SlaybaughLab/NIF_TNF_ETA/AsConstructed/Pics/Pics/Build1_15.jpg

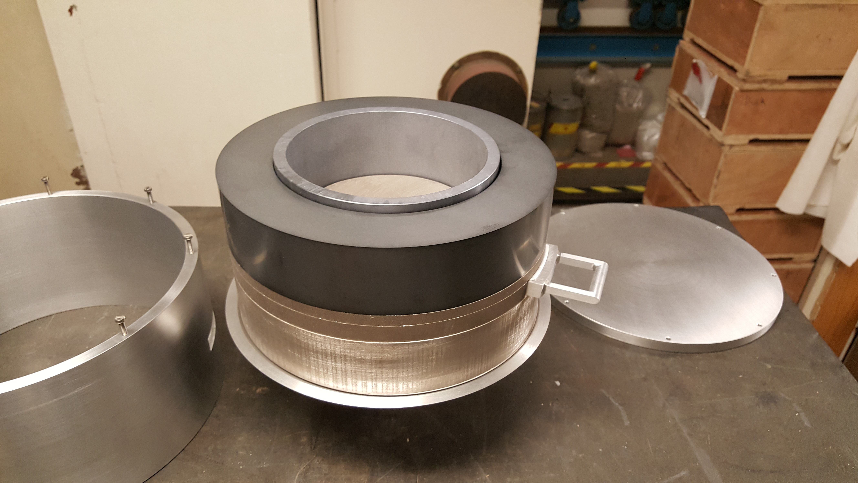
AsConstructed/Pics/Pics/Build1_15.jpg
