SlaybaughLab/NIF_TNF_ETA/README.md

# NIF_TNF_ETA
Files and models pertaining to the NIF technical nuclear forensics relevant ETA design

Contains
- Coues optimization inputs
- Coues optimization results and optimization history
- Engineering design change history and calculations
- CAD Models
- MCNP models
- Purchase documentation
