SlaybaughLab/NIF_TNF_ETA/AsConstructed/Plots/DPLUS_NIF_Spectrum.xlsx

Ebins | Nφ (n/cm2/src)
4.1399e-07 | 0
1.1253e-06 | 0
3.059e-06 | 0
1.0677e-05 | 0
2.9023e-05 | 2.049142865e-06
0.0001013 | 5.475043922e-06
0.00027536 | 5.184504351e-05
0.00058295 | 7.257542149e-05
0.0012341 | 0.0001356223635
0.0033546 | 0.0003378589862
0.010333 | 0.001431766824
0.021875 | 0.003682208308
0.024788 | 0.001050071611
0.034307 | 0.004819021139
0.052475 | 0.006794245399
0.11109 | 0.03135825653
0.15764 | 0.029007202
0.24724 | 0.04928293802
0.36883 | 0.06802948531
0.55023 | 0.0903172405
0.63928 | 0.04098251884
0.74274 | 0.04517834735
0.82085 | 0.03124598612
0.96164 | 0.05191853663
1.108 | 0.04648686331
1.4227 | 0.0757298235
1.8268 | 0.07184725941
2.3069 | 0.057593946
2.3852 | 0.007478118206
3.0119 | 0.04303795698
4.0657 | 0.03737023537
4.7237 | 0.01368997899
4.9659 | 0.003852857395
6.3763 | 0.01653024627
7.4082 | 0.008559772517
8.1873 | 0.005068655988
9.0484 | 0.005020305252
10 | 0.005631700306
11.052 | 0.006606451141
12.214 | 0.006479627161
12.523 | 0.001991034951
13.84 | 0.02424272049
14.191 | 0.1027588518
14.918 | 0.004288768289
16.905 | 2.981306371e-05
19.64 | 1.763008045e-06
