SlaybaughLab/NIF_TNF_ETA/AsConstructed/Plots/NIF Spectra.xlsx

 | SRC: Charlie Cerjan |  |  |  | Differential Flux |  | Lethargy
Energy (MeV) | N120405 Neutron Number (n) | Norm n | φ | Norm φ | dφ/dE | Norm dφ/dE | dφ/dLn[E] | Norm dφ/dLn[E]
1.038553e-06 | 0 | 0 | 0 | 0 | 0 | 0 | 0 | 0
1.11863e-06 | 0 | 0 | 0 | 0 | 0 | 0 | 0 | 0
1.204882e-06 | 0 | 0 | 0 | 0 | 0 | 0 | 0 | 0
1.297785e-06 | 0 | 0 | 0 | 0 | 0 | 0 | 0 | 0
1.39785e-06 | 0 | 0 | 0 | 0 | 0 | 0 | 0 | 0
1.505632e-06 | 0 | 0 | 0 | 0 | 0 | 0 | 0 | 0
1.621724e-06 | 0 | 0 | 0 | 0 | 0 | 0 | 0 | 0
1.746767e-06 | 0 | 0 | 0 | 0 | 4.228030379e+25 | 4.432080796e-06 | 7.666583564e+19 | 6.187456675e-13
1.881451e-06 | 6003293 | 6.179823806e-08 | 5.694480436e+18 | 2.439530876e-11 | 3.925332899e+25 | 4.114774729e-06 | 7.666521101e+19 | 6.187406263e-13
2.026521e-06 | 0 | 0 | 0 | 0 | 0 | 0 | 0 | 0
2.182776e-06 | 0 | 0 | 0 | 0 | 0 | 0 | 0 | 0
2.351079e-06 | 0 | 0 | 0 | 0 | 0 | 0 | 0 | 0
2.532359e-06 | 0 | 0 | 0 | 0 | 0 | 0 | 0 | 0
2.727616e-06 | 0 | 0 | 0 | 0 | 0 | 0 | 0 | 0
2.93793e-06 | 0 | 0 | 0 | 0 | 0 | 0 | 0 | 0
3.164459e-06 | 0 | 0 | 0 | 0 | 0 | 0 | 0 | 0
3.408454e-06 | 0 | 0 | 0 | 0 | 0 | 0 | 0 | 0
3.671264e-06 | 0 | 0 | 0 | 0 | 0 | 0 | 0 | 0
3.954337e-06 | 0 | 0 | 0 | 0 | 0 | 0 | 0 | 0
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
