SlaybaughLab/NIF_TNF_ETA/InitialQuoted/Drawings/ETA.png

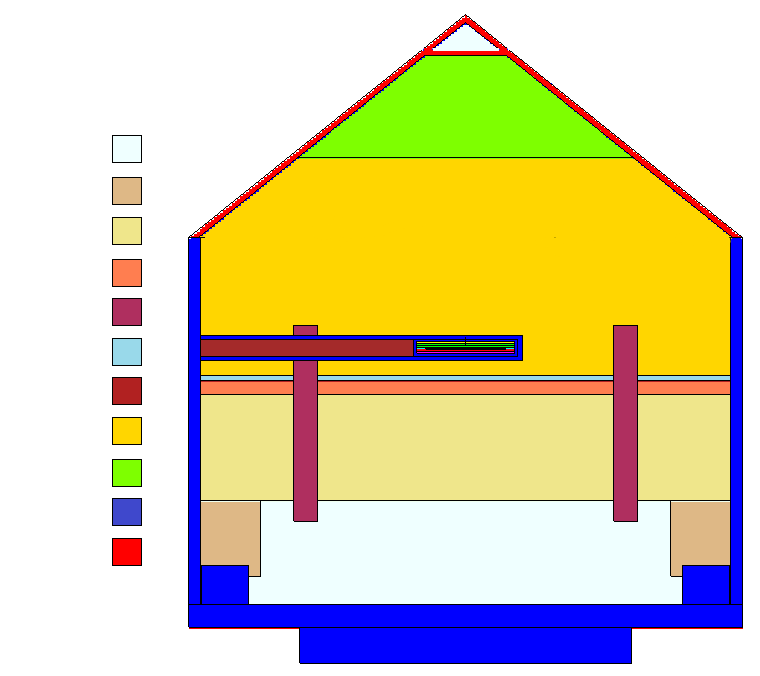
InitialQuoted/Drawings/ETA.png
