SlaybaughLab/NIF_TNF_ETA/InitialQuoted/Drawings/ETA_Design/Slide1.PNG

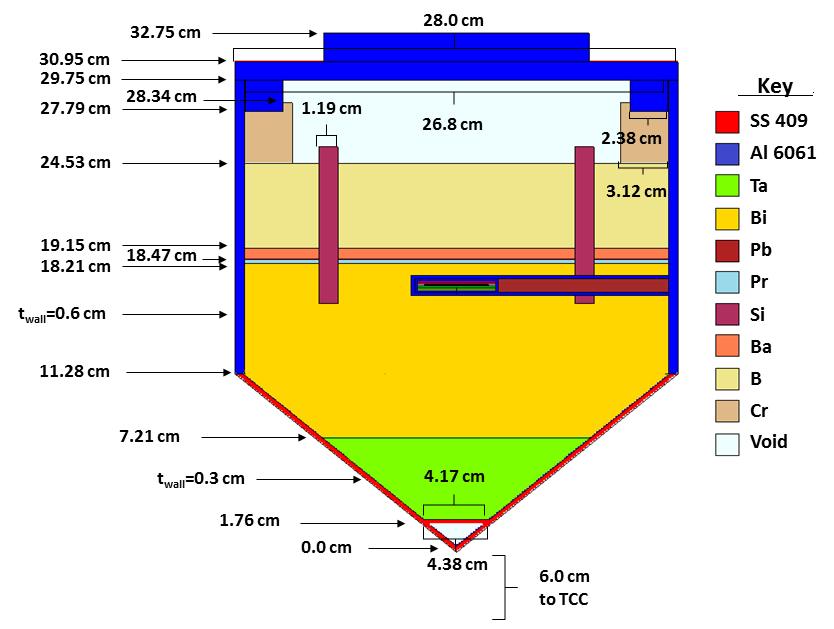
InitialQuoted/Drawings/ETA_Design/Slide1.PNG
