SlaybaughLab/NIF_TNF_ETA/InitialQuoted/Drawings/ETA_Design/Slide2.PNG

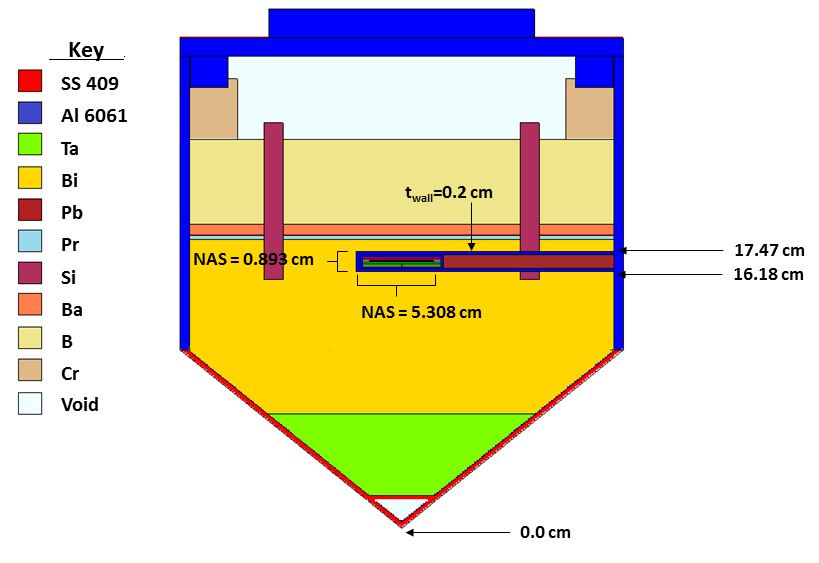
InitialQuoted/Drawings/ETA_Design/Slide2.PNG
