SlaybaughLab/NIF_TNF_ETA/InitialQuoted/Drawings/ETA_Design/Slide3.PNG

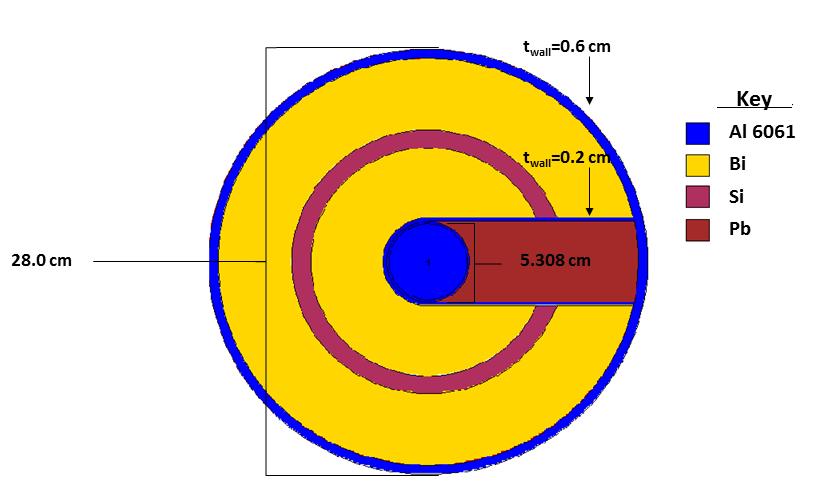
InitialQuoted/Drawings/ETA_Design/Slide3.PNG
