SlaybaughLab/NIF_TNF_ETA/InitialQuoted/Drawings/ETA_XY.png

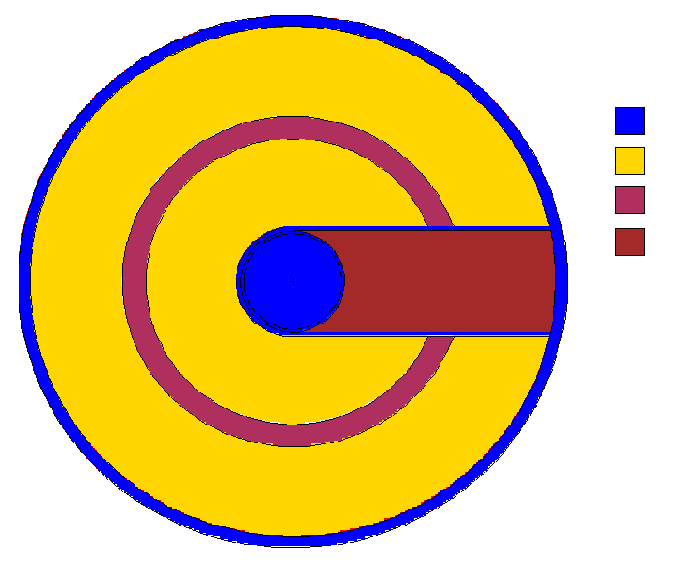
InitialQuoted/Drawings/ETA_XY.png
