SlaybaughLab/NIF_TNF_ETA/InitialQuoted/w_Dim/Plots/ETA_Output_NPhi.png

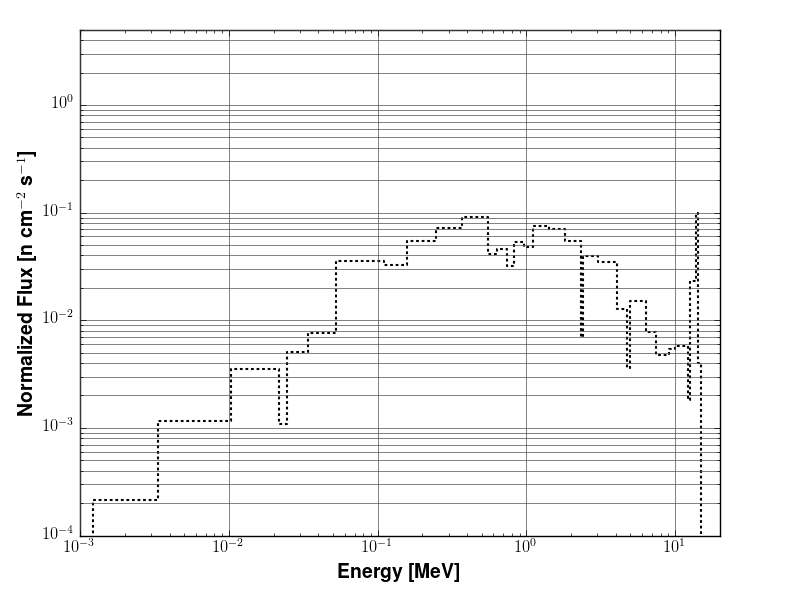
InitialQuoted/w_Dim/Plots/ETA_Output_NPhi.png
