SlaybaughLab/NIF_TNF_ETA/InitialQuoted/w_Dim/Plots/ETA_OutputComp_NPhi.png

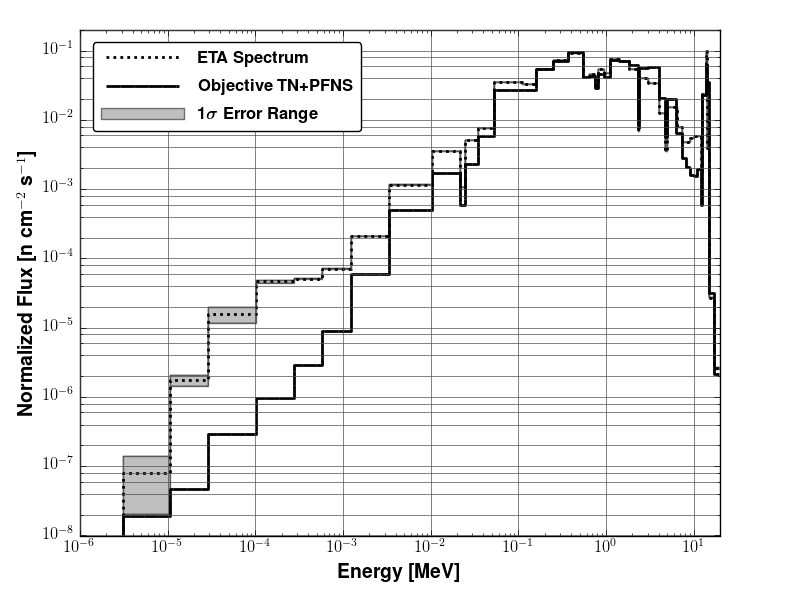
InitialQuoted/w_Dim/Plots/ETA_OutputComp_NPhi.png
