SlaybaughLab/NIF_TNF_ETA/InitialQuoted/w_Dim/Plots/ETA_R=0_Cut.png

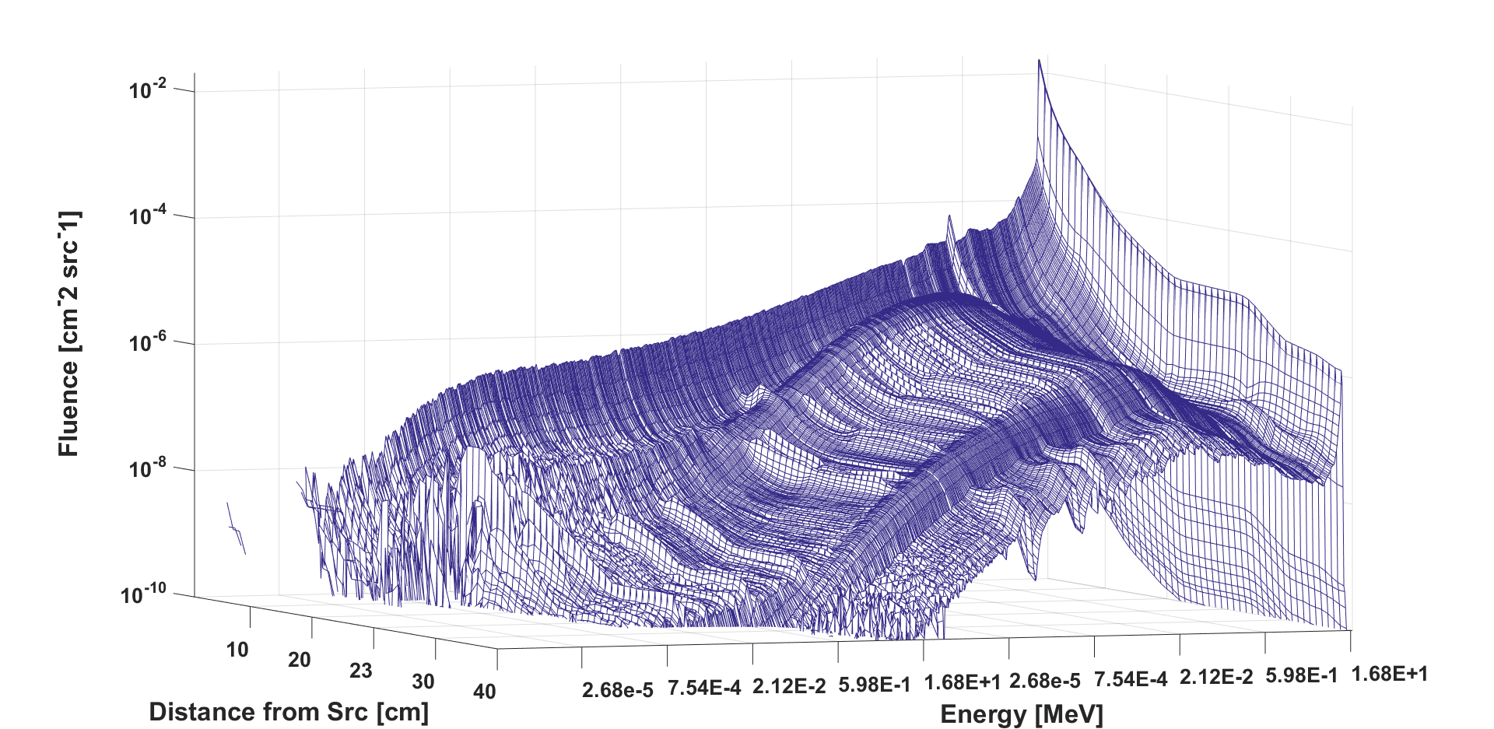
InitialQuoted/w_Dim/Plots/ETA_R=0_Cut.png
