SlaybaughLab/NIF_TNF_ETA/InitialQuoted/w_Dim/Plots/ETA_Z=28.85_Cut.png

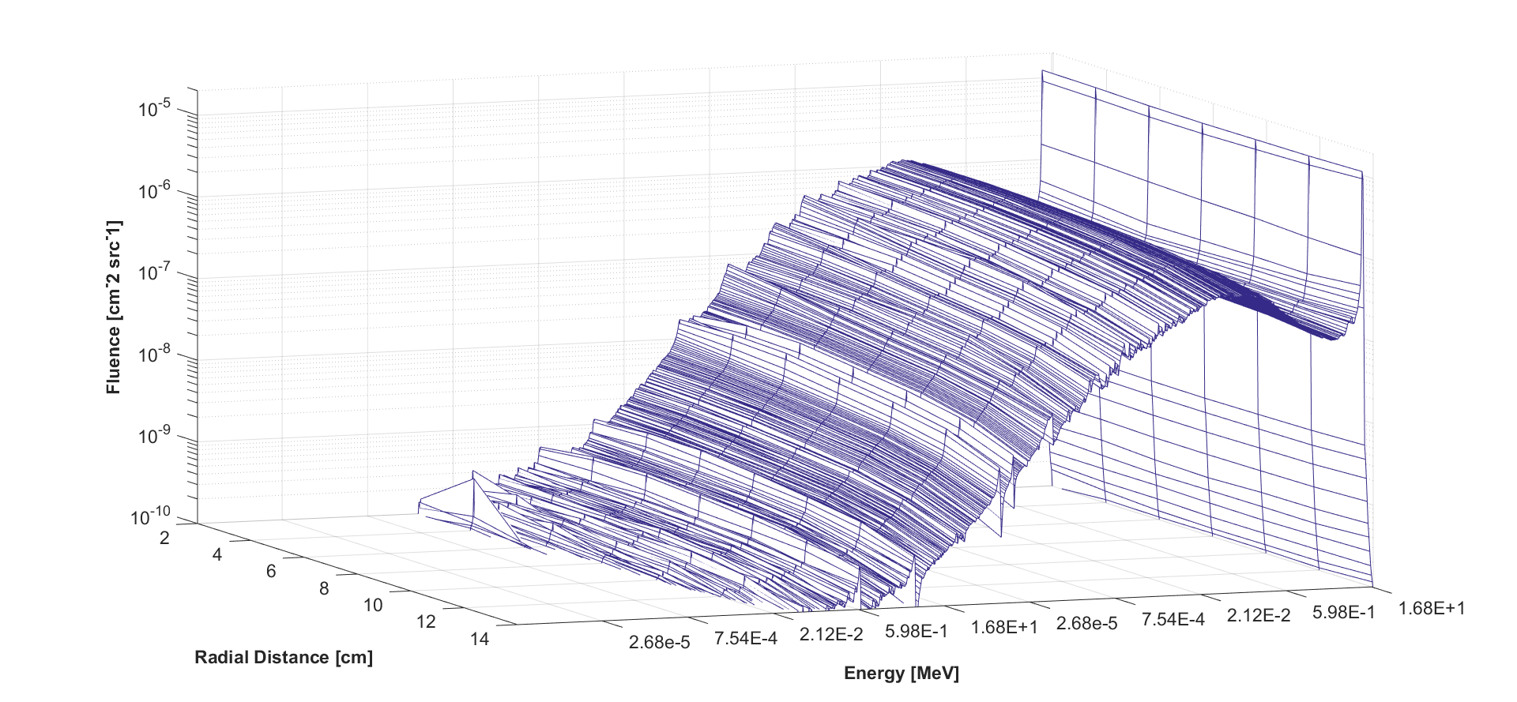
InitialQuoted/w_Dim/Plots/ETA_Z=28.85_Cut.png
