SlaybaughLab/NIF_TNF_ETA/InitialQuoted/w_Dim/Plots/FluxVsZ/ETA_24Jun16_z=2.bmp

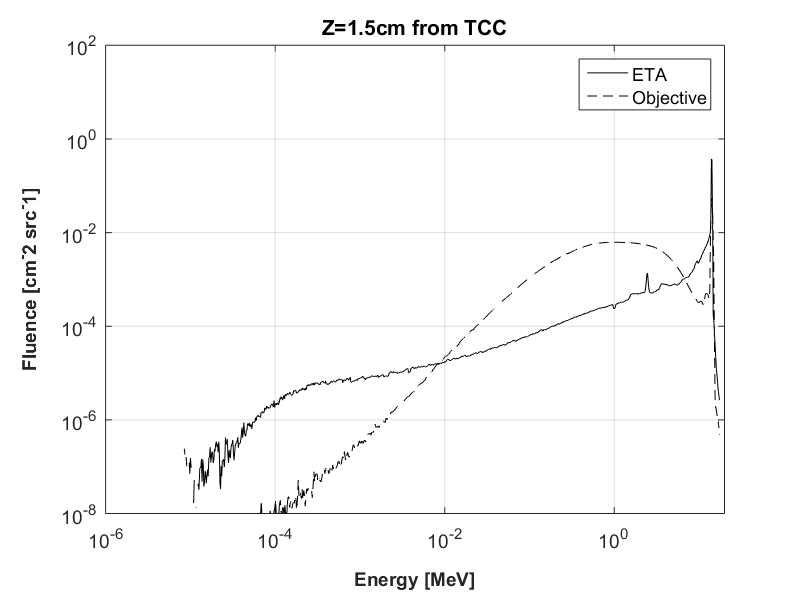
InitialQuoted/w_Dim/Plots/FluxVsZ/ETA_24Jun16_z=2.bmp
