SlaybaughLab/NIF_TNF_ETA/InitialQuoted/w_Dim/Plots/FluxVsZ/ETA_24Jun16_z=18.bmp

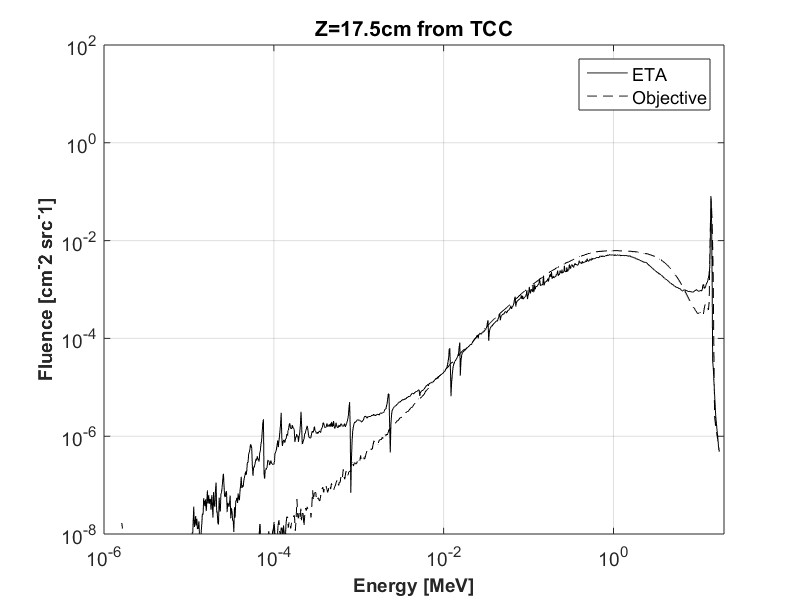
InitialQuoted/w_Dim/Plots/FluxVsZ/ETA_24Jun16_z=18.bmp
