SlaybaughLab/NIF_TNF_ETA/InitialQuoted/w_Dim/Plots/FluxVsZ/ETA_DPLUS_24Jun16_z=9.bmp

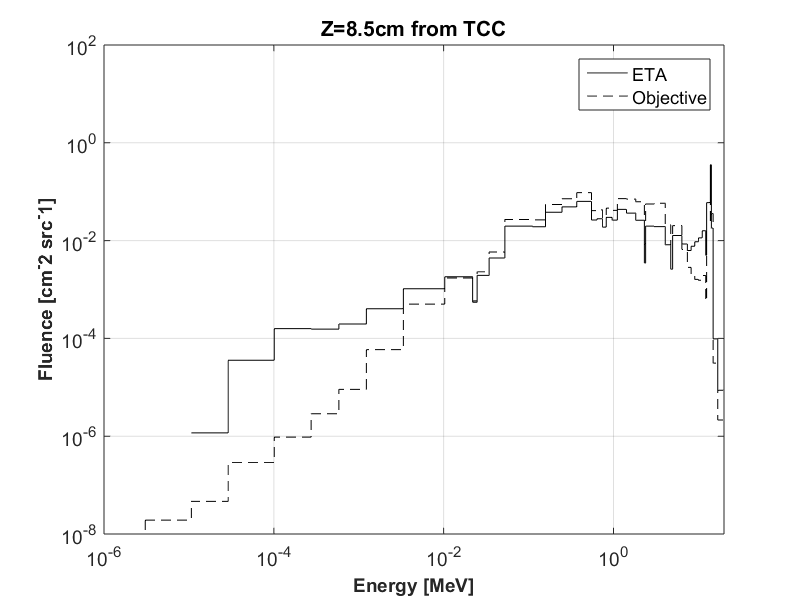
InitialQuoted/w_Dim/Plots/FluxVsZ/ETA_DPLUS_24Jun16_z=9.bmp
