SlaybaughLab/NIF_TNF_ETA/InitialQuoted/w_Dim/Plots/GroupFlux/ETA_24Jun16_PeakVsWatt.bmp

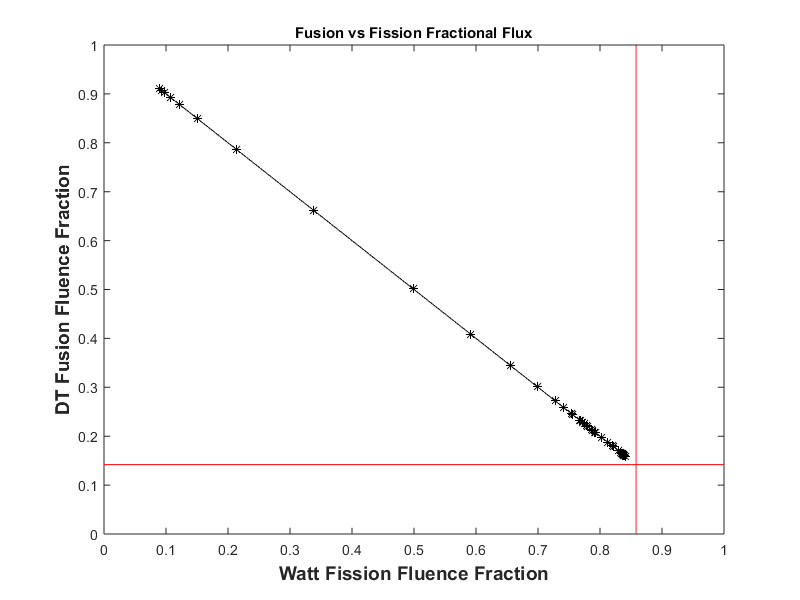
InitialQuoted/w_Dim/Plots/GroupFlux/ETA_24Jun16_PeakVsWatt.bmp
