SlaybaughLab/NIF_TNF_ETA/InitialQuoted/Purchasing/ETA_B4CQuote.pdf

The World’s Manufacturer of Engineered & Advanced Materials
MERELEX CORPORATION • 10884 WEYBURN AVE. LOS ANGELES, CA 90024
TEL. 310-208-0551 • FAX 310-208-0351 • E-MAIL: orders@americanelements.com

Customer Service Representative
Keri Keinath
Telephone: 310-208-3003
Fax: 310-564-1892
Email: keri.keinath@americanelements.com

James Bevins
University of California, Berkeley 4173 Etcheverry Hall

8657558090

DATE: | August 18, 2016
QUOTE VALIDITY: | September 1, 2016
RE: | Boron Carbide Plate
SHIPPING TERMS: | FOB Los Angeles, CA

160818KK06

Boron Carbide Plate | Formula: B4C
Diameter: 267mm
Thickness: 13.45mm
4 pieces | $1,707.27/pc

QUOTATION:

### PHONE:

TO:

MATERIAL | DESCRIPTION | QTY | UNIT PRICE

PN: BO-C-025M-PL
Purity: 99.5%

Shipping (Estimated)

United States

Berkeley, CA 94720

EMAIL: | jbevins1@berkeley.edu

TBD

PAYMENT TERMS: | Net 30 Days

This quotation is subject to American Elements' General Terms & Conditions. American Elements' general terms and conditions can be found on the back of this document, or if it is being transmitted electronically, a complete copy can always be reviewed and printed at www.americanelements.com/generalterms.pdf. © 2001-2014. American Elements. All rights reserved.
AECFORM 32:87 REV. APP. 9/15/04
