SlaybaughLab/NIF_TNF_ETA/InitialQuoted/Purchasing/ETA_MaterialsQuote.pdf

The World’s Manufacturer of Engineered & Advanced Materials
MERELEX CORPORATION • 10884 WEYBURN AVE. LOS ANGELES, CA 90024
TEL. 310-208-0551 • FAX 310-208-0351 • E-MAIL: orders@americanelements.com

Customer Service Representative
Keri Keinath
Telephone: 310-208-3003
Fax: 310-564-1892
Email: keri.keinath@americanelements.com

James Bevins
University of California, Berkeley 4173 Etcheverry Hall

8657558090

DATE: | August 12, 2016
QUOTE VALIDITY: | August 26, 2016
RE: | Aluminum Metal Plate
SHIPPING TERMS: | FOB Los Angeles, CA

160812KK02

Aluminum Metal Plate | OD: 267mm
ID: 219mm
Thickness: 19.6mm
1 piece | $432.22/pc

Boron Metal Plate

Barium Metal Plate

Diameter: 267mm
Thickness: 18mm

Diameter: 267mm
Thickness: 6.8mm

3 pieces

1 piece

$9,200.53/pc

$2,548.55/pc

QUOTATION:

### PHONE:

TO:

MATERIAL | DESCRIPTION | QTY | UNIT PRICE

PN: AL-M-03M-PL

PN: BO-M-03M-PL

PN: BA-M-03M-PL

Purity: 99.9% (metals basis)

Purity: 99.9% (metals basis)

Purity: 99.9% (metals basis)

Shipping (Estimated)

United States

Berkeley, CA 94720

EMAIL: | jbevins1@berkeley.edu

TBD

PAYMENT TERMS: | Net 30 Days

*Price valid upon purchasing all items quoted

This quotation is subject to American Elements' General Terms & Conditions. American Elements' general terms and conditions can be found on the back of this document, or if it is being transmitted electronically, a complete copy can always be reviewed and printed at www.americanelements.com/generalterms.pdf. © 2001-2014. American Elements. All rights reserved.
AECFORM 32:87 REV. APP. 9/15/04

The World’s Manufacturer of Engineered & Advanced Materials
MERELEX CORPORATION • 10884 WEYBURN AVE. LOS ANGELES, CA 90024
TEL. 310-208-0551 • FAX 310-208-0351 • E-MAIL: orders@americanelements.com

Customer Service Representative
Keri Keinath
Telephone: 310-208-3003
Fax: 310-564-1892
Email: keri.keinath@americanelements.com

James Bevins
University of California, Berkeley 4173 Etcheverry Hall

8657558090

DATE: | August 12, 2016
QUOTE VALIDITY: | August 26, 2016
RE: | Aluminum Metal Plate
SHIPPING TERMS: | FOB Los Angeles, CA

160812KK02

Bismuth Metal Plate | OD (upper): 165.9mm
OD (bottom): 267mm
Height: 40.7mm
1 piece | $3,385.80/pc

Bismuth Metal Plate

Bismuth Metal Plate

Diameter: 267mm
Thickness: 49mm

Diameter: 267mm
Thickness: 7.4mm

1 piece

1 piece

$1,656.10/pc

$1,545.69/pc

QUOTATION:

### PHONE:

TO:

MATERIAL | DESCRIPTION | QTY | UNIT PRICE

PN: BI-M-03M-PL

PN: BI-M-03M-PL

PN: BI-M-03M-PL

Purity: 99.9% (metals basis)

Purity: 99.9% (metals basis)

Purity: 99.9% (metals basis)

Shipping (Estimated)

United States

Berkeley, CA 94720

EMAIL: | jbevins1@berkeley.edu

TBD

PAYMENT TERMS: | Net 30 Days

*Price valid upon purchasing all items quoted

The World’s Manufacturer of Engineered & Advanced Materials
MERELEX CORPORATION • 10884 WEYBURN AVE. LOS ANGELES, CA 90024
TEL. 310-208-0551 • FAX 310-208-0351 • E-MAIL: orders@americanelements.com

Customer Service Representative
Keri Keinath
Telephone: 310-208-3003
Fax: 310-564-1892
Email: keri.keinath@americanelements.com

James Bevins
University of California, Berkeley 4173 Etcheverry Hall

8657558090

DATE: | August 12, 2016
QUOTE VALIDITY: | August 26, 2016
RE: | Aluminum Metal Plate
SHIPPING TERMS: | FOB Los Angeles, CA

160812KK02

Chromium Metal Plate | OD: 267mm
ID: 204mm
Thickness: 38.1mm
1 piece | $4,342.65/pc

Lead Metal Plate

Praseodymium Metal Plate

Size: 133.5mm x 53.2mm
Thickness: 8.9mm

Diameter: 267mm
Thickness: 2.6mm

1 piece

1 piece

$184.01/pc

$2,208.13/pc

QUOTATION:

### PHONE:

TO:

MATERIAL | DESCRIPTION | QTY | UNIT PRICE

PN: CR-M-03M-PL

PN: PB-M-03M-PL

PN: PR-M-025M-PL

Purity: 99.9% (metals basis)

Purity: 99.9% (metals basis)

Purity: 99.5% (metals basis)

Shipping (Estimated)

United States

Berkeley, CA 94720

EMAIL: | jbevins1@berkeley.edu

TBD

PAYMENT TERMS: | Net 30 Days

*Price valid upon purchasing all items quoted

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

James Bevins
University of California, Berkeley 4173 Etcheverry Hall

8657558090

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

160812KK02

Silicon Metal Plate | OD: 174mm
ID: 150mm
Thickness: 4.7mm
1 piece | $312.82/pc

Silicon Metal Plate

Silicon Metal Plate

OD: 174mm
ID: 150mm
Thickness: 12.9

OD: 174mm
ID: 150mm
Thickness: 81.1

1 piece

1 piece

$364.34/pc

$736.04/pc

QUOTATION:

### PHONE:

TO:

MATERIAL | DESCRIPTION | QTY | UNIT PRICE

PN: SI-M-03M-PL

PN: SI-M-03M-PL

PN: SI-M-03M-PL

Purity: 99.9% (metals basis)

Purity: 99.9% (metals basis)

Purity: 99.5% (metals basis)

Shipping (Estimated)

United States

Berkeley, CA 94720

EMAIL: | jbevins1@berkeley.edu

TBD

PAYMENT TERMS: | Net 30 Days

*Price valid upon purchasing all items quoted

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

James Bevins
University of California, Berkeley 4173 Etcheverry Hall

8657558090

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

160812KK02

Tantalum Metal Plate | OD (upper): 41.12mm
OD (bottom): 169mm
Height: 51.5mm
1 piece | $18,392.06/pc

QUOTATION:

### PHONE:

TO:

MATERIAL | DESCRIPTION | QTY | UNIT PRICE

PN: TA-M-03M-PL
Purity: 99.9% (metals basis)

Shipping (Estimated)

United States

Berkeley, CA 94720

EMAIL: | jbevins1@berkeley.edu

TBD

PAYMENT TERMS: | Net 30 Days

*Price valid upon purchasing all items quoted
