SlaybaughLab/NIF_TNF_ETA/AsConstructed/Purchasing/Machine_Shop_OrderForm.pdf

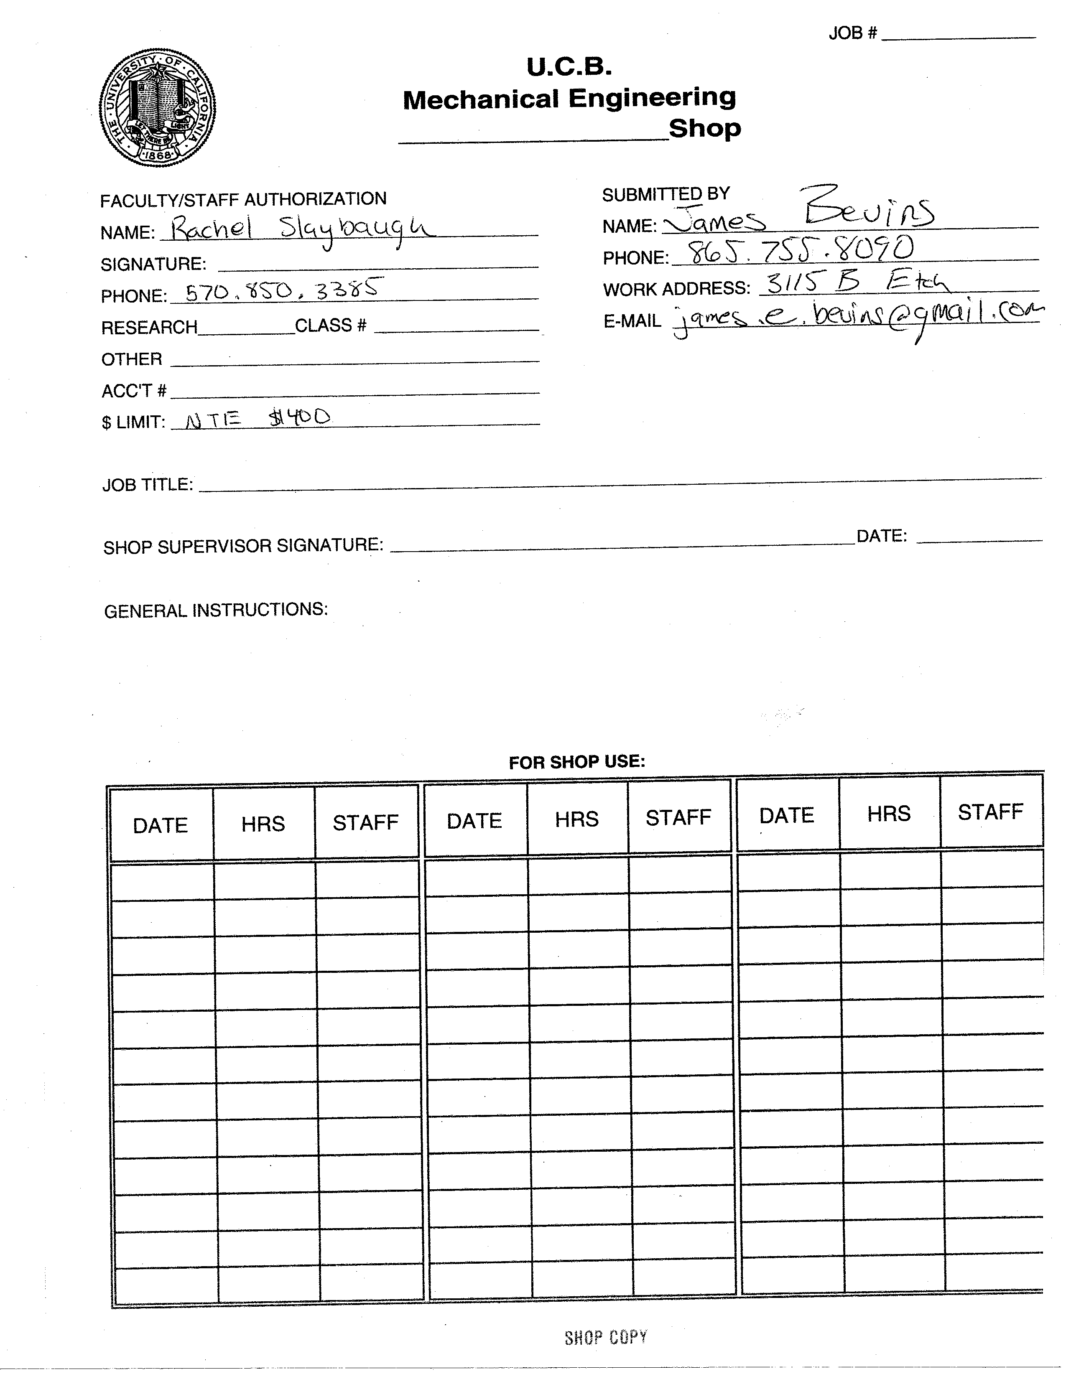
[picture p25: page 1]
