SlaybaughLab/NIF_TNF_ETA/AsConstructed/Purchasing/ETA_Component_Cost Breakdown.xlsx

Part | Materials | Machining | Total
Case1 |  | $2284.20 | $2284.20
Case2 |  | $2983.50 | $2983.50
Case3 |  | $1351.80 | $1351.80
W | $2045.70 | $1124.20 | $3169.90
Bi_1 | $3385.80 | $5657.80 | $9043.60
Bi_2 | $3494.50 | $5316.10 | $8810.60
Bi_3_a/b | $1556.10 | $3753.60 | $5309.70
Bi_4_a/b | $1545.69 | $2486.81 | $4032.50
Si_2 | $364.34 | $1104.06 | $1468.40
Si_3 | $736.04 | $1315.16 | $2051.20
Pr_a/b | $5775.11 | $388.09 | $6163.20
B4C_a/b | $1707.27 | $12510.63 | $14217.90
Drawer Bottom |  | $1305.30 | $1305.30
Drawer Cover |  | $1305.30 | $1305.30
Pb | $184.01 | $1634.09 | $1818.10
Drawer Handle |  | $1538.40 | $1538.40
TOTALS: | $20794.56 | $46059.04 | $66853.60
