SlaybaughLab/NIF_TNF_ETA/AsConstructed/CAD_Models/ETA_3.SLDASM

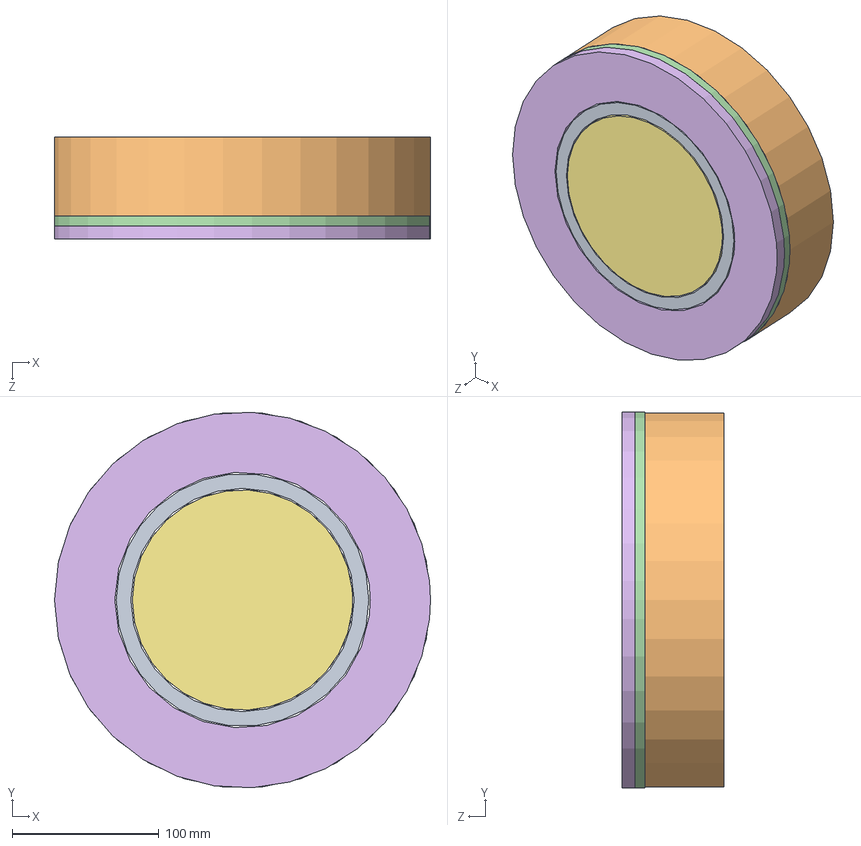
[picture p26: CAD file, 2017-06-17]
AsConstructed/CAD_Models/ETA_3.SLDASM
256.0 x 255.7 x 69.7 mm
Si_3
B4C_a_m
B4C_b_m
Ba_a_m
Ba_b_m
Bi_4a_m
Bi_4b_m
