SlaybaughLab/NIF_TNF_ETA/AsConstructed/CAD_Models/ETA_1.SLDASM

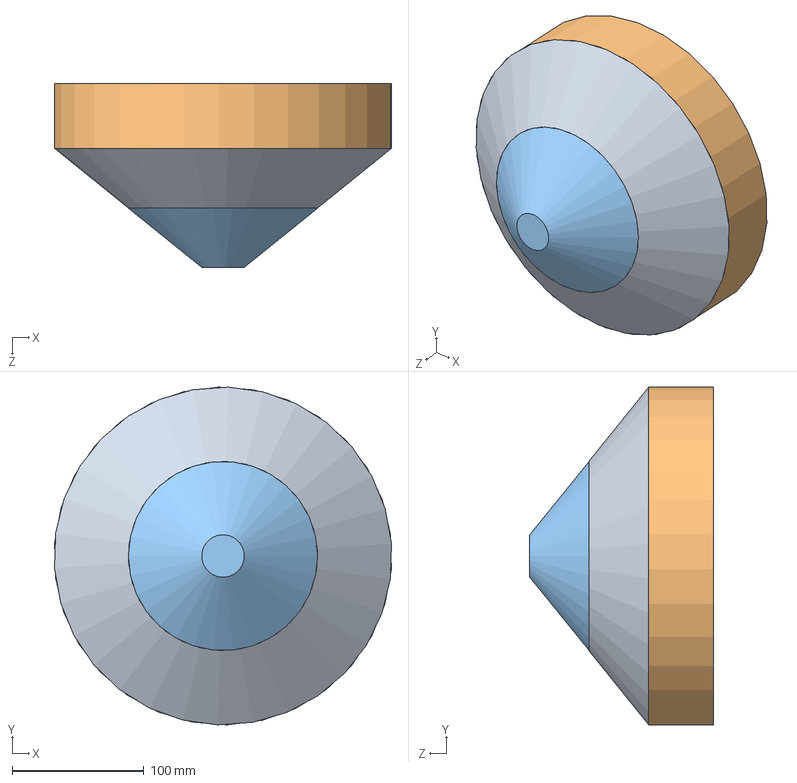
[picture p28: CAD file, 2017-06-17]
AsConstructed/CAD_Models/ETA_1.SLDASM
255.3 x 255.9 x 139.2 mm
Bi_1
Bi_2
W
