SlaybaughLab/NIF_TNF_ETA/InitialQuoted/Drawings/ETA_CAD_Model/ETA_2.SLDASM

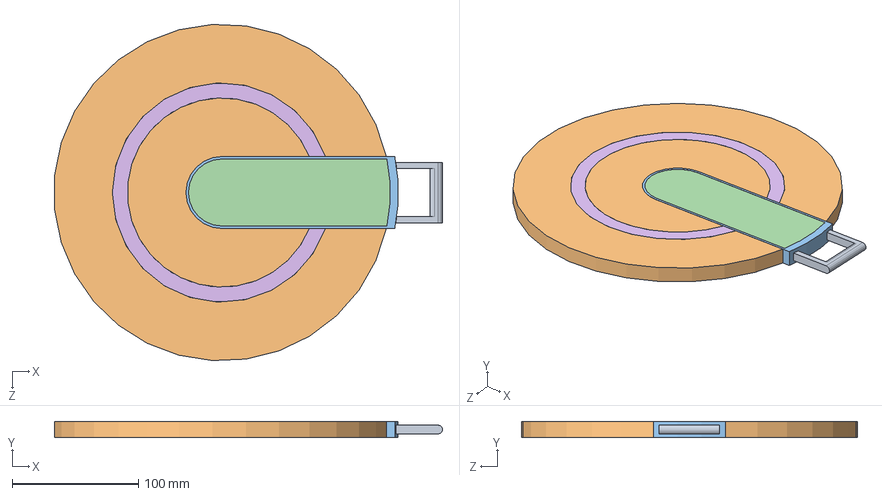
[picture p29: CAD file, 2017-06-17]
InitialQuoted/Drawings/ETA_CAD_Model/ETA_2.SLDASM
307.7 x 13.0 x 266.6 mm
Bi_3_m
Drawer
Drawer_Cover
Pb
Drawer_Handle
Si_2_m
