SlaybaughLab/NIF_TNF_ETA/AsConstructed/CAD_Models/ETA_2.SLDASM

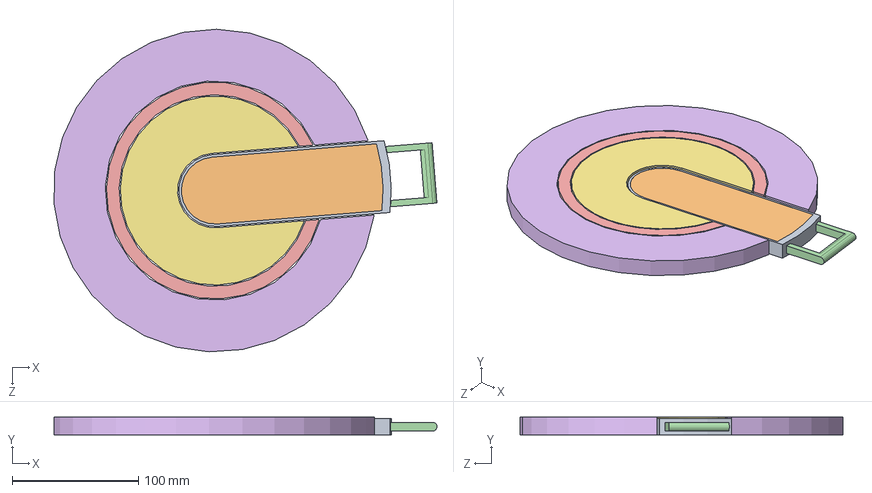
[picture p30: CAD file, 2017-06-17]
AsConstructed/CAD_Models/ETA_2.SLDASM
303.9 x 13.9 x 255.9 mm
Drawer
Drawer_Cover
Pb
Drawer_Handle
Si_2_m
Bi_3a_m
Bi_3b_m
