SlaybaughLab/NIF_TNF_ETA/AsConstructed/CAD_Models/Drawer.SLDASM

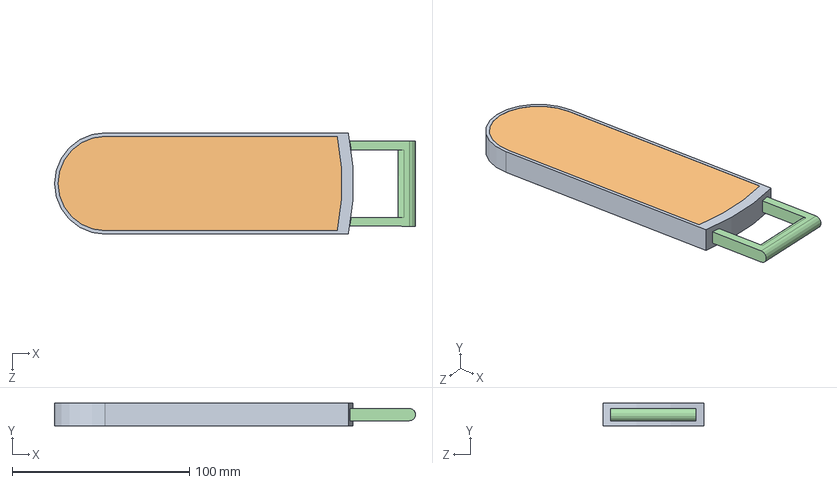
[picture p31: CAD file, 2017-06-17]
AsConstructed/CAD_Models/Drawer.SLDASM
203.5 x 12.9 x 57.1 mm
Drawer
Drawer_Cover
Pb
Drawer_Handle
