SlaybaughLab/NIF_TNF_ETA/InitialQuoted/Drawings/ETA_CAD_Model/ETA_3.SLDASM

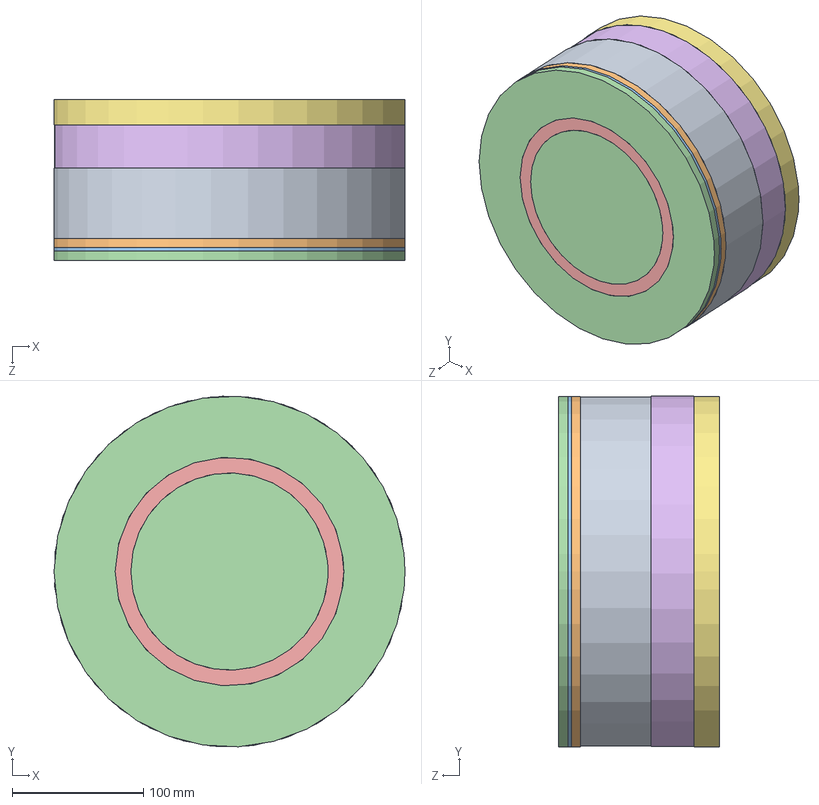
[picture p32: CAD file, 2017-06-17]
InitialQuoted/Drawings/ETA_CAD_Model/ETA_3.SLDASM
267.0 x 266.7 x 122.8 mm
B_m
Ba_m
Pr_m
Bi_4_m
Si_3
Cr_m
Al
