SlaybaughLab/NIF_TNF_ETA/InitialQuoted/Drawings/ETA_CAD_Model/ETA_1.SLDASM

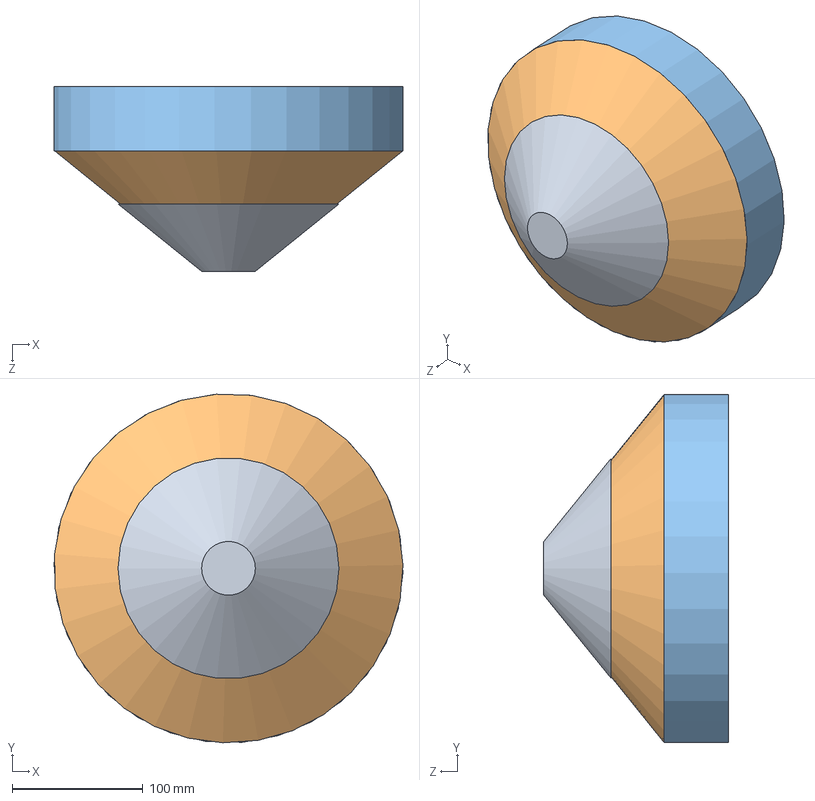
[picture p33: CAD file, 2017-06-17]
InitialQuoted/Drawings/ETA_CAD_Model/ETA_1.SLDASM
266.9 x 266.6 x 141.2 mm
Ta
Bi_1
Bi_2_m
Si_1
