SlaybaughLab/NIF_TNF_ETA/AsConstructed/CAD_Models/Machined Parts/B4C_a_m.SLDPRT

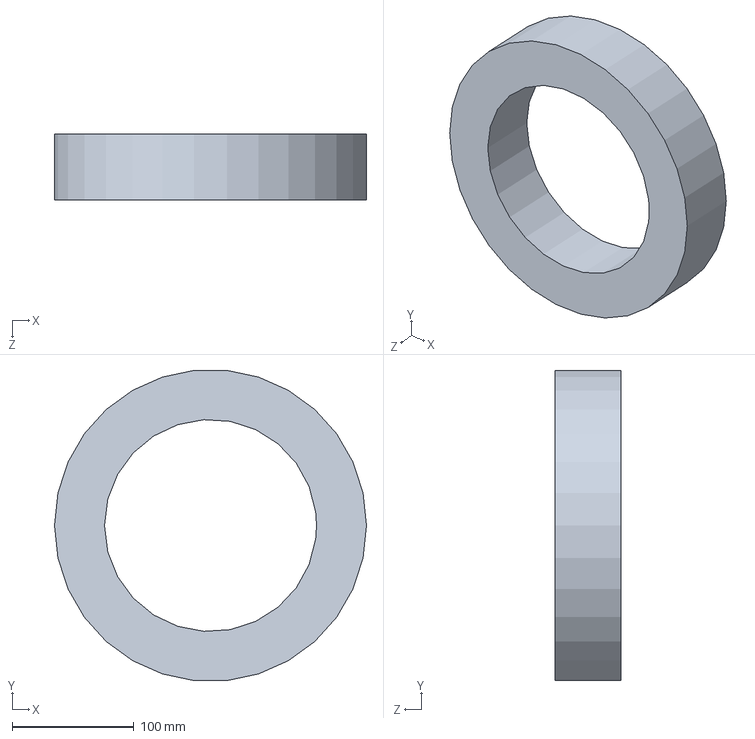
[picture p34: CAD file, 2017-06-17]
AsConstructed/CAD_Models/Machined Parts/B4C_a_m.SLDPRT
256.0 x 254.6 x 53.8 mm
