SlaybaughLab/NIF_TNF_ETA/AsConstructed/CAD_Models/Solid Parts/Pb.SLDPRT

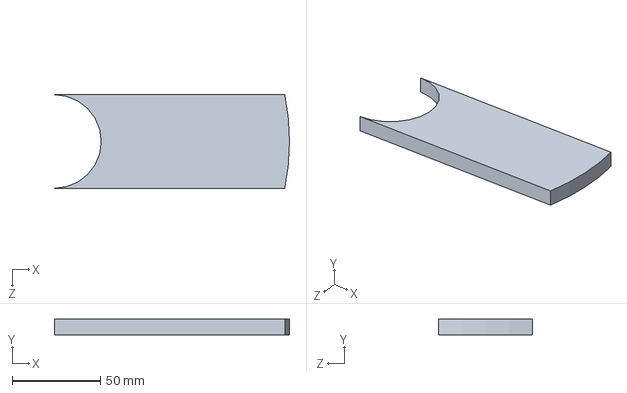
[picture p35: CAD file, 2017-06-17]
AsConstructed/CAD_Models/Solid Parts/Pb.SLDPRT
133.5 x 8.90 x 53.1 mm
