SlaybaughLab/NIF_TNF_ETA/InitialQuoted/Drawings/ETA_CAD_Model/Machined/Case_3.SLDPRT

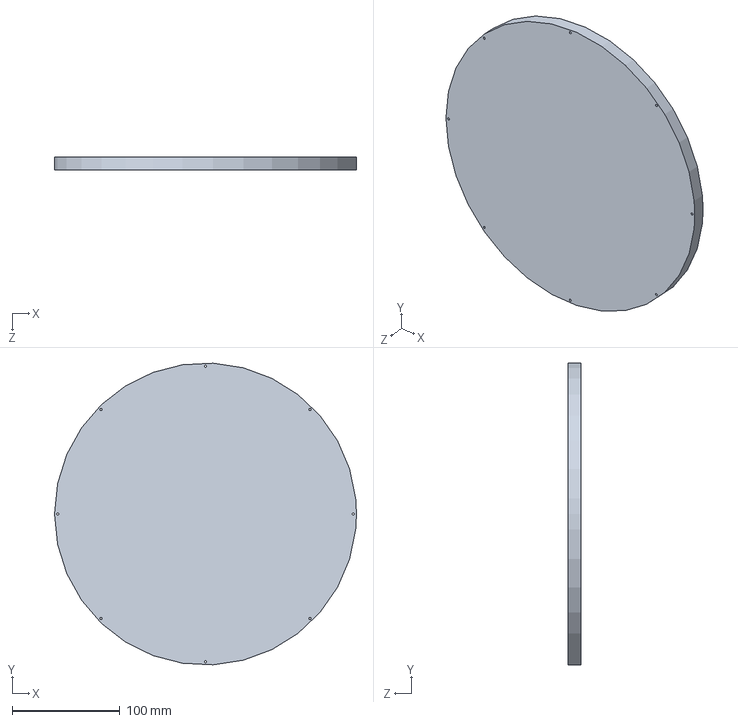
[picture p36: CAD file, 2017-06-17]
InitialQuoted/Drawings/ETA_CAD_Model/Machined/Case_3.SLDPRT
280.0 x 279.6 x 12.0 mm
