SlaybaughLab/NIF_TNF_ETA/InitialQuoted/Drawings/ETA_CAD_Model/Solid/Si_1.SLDPRT

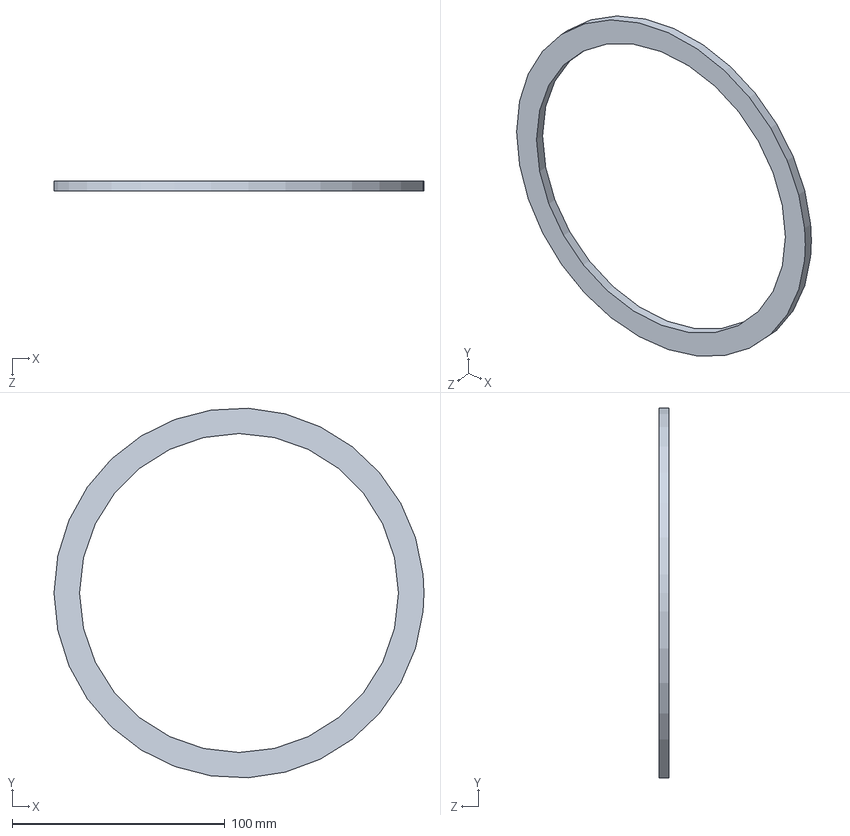
[picture p37: CAD file, 2017-06-17]
InitialQuoted/Drawings/ETA_CAD_Model/Solid/Si_1.SLDPRT
174.0 x 173.8 x 4.70 mm
