SlaybaughLab/NIF_TNF_ETA/AsConstructed/CAD_Models/Machined Parts/Drawer_Cover.SLDPRT

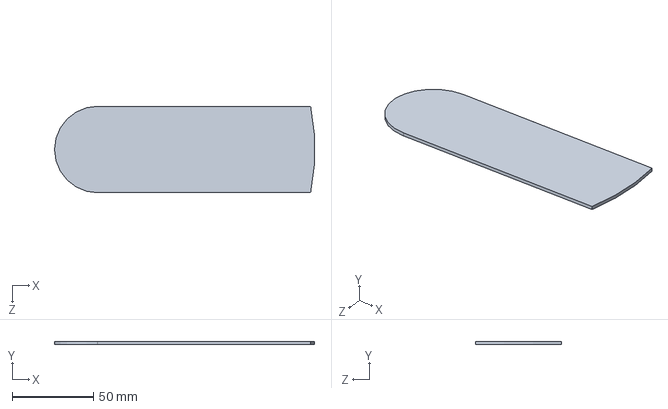
[picture p38: CAD file, 2017-06-17]
AsConstructed/CAD_Models/Machined Parts/Drawer_Cover.SLDPRT
159.8 x 1.95 x 53.1 mm
