SlaybaughLab/NIF_TNF_ETA/AsConstructed/CAD_Models/Solid Parts/B4C.SLDPRT

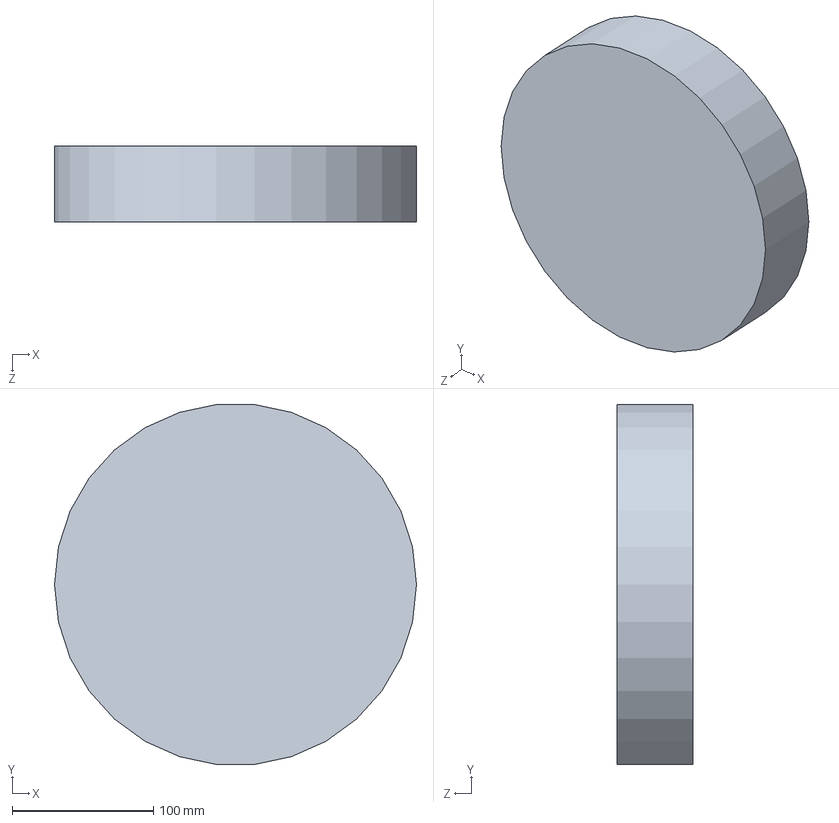
[picture p39: CAD file, 2017-06-17]
AsConstructed/CAD_Models/Solid Parts/B4C.SLDPRT
256.0 x 254.6 x 53.8 mm
