SlaybaughLab/NIF_TNF_ETA/AsConstructed/CAD_Models/Machined Parts/B4C_b_m.SLDPRT

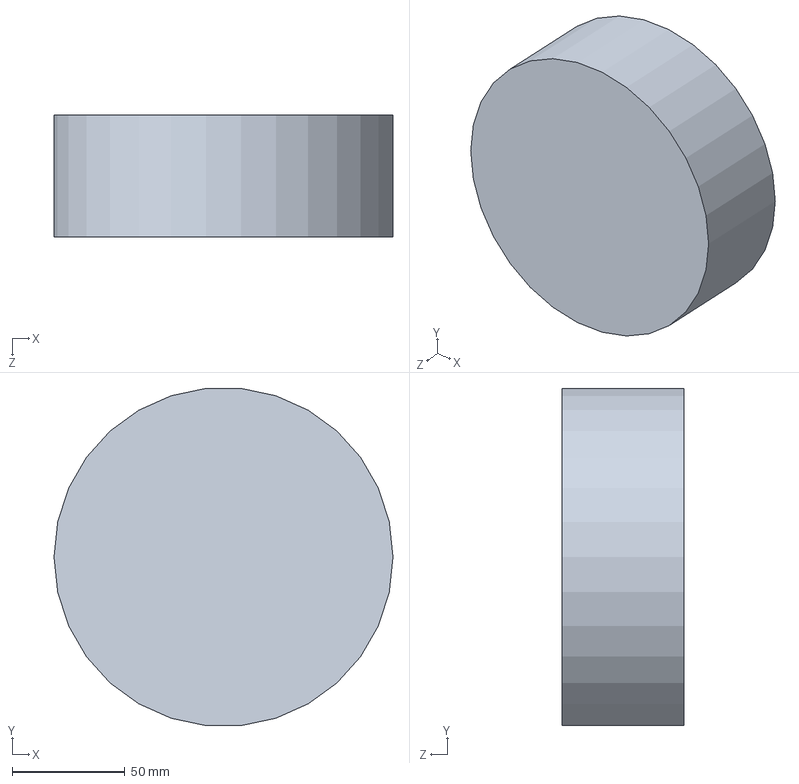
[picture p41: CAD file, 2017-06-17]
AsConstructed/CAD_Models/Machined Parts/B4C_b_m.SLDPRT
150.0 x 149.2 x 53.8 mm
