SlaybaughLab/NIF_TNF_ETA/AsConstructed/CAD_Models/Solid Parts/Bi_2.SLDPRT

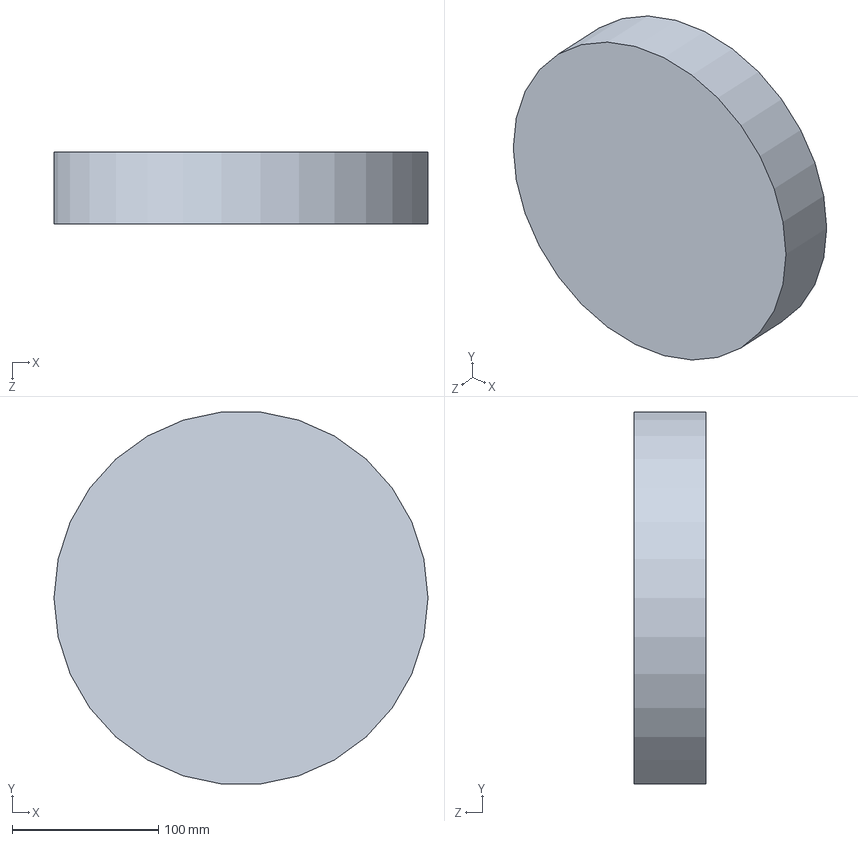
[picture p42: CAD file, 2017-06-17]
AsConstructed/CAD_Models/Solid Parts/Bi_2.SLDPRT
256.0 x 254.6 x 49.0 mm
