SlaybaughLab/NIF_TNF_ETA/InitialQuoted/Drawings/ETA_CAD_Model/Machined/Drawer.SLDPRT

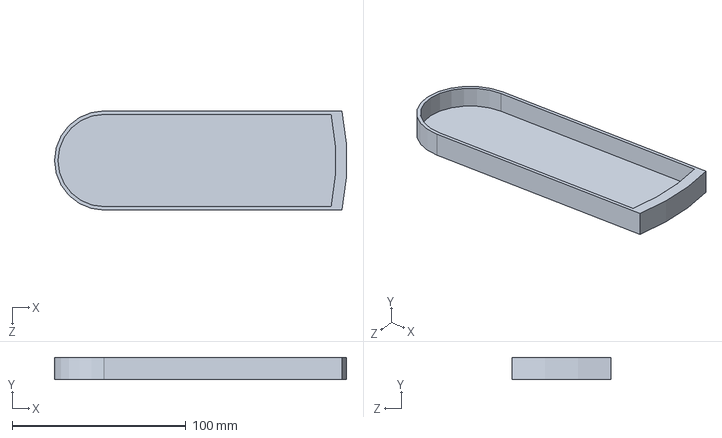
[picture p43: CAD file, 2017-06-17]
InitialQuoted/Drawings/ETA_CAD_Model/Machined/Drawer.SLDPRT
168.2 x 12.9 x 57.1 mm
