SlaybaughLab/NIF_TNF_ETA/InitialQuoted/Drawings/ETA_CAD_Model/Solid/Al.SLDPRT

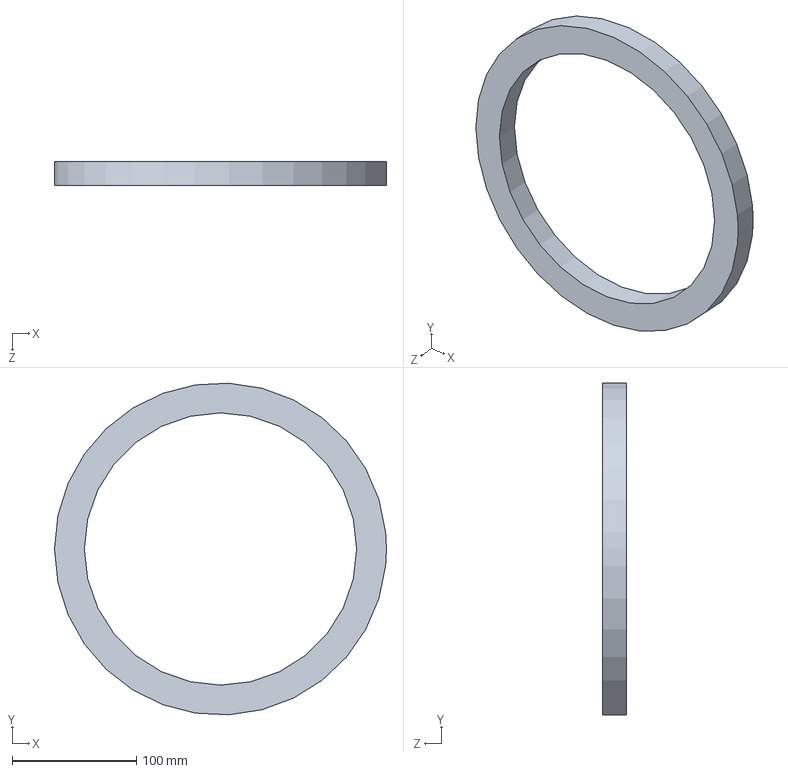
[picture p44: CAD file, 2017-06-17]
InitialQuoted/Drawings/ETA_CAD_Model/Solid/Al.SLDPRT
267.0 x 266.7 x 19.6 mm
