SlaybaughLab/NIF_TNF_ETA/AsConstructed/CAD_Models/Machined Parts/Drawer_Handle.SLDPRT

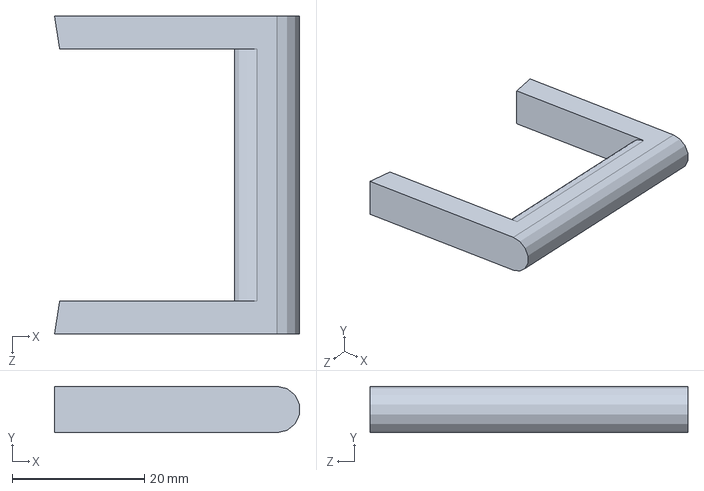
[picture p45: CAD file, 2017-06-17]
AsConstructed/CAD_Models/Machined Parts/Drawer_Handle.SLDPRT
37.0 x 7.00 x 48.0 mm
