SlaybaughLab/NIF_TNF_ETA/AsConstructed/CAD_Models/Solid Parts/Si_2.SLDPRT

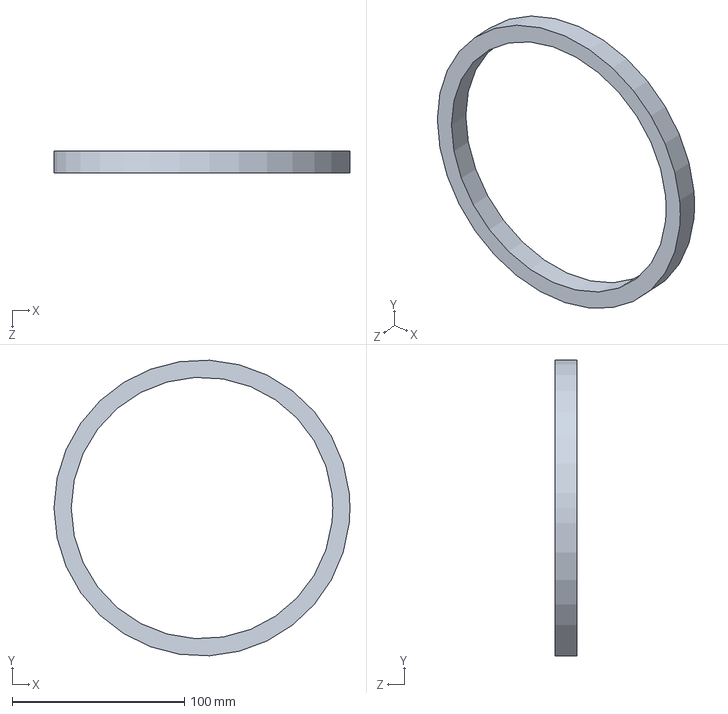
[picture p46: CAD file, 2017-06-17]
AsConstructed/CAD_Models/Solid Parts/Si_2.SLDPRT
172.0 x 171.8 x 13.0 mm
