SlaybaughLab/NIF_TNF_ETA/InitialQuoted/Drawings/ETA_CAD_Model/Machined/B_m.SLDPRT

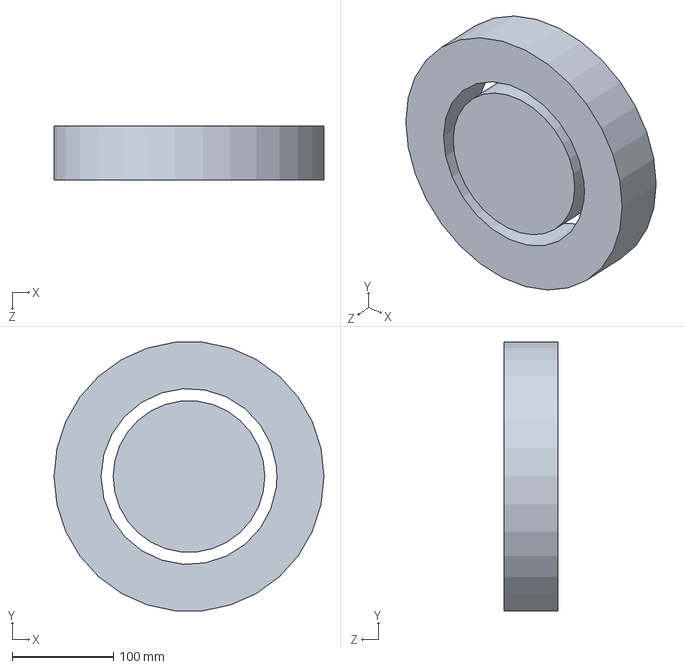
[picture p47: CAD file, 2017-06-17]
InitialQuoted/Drawings/ETA_CAD_Model/Machined/B_m.SLDPRT
267.0 x 265.5 x 53.8 mm
