SlaybaughLab/NIF_TNF_ETA/InitialQuoted/Drawings/ETA_CAD_Model/Solid/Ta.SLDPRT

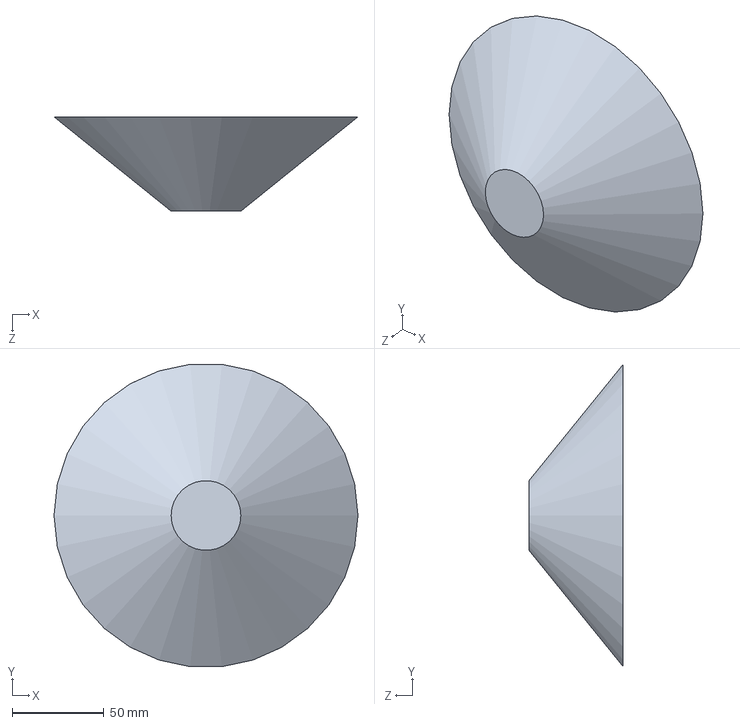
[picture p48: CAD file, 2017-06-17]
InitialQuoted/Drawings/ETA_CAD_Model/Solid/Ta.SLDPRT
165.9 x 165.0 x 51.5 mm
