SlaybaughLab/NIF_TNF_ETA/AsConstructed/CAD_Models/Machined Parts/Bi_4b_m.SLDPRT

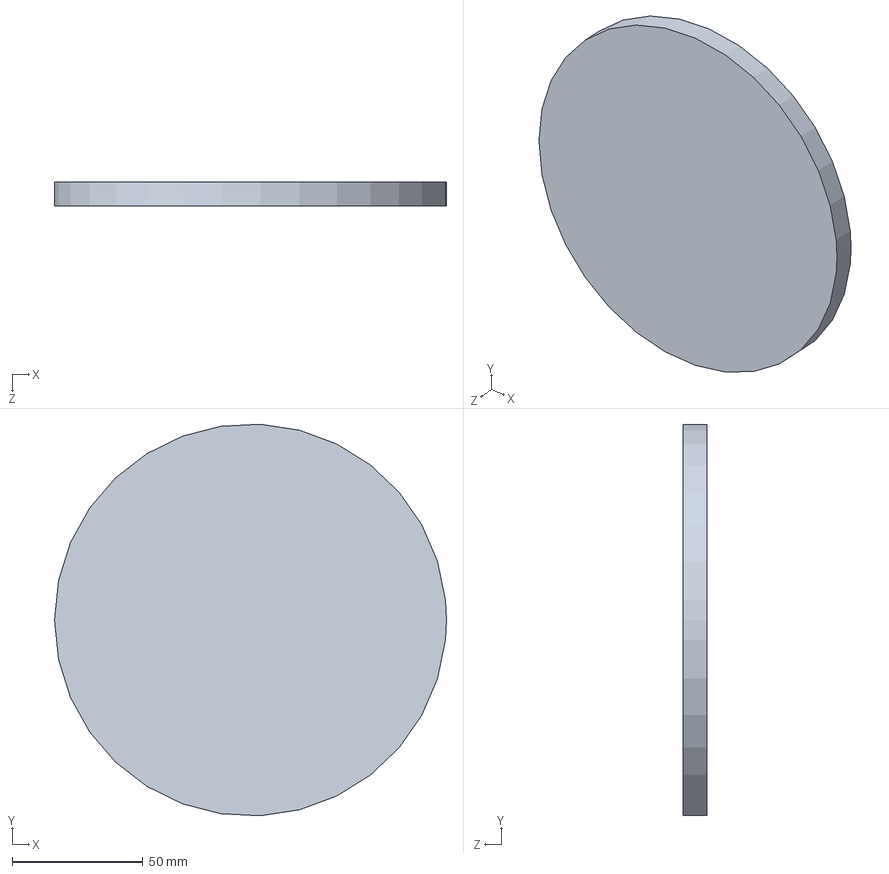
[picture p49: CAD file, 2017-06-17]
AsConstructed/CAD_Models/Machined Parts/Bi_4b_m.SLDPRT
150.0 x 149.8 x 9.10 mm
