SlaybaughLab/NIF_TNF_ETA/AsConstructed/CAD_Models/Solid Parts/Bi_3b.SLDPRT

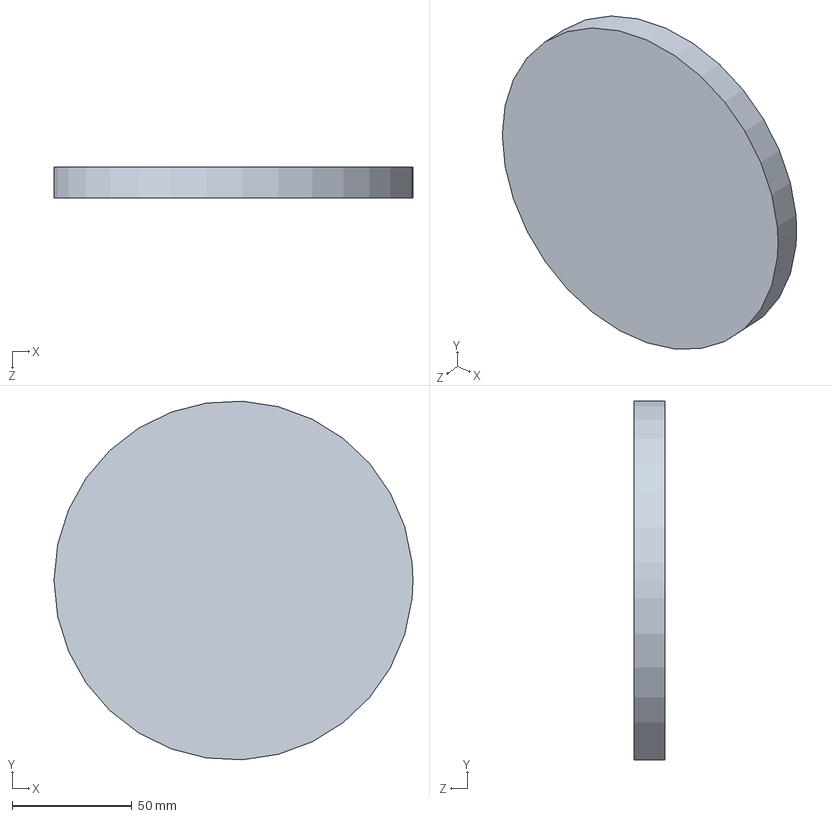
[picture p50: CAD file, 2017-06-17]
AsConstructed/CAD_Models/Solid Parts/Bi_3b.SLDPRT
150.0 x 149.8 x 13.0 mm
