SlaybaughLab/NIF_TNF_ETA/InitialQuoted/Drawings/ETA_CAD_Model/Machined/Bi_3_m.SLDPRT

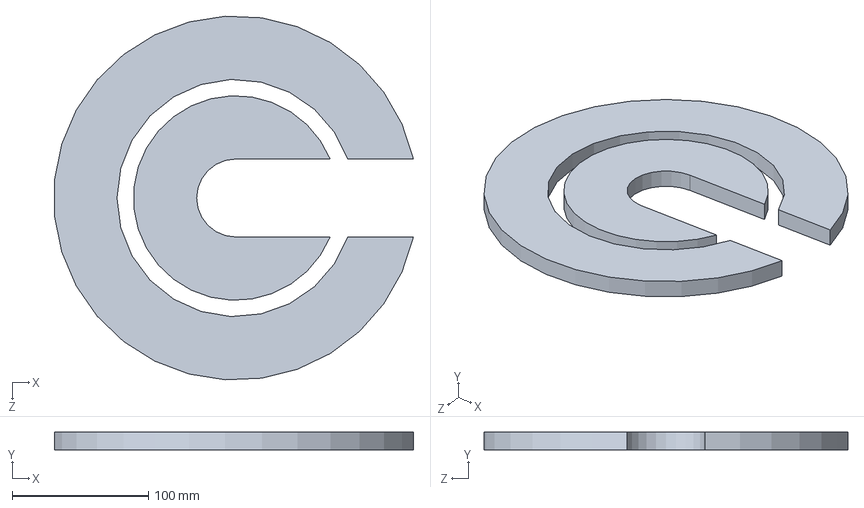
[picture p51: CAD file, 2017-06-17]
InitialQuoted/Drawings/ETA_CAD_Model/Machined/Bi_3_m.SLDPRT
263.2 x 12.9 x 266.6 mm
