SlaybaughLab/NIF_TNF_ETA/InitialQuoted/Drawings/ETA_CAD_Model/Solid/Bi_1.SLDPRT

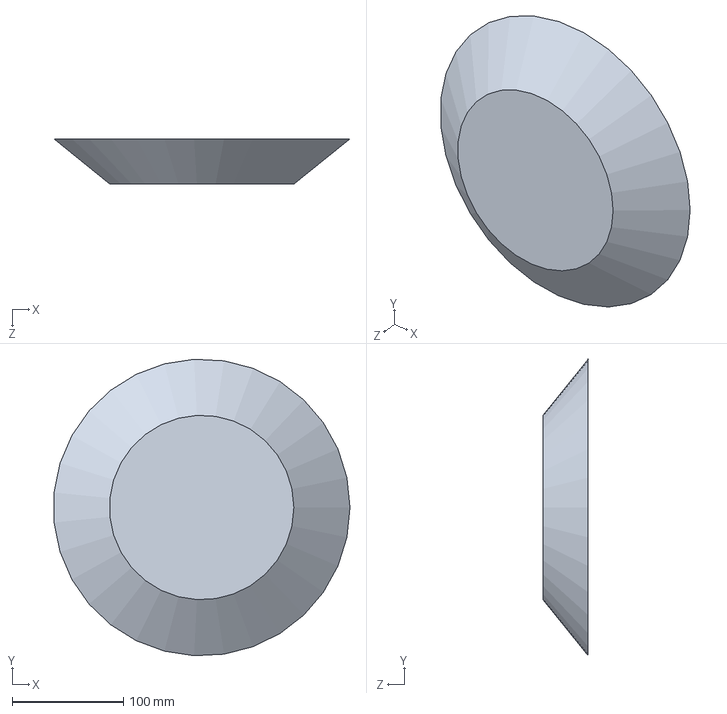
[picture p52: CAD file, 2017-06-17]
InitialQuoted/Drawings/ETA_CAD_Model/Solid/Bi_1.SLDPRT
266.3 x 266.7 x 40.7 mm
