SlaybaughLab/NIF_TNF_ETA/AsConstructed/CAD_Models/Solid Parts/Bi_4.SLDPRT

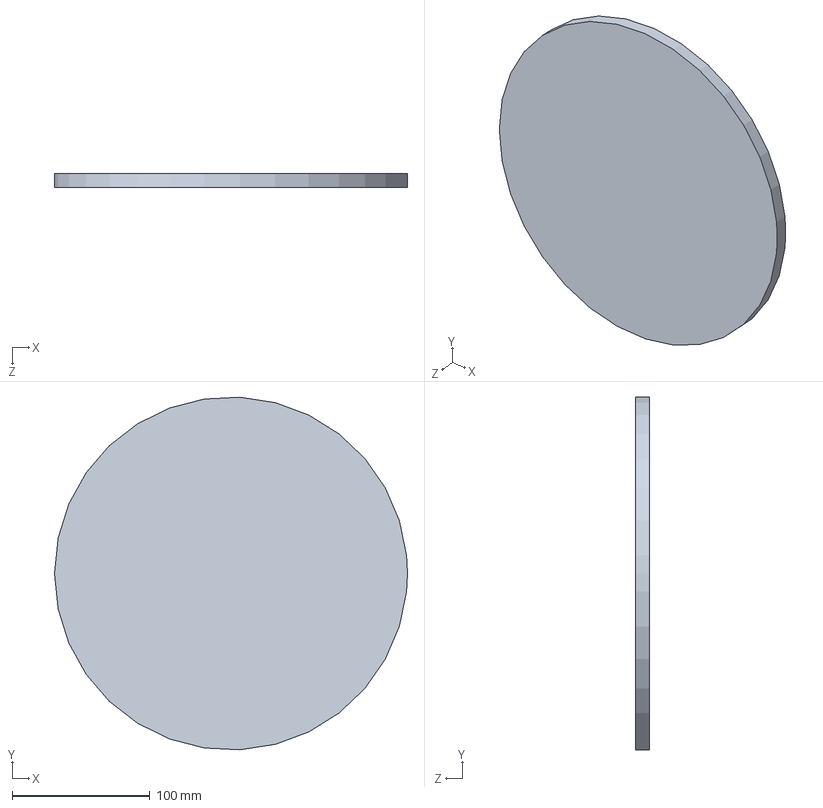
[picture p53: CAD file, 2017-06-17]
AsConstructed/CAD_Models/Solid Parts/Bi_4.SLDPRT
256.0 x 255.7 x 10.0 mm
