SlaybaughLab/NIF_TNF_ETA/InitialQuoted/Drawings/ETA_CAD_Model/Machined/Bi_2_m.SLDPRT

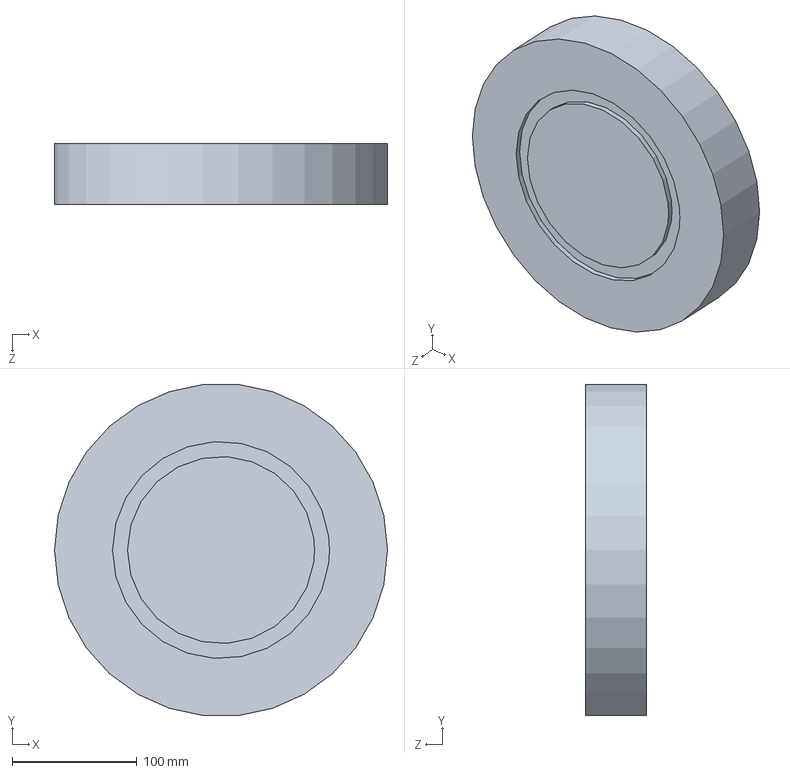
[picture p54: CAD file, 2017-06-17]
InitialQuoted/Drawings/ETA_CAD_Model/Machined/Bi_2_m.SLDPRT
267.0 x 265.5 x 49.0 mm
