SlaybaughLab/NIF_TNF_ETA/InitialQuoted/Drawings/ETA_CAD_Model/Solid/Si_2.SLDPRT

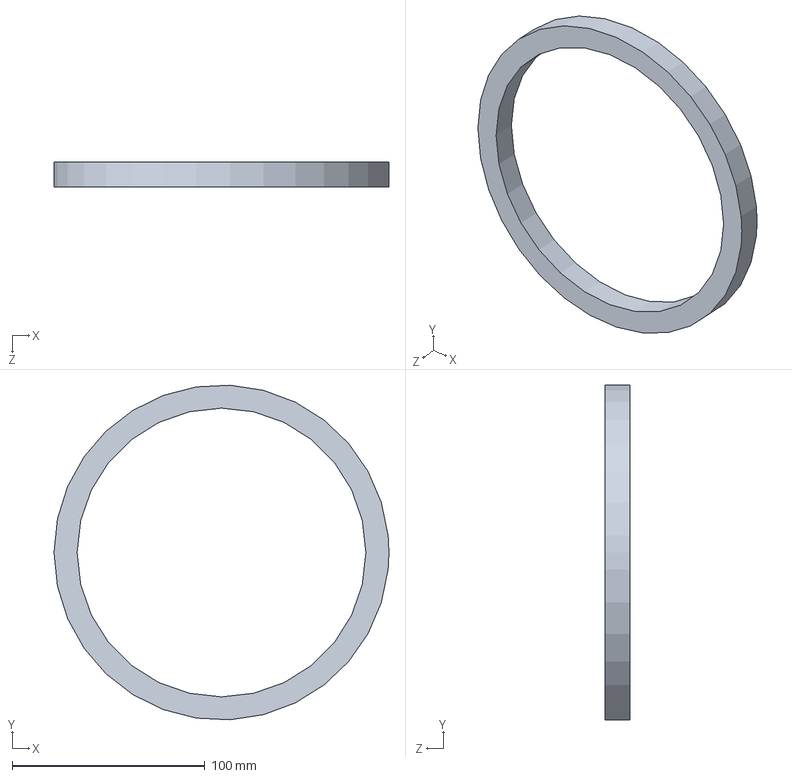
[picture p55: CAD file, 2017-06-17]
InitialQuoted/Drawings/ETA_CAD_Model/Solid/Si_2.SLDPRT
174.0 x 173.8 x 12.9 mm
