SlaybaughLab/NIF_TNF_ETA/AsConstructed/CAD_Models/Machined Parts/Bi_3a_m.SLDPRT

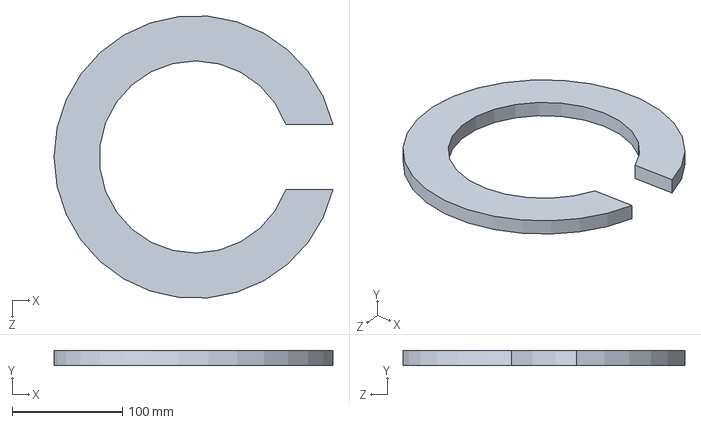
[picture p56: CAD file, 2017-06-17]
AsConstructed/CAD_Models/Machined Parts/Bi_3a_m.SLDPRT
252.5 x 13.9 x 254.9 mm
