SlaybaughLab/NIF_TNF_ETA/AsConstructed/CAD_Models/Solid Parts/Si_3.SLDPRT

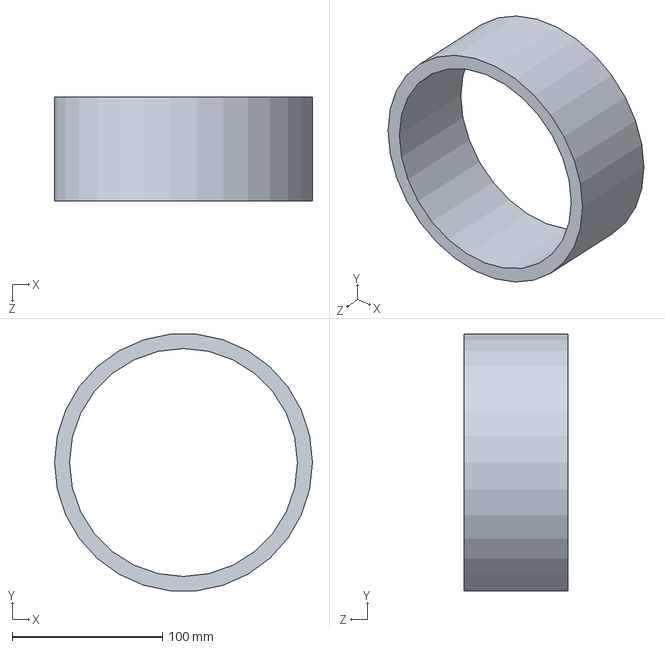
[picture p57: CAD file, 2017-06-17]
AsConstructed/CAD_Models/Solid Parts/Si_3.SLDPRT
172.0 x 171.1 x 69.5 mm
