SlaybaughLab/NIF_TNF_ETA/AsConstructed/CAD_Models/Machined Parts/Si_2_m.SLDPRT

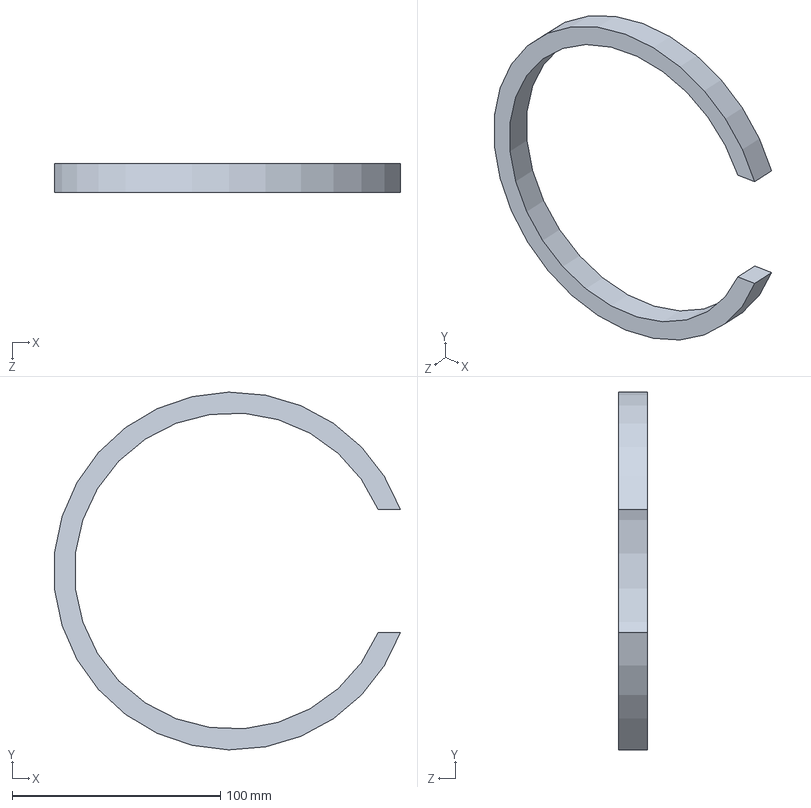
[picture p58: CAD file, 2017-06-17]
AsConstructed/CAD_Models/Machined Parts/Si_2_m.SLDPRT
166.3 x 172.0 x 13.9 mm
