SlaybaughLab/NIF_TNF_ETA/AsConstructed/CAD_Models/Solid Parts/Ba.SLDPRT

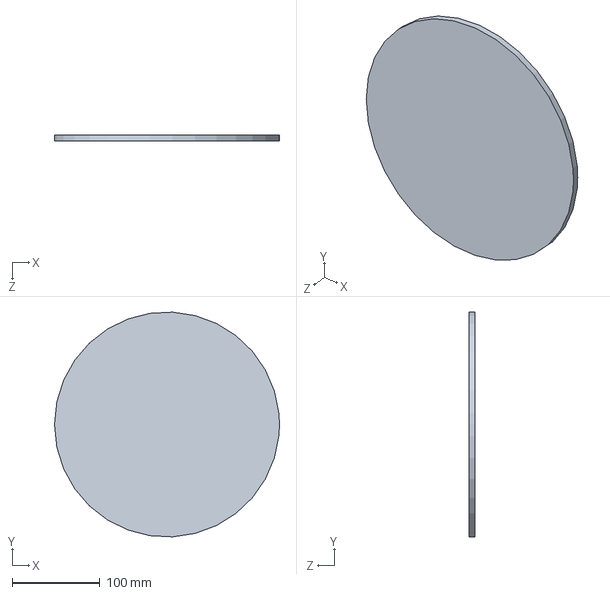
[picture p59: CAD file, 2017-06-17]
AsConstructed/CAD_Models/Solid Parts/Ba.SLDPRT
256.0 x 255.7 x 6.80 mm
