SlaybaughLab/NIF_TNF_ETA/InitialQuoted/Drawings/ETA_CAD_Model/Machined/Case_1.SLDPRT

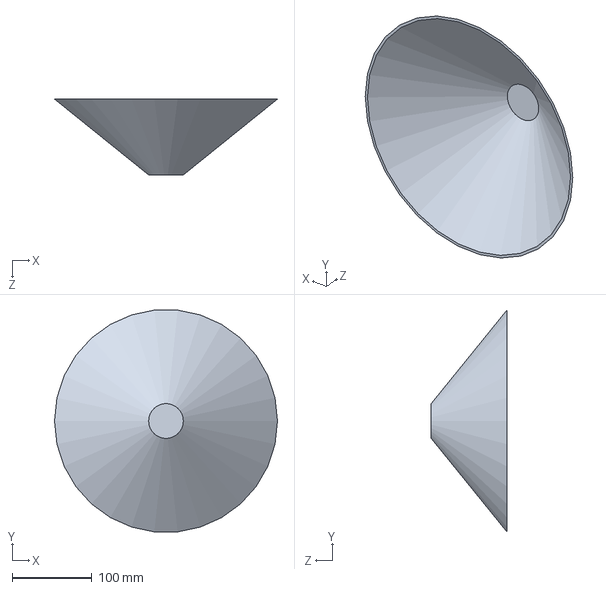
[picture p60: CAD file, 2017-06-17]
InitialQuoted/Drawings/ETA_CAD_Model/Machined/Case_1.SLDPRT
280.0 x 278.5 x 95.2 mm
