SlaybaughLab/NIF_TNF_ETA/InitialQuoted/Drawings/ETA_CAD_Model/Solid/Si_3.SLDPRT

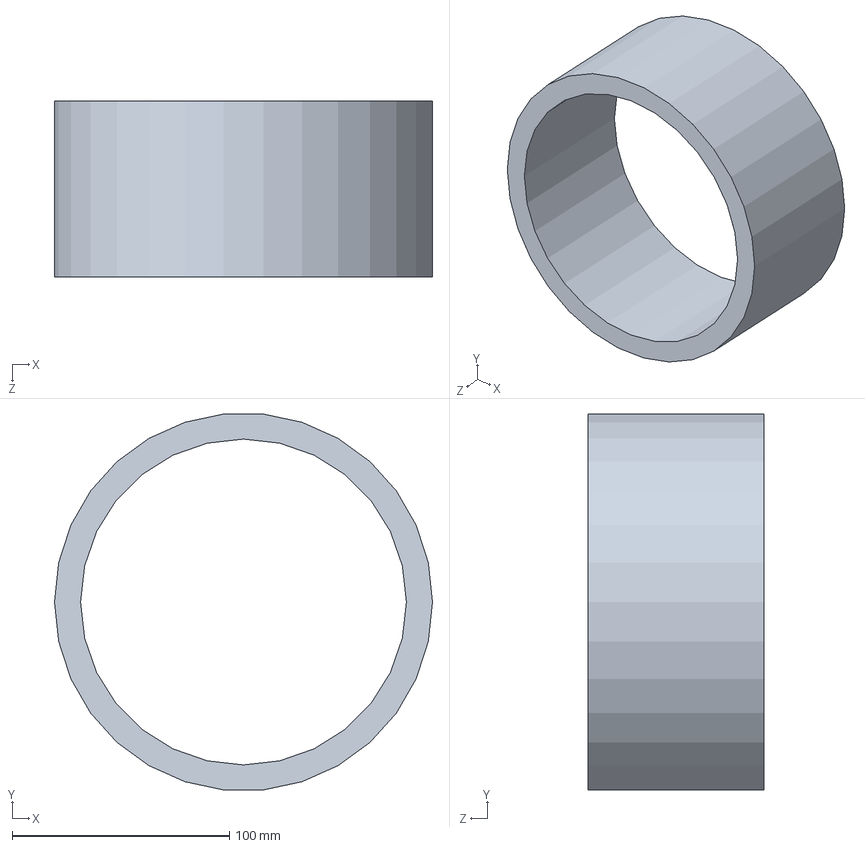
[picture p61: CAD file, 2017-06-17]
InitialQuoted/Drawings/ETA_CAD_Model/Solid/Si_3.SLDPRT
174.0 x 173.0 x 81.1 mm
