SlaybaughLab/NIF_TNF_ETA/AsConstructed/CAD_Models/Machined Parts/Ba_a_m.SLDPRT

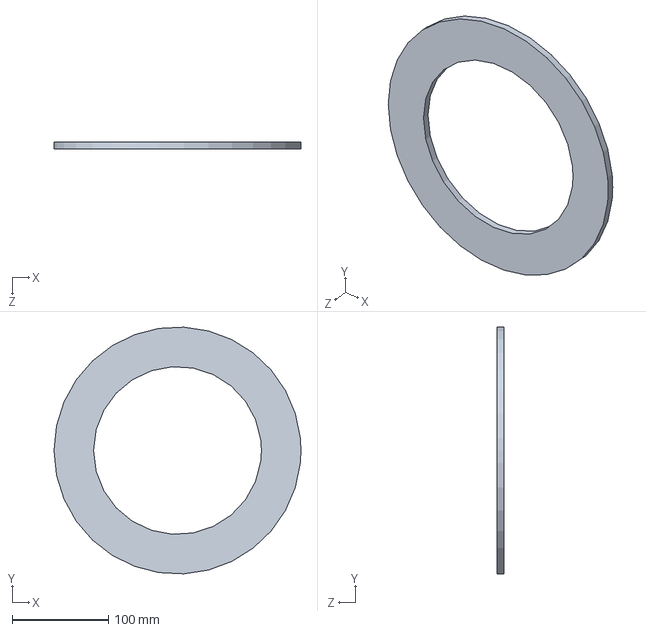
[picture p62: CAD file, 2017-06-17]
AsConstructed/CAD_Models/Machined Parts/Ba_a_m.SLDPRT
256.0 x 255.7 x 6.80 mm
