SlaybaughLab/NIF_TNF_ETA/AsConstructed/CAD_Models/Solid Parts/W.SLDPRT

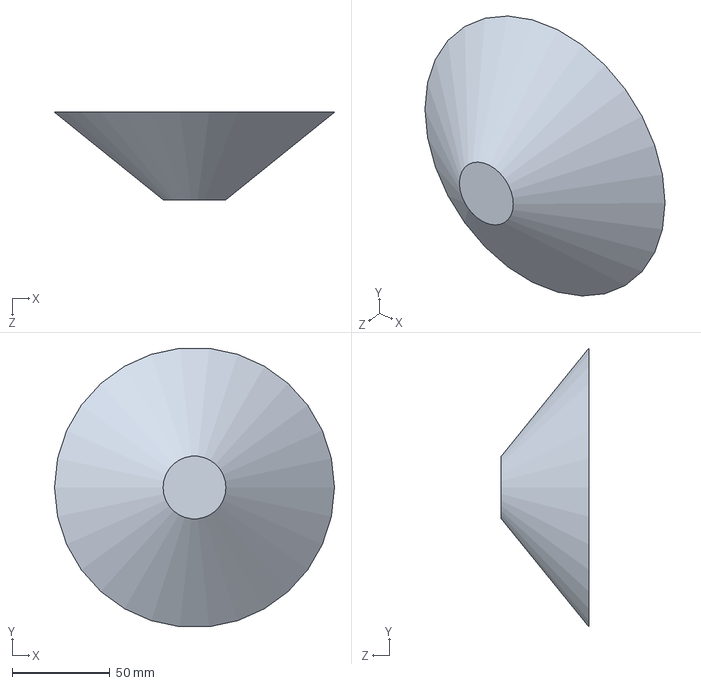
[picture p63: CAD file, 2017-06-17]
AsConstructed/CAD_Models/Solid Parts/W.SLDPRT
143.3 x 142.6 x 44.8 mm
