SlaybaughLab/NIF_TNF_ETA/InitialQuoted/Drawings/ETA_CAD_Model/Machined/Ba_m.SLDPRT

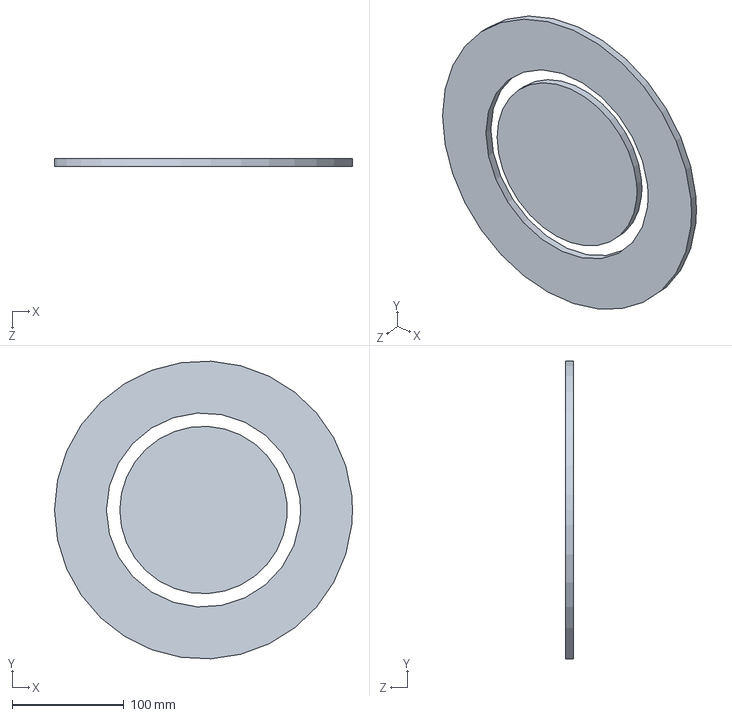
[picture p64: CAD file, 2017-06-17]
InitialQuoted/Drawings/ETA_CAD_Model/Machined/Ba_m.SLDPRT
267.0 x 266.7 x 6.80 mm
