SlaybaughLab/NIF_TNF_ETA/InitialQuoted/Drawings/ETA_CAD_Model/Solid/Bi_4.SLDPRT

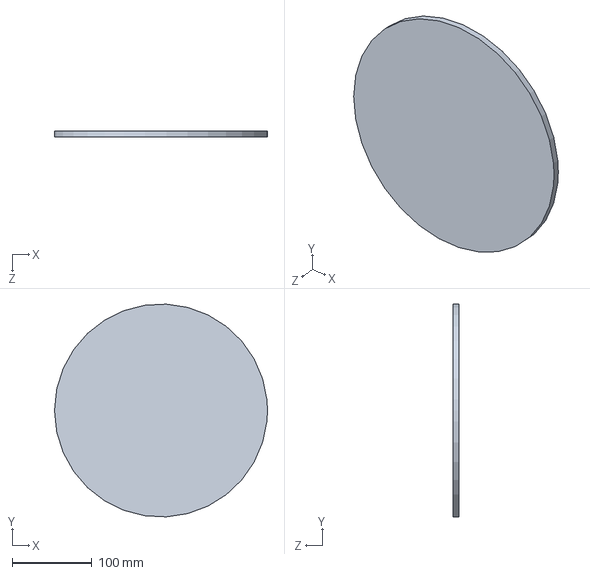
[picture p65: CAD file, 2017-06-17]
InitialQuoted/Drawings/ETA_CAD_Model/Solid/Bi_4.SLDPRT
267.0 x 266.7 x 7.40 mm
