SlaybaughLab/NIF_TNF_ETA/AsConstructed/CAD_Models/Machined Parts/Case_2.SLDPRT

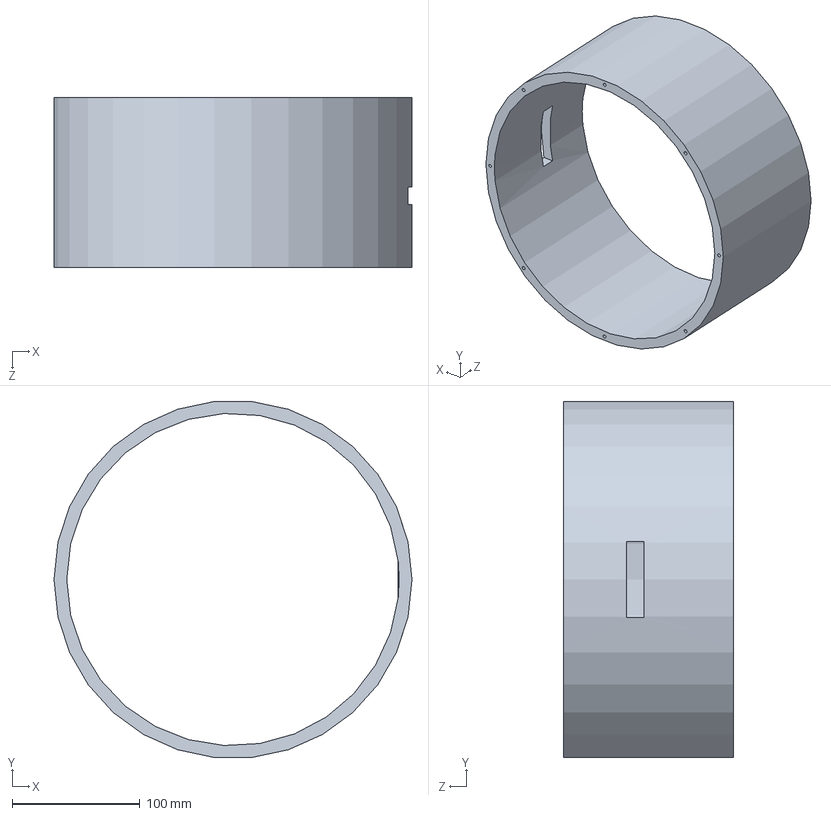
[picture p66: CAD file, 2017-06-17]
AsConstructed/CAD_Models/Machined Parts/Case_2.SLDPRT
280.0 x 278.5 x 132.6 mm
