SlaybaughLab/NIF_TNF_ETA/AsConstructed/CAD_Models/Solid Parts/Bi_1.SLDPRT

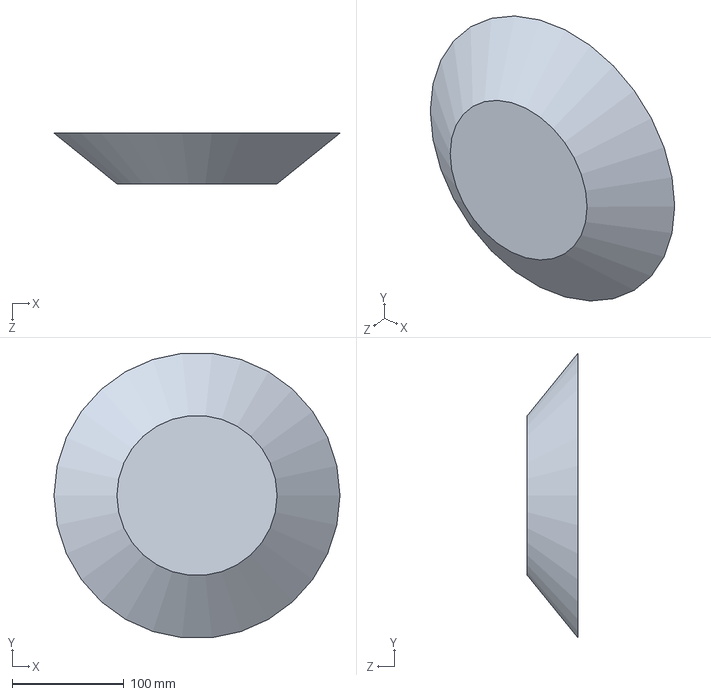
[picture p67: CAD file, 2017-06-17]
AsConstructed/CAD_Models/Solid Parts/Bi_1.SLDPRT
256.0 x 254.6 x 45.4 mm
