SlaybaughLab/NIF_TNF_ETA/InitialQuoted/Drawings/ETA_CAD_Model/Machined/Bi_4_m.SLDPRT

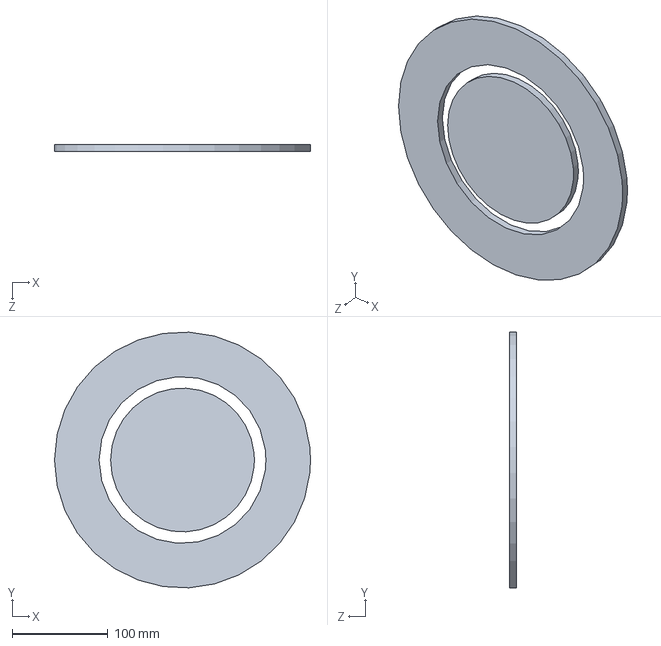
[picture p68: CAD file, 2017-06-17]
InitialQuoted/Drawings/ETA_CAD_Model/Machined/Bi_4_m.SLDPRT
267.0 x 266.7 x 7.40 mm
