SlaybaughLab/NIF_TNF_ETA/InitialQuoted/Drawings/ETA_CAD_Model/Solid/Bi_2.SLDPRT

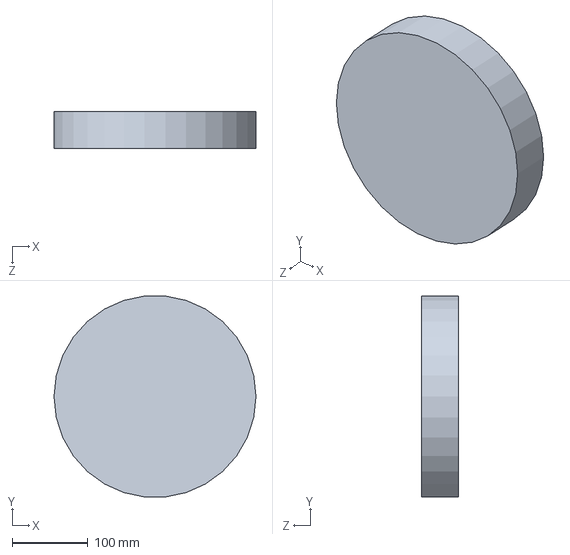
[picture p69: CAD file, 2017-06-17]
InitialQuoted/Drawings/ETA_CAD_Model/Solid/Bi_2.SLDPRT
267.0 x 265.5 x 49.0 mm
