SlaybaughLab/NIF_TNF_ETA/AsConstructed/CAD_Models/Machined Parts/Bi_3b_m.SLDPRT

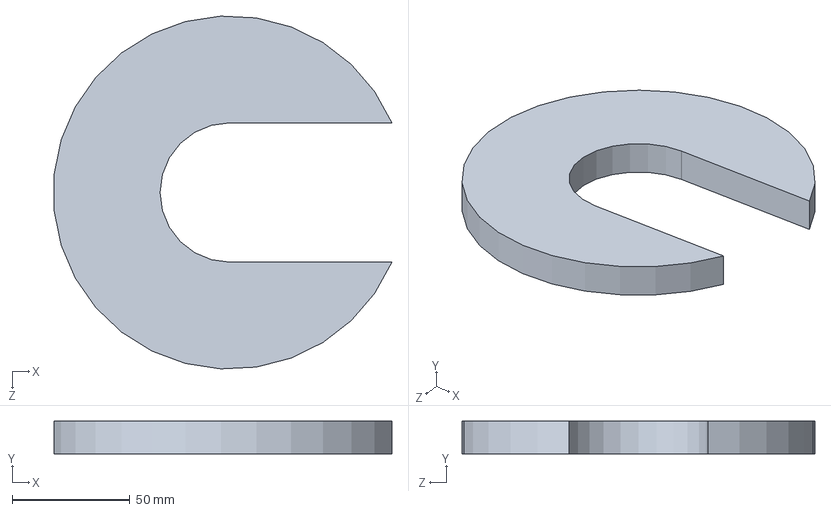
[picture p70: CAD file, 2017-06-17]
AsConstructed/CAD_Models/Machined Parts/Bi_3b_m.SLDPRT
143.5 x 13.9 x 149.8 mm
