SlaybaughLab/NIF_TNF_ETA/AsConstructed/CAD_Models/Solid Parts/Bi_3a.SLDPRT

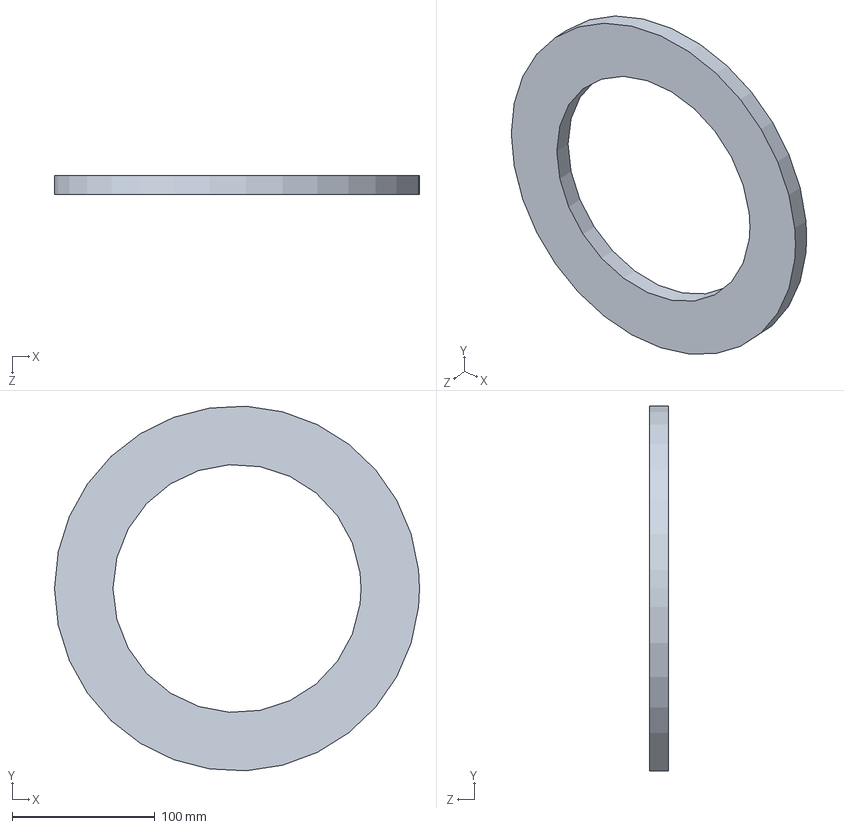
[picture p71: CAD file, 2017-06-17]
AsConstructed/CAD_Models/Solid Parts/Bi_3a.SLDPRT
256.0 x 255.7 x 13.0 mm
