SlaybaughLab/NIF_TNF_ETA/InitialQuoted/Drawings/ETA_CAD_Model/Machined/Pr_m.SLDPRT

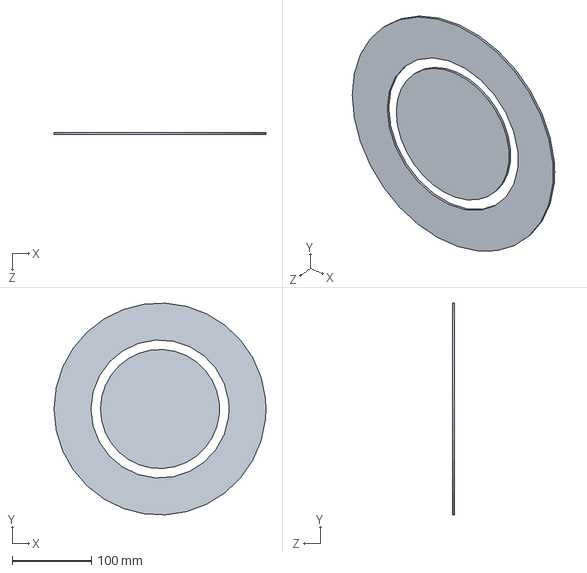
[picture p72: CAD file, 2017-06-17]
InitialQuoted/Drawings/ETA_CAD_Model/Machined/Pr_m.SLDPRT
267.0 x 266.7 x 2.60 mm
