SlaybaughLab/NIF_TNF_ETA/InitialQuoted/Drawings/ETA_CAD_Model/Solid/Bi_3.SLDPRT

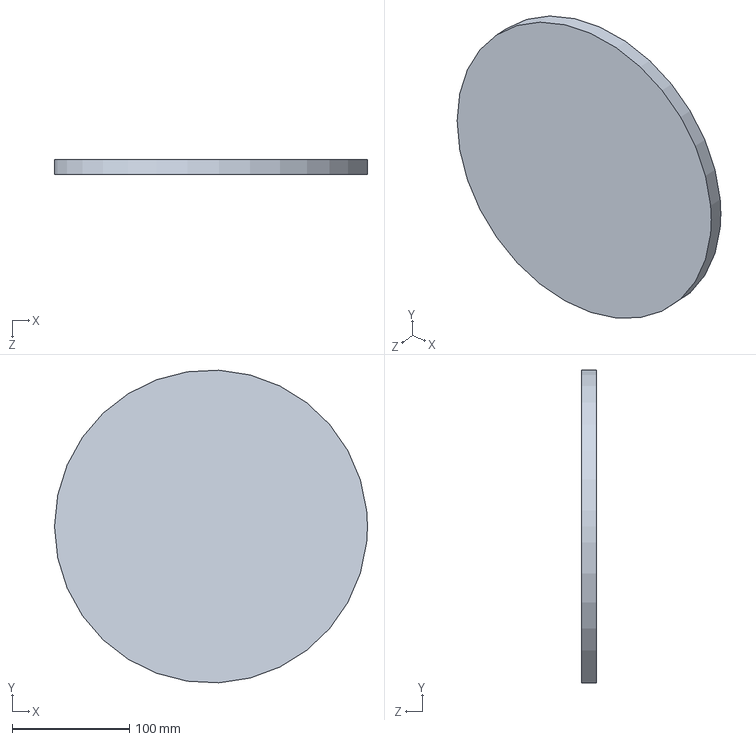
[picture p73: CAD file, 2017-06-17]
InitialQuoted/Drawings/ETA_CAD_Model/Solid/Bi_3.SLDPRT
267.0 x 266.7 x 12.9 mm
