SlaybaughLab/NIF_TNF_ETA/AsConstructed/CAD_Models/Machined Parts/Ba_b_m.SLDPRT

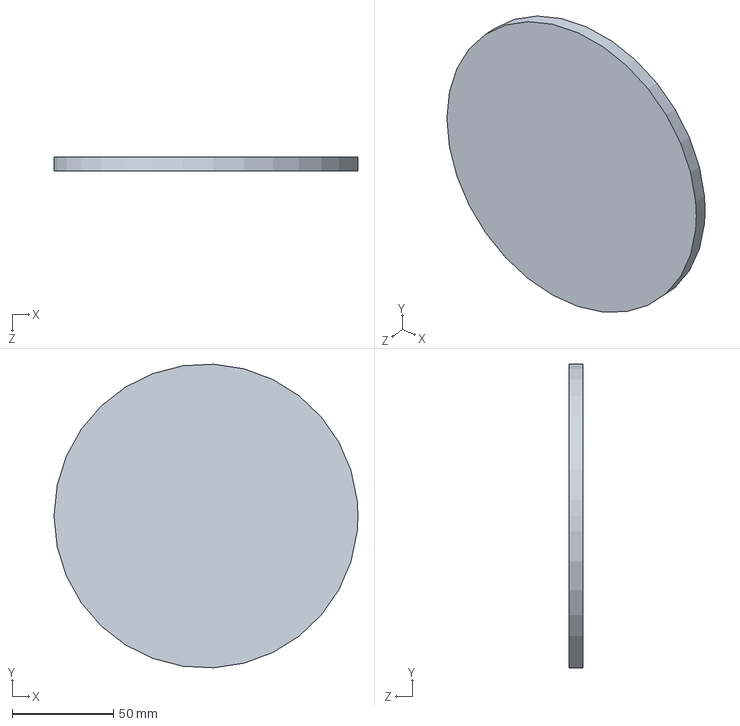
[picture p74: CAD file, 2017-06-17]
AsConstructed/CAD_Models/Machined Parts/Ba_b_m.SLDPRT
150.0 x 149.8 x 6.80 mm
