SlaybaughLab/NIF_TNF_ETA/InitialQuoted/Drawings/ETA_CAD_Model/Solid/Ba.SLDPRT

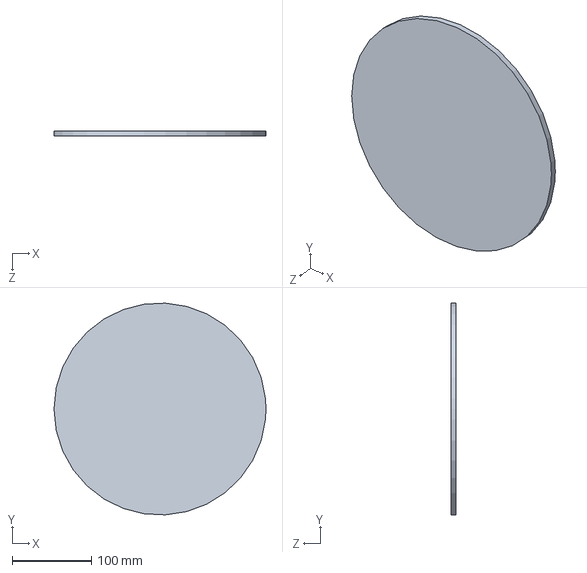
[picture p75: CAD file, 2017-06-17]
InitialQuoted/Drawings/ETA_CAD_Model/Solid/Ba.SLDPRT
267.0 x 266.7 x 6.80 mm
