SlaybaughLab/NIF_TNF_ETA/AsConstructed/CAD_Models/Machined Parts/Case_1.SLDPRT

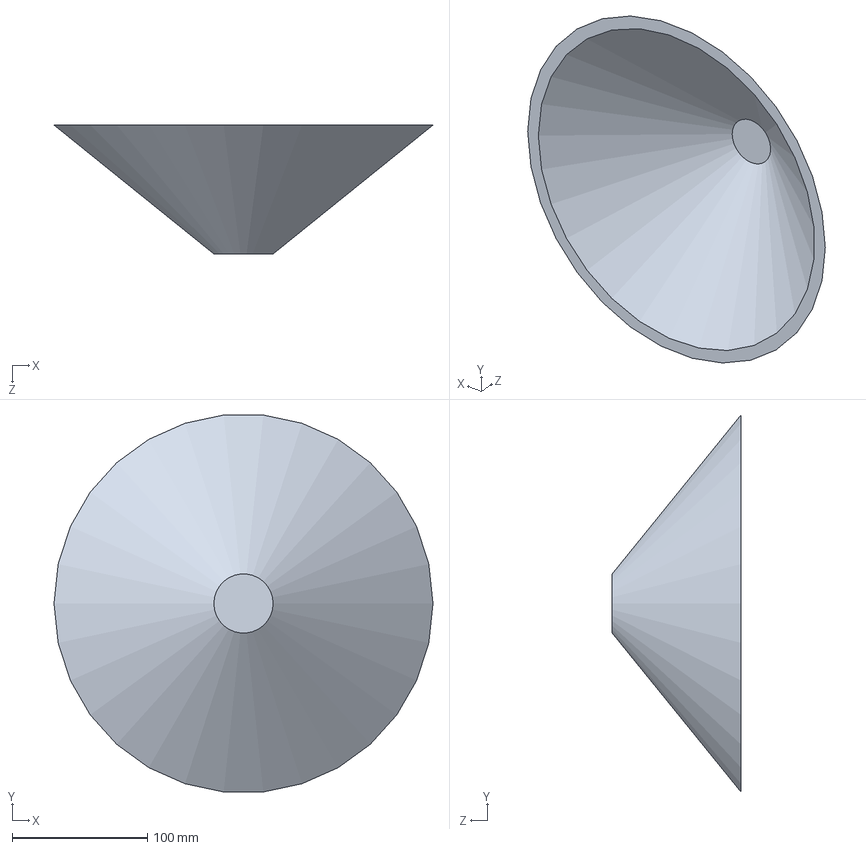
[picture p76: CAD file, 2017-06-17]
AsConstructed/CAD_Models/Machined Parts/Case_1.SLDPRT
280.0 x 278.5 x 95.2 mm
