SlaybaughLab/NIF_TNF_ETA/InitialQuoted/Drawings/ETA_CAD_Model/Machined/Case_2.SLDPRT

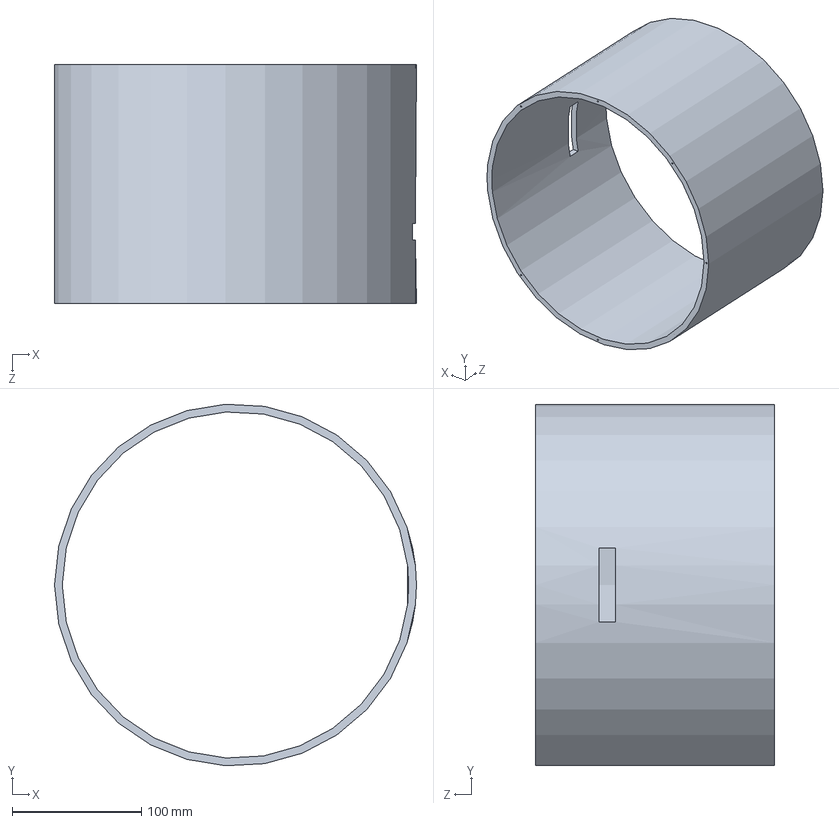
[picture p77: CAD file, 2017-06-17]
InitialQuoted/Drawings/ETA_CAD_Model/Machined/Case_2.SLDPRT
280.0 x 279.6 x 184.7 mm
