SlaybaughLab/NIF_TNF_ETA/InitialQuoted/Drawings/ETA_CAD_Model/Solid/B.SLDPRT

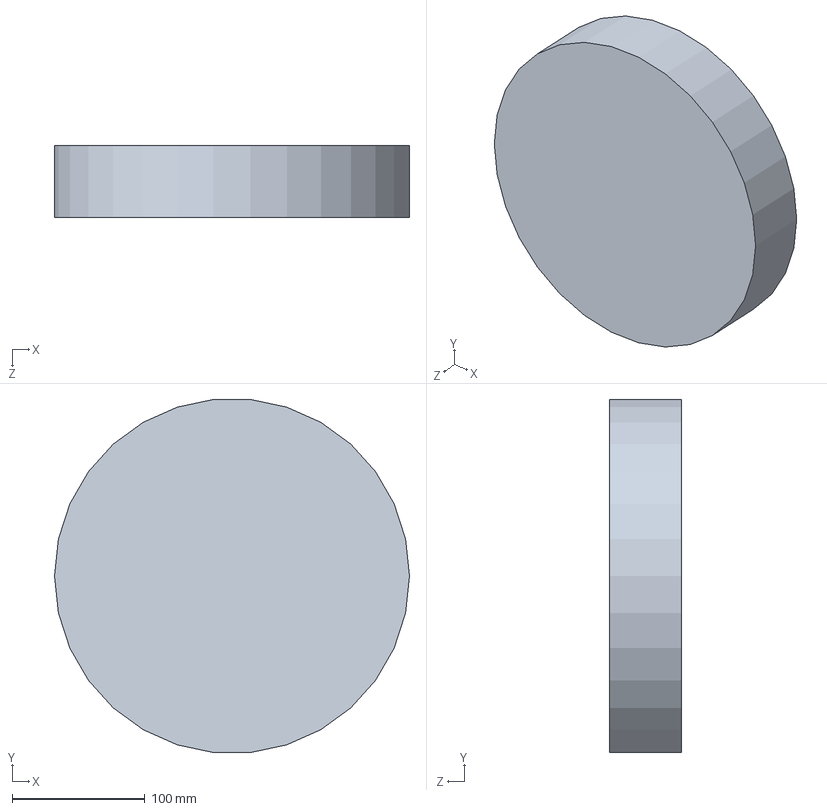
[picture p78: CAD file, 2017-06-17]
InitialQuoted/Drawings/ETA_CAD_Model/Solid/B.SLDPRT
267.0 x 265.5 x 53.8 mm
