SlaybaughLab/NIF_TNF_ETA/InitialQuoted/Drawings/ETA_CAD_Model/Machined/Cr_m.SLDPRT

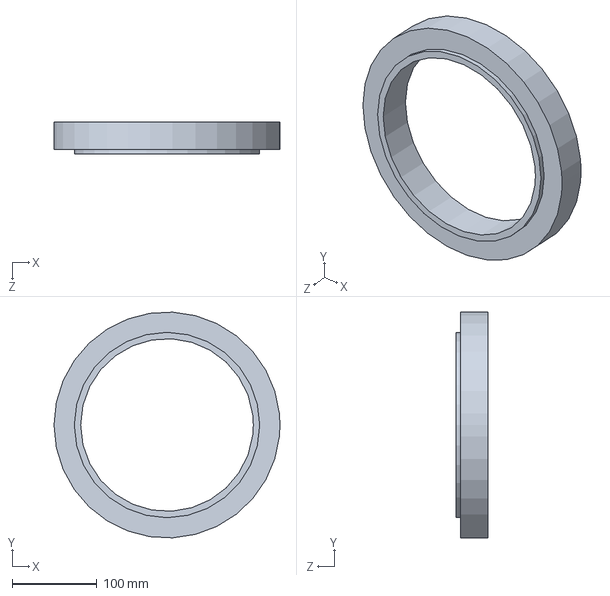
[picture p79: CAD file, 2017-06-17]
InitialQuoted/Drawings/ETA_CAD_Model/Machined/Cr_m.SLDPRT
267.0 x 266.7 x 38.1 mm
