SlaybaughLab/NIF_TNF_ETA/AsConstructed/CAD_Models/Machined Parts/Bi_4a_m.SLDPRT

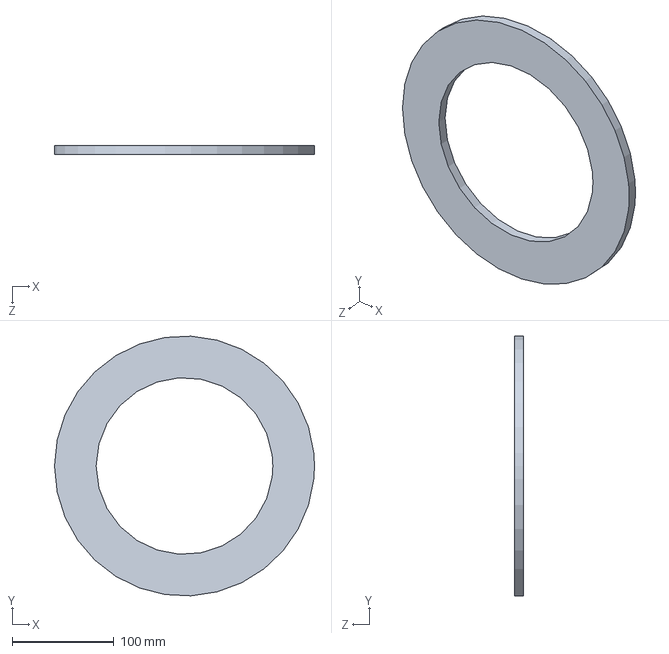
[picture p80: CAD file, 2017-06-17]
AsConstructed/CAD_Models/Machined Parts/Bi_4a_m.SLDPRT
256.0 x 255.7 x 9.10 mm
