SlaybaughLab/NIF_TNF_ETA/(list of files, cad)

Other CAD files:
AsConstructed/CAD_Models/Machined Parts/Case_3.SLDPRT
InitialQuoted/Drawings/ETA_CAD_Model/Machined/Si_2_m.SLDPRT
InitialQuoted/Drawings/ETA_CAD_Model/Solid/Cr.SLDPRT
AsConstructed/CAD_Models/Assembly Drawings/Drawer.SLDDRW
AsConstructed/CAD_Models/Assembly Drawings/ETA.SLDDRW
AsConstructed/CAD_Models/Assembly Drawings/ETA_Expanded.SLDDRW
AsConstructed/CAD_Models/Assembly Drawings/ETA_inside.SLDDRW
AsConstructed/CAD_Models/Assembly Drawings/ETA_inside_W.SLDDRW
AsConstructed/CAD_Models/Machined Parts/Drawings/B4C_a_m.SLDDRW
AsConstructed/CAD_Models/Machined Parts/Drawings/B4C_b_m.SLDDRW
AsConstructed/CAD_Models/Machined Parts/Drawings/B4C_m.SLDDRW
AsConstructed/CAD_Models/Machined Parts/Drawings/Ba_a_m.SLDDRW
AsConstructed/CAD_Models/Machined Parts/Drawings/Ba_b_m.SLDDRW
AsConstructed/CAD_Models/Machined Parts/Drawings/Ba_m.SLDDRW
AsConstructed/CAD_Models/Machined Parts/Drawings/Bi_3a_m.SLDDRW
AsConstructed/CAD_Models/Machined Parts/Drawings/Bi_3b_m.SLDDRW
AsConstructed/CAD_Models/Machined Parts/Drawings/Bi_4a_m.SLDDRW
AsConstructed/CAD_Models/Machined Parts/Drawings/Bi_4b_m.SLDDRW
AsConstructed/CAD_Models/Machined Parts/Drawings/Case_1.SLDDRW
AsConstructed/CAD_Models/Machined Parts/Drawings/Case_2.SLDDRW
AsConstructed/CAD_Models/Machined Parts/Drawings/Case_3.SLDDRW
AsConstructed/CAD_Models/Machined Parts/Drawings/Drawer.SLDDRW
AsConstructed/CAD_Models/Machined Parts/Drawings/Drawer_Cover.SLDDRW
AsConstructed/CAD_Models/Machined Parts/Drawings/Drawer_Handle.SLDDRW
AsConstructed/CAD_Models/Machined Parts/Drawings/Si_2_m.SLDDRW
AsConstructed/CAD_Models/Solid Parts/Drawings/B4C.SLDDRW
AsConstructed/CAD_Models/Solid Parts/Drawings/Ba.SLDDRW
AsConstructed/CAD_Models/Solid Parts/Drawings/Bi_1.SLDDRW
AsConstructed/CAD_Models/Solid Parts/Drawings/Bi_2.SLDDRW
AsConstructed/CAD_Models/Solid Parts/Drawings/Bi_3.SLDDRW
AsConstructed/CAD_Models/Solid Parts/Drawings/Bi_3a.SLDDRW
AsConstructed/CAD_Models/Solid Parts/Drawings/Bi_3b.SLDDRW
AsConstructed/CAD_Models/Solid Parts/Drawings/Bi_4.SLDDRW
AsConstructed/CAD_Models/Solid Parts/Drawings/Pb.SLDDRW
AsConstructed/CAD_Models/Solid Parts/Drawings/Si_2.SLDDRW
AsConstructed/CAD_Models/Solid Parts/Drawings/Si_3.SLDDRW
AsConstructed/CAD_Models/Solid Parts/Drawings/W.SLDDRW
InitialQuoted/Drawings/ETA_CAD_Model/Assembly Drawings/Drawer.SLDDRW
InitialQuoted/Drawings/ETA_CAD_Model/Assembly Drawings/ETA.SLDDRW
InitialQuoted/Drawings/ETA_CAD_Model/Assembly Drawings/ETA_inside.SLDDRW
InitialQuoted/Drawings/ETA_CAD_Model/Machined/Drawings/B_m.SLDDRW
InitialQuoted/Drawings/ETA_CAD_Model/Machined/Drawings/Ba_m.SLDDRW
InitialQuoted/Drawings/ETA_CAD_Model/Machined/Drawings/Bi_2_m.SLDDRW
InitialQuoted/Drawings/ETA_CAD_Model/Machined/Drawings/Bi_3_m.SLDDRW
InitialQuoted/Drawings/ETA_CAD_Model/Machined/Drawings/Bi_4_m.SLDDRW
InitialQuoted/Drawings/ETA_CAD_Model/Machined/Drawings/Case_1.SLDDRW
InitialQuoted/Drawings/ETA_CAD_Model/Machined/Drawings/Case_2.SLDDRW
InitialQuoted/Drawings/ETA_CAD_Model/Machined/Drawings/Case_3.SLDDRW
InitialQuoted/Drawings/ETA_CAD_Model/Machined/Drawings/Cr_m.SLDDRW
InitialQuoted/Drawings/ETA_CAD_Model/Machined/Drawings/Drawer.SLDDRW
InitialQuoted/Drawings/ETA_CAD_Model/Machined/Drawings/Drawer_Cover.SLDDRW
InitialQuoted/Drawings/ETA_CAD_Model/Machined/Drawings/Drawer_Handle.SLDDRW
InitialQuoted/Drawings/ETA_CAD_Model/Machined/Drawings/Pr_m.SLDDRW
InitialQuoted/Drawings/ETA_CAD_Model/Machined/Drawings/Si_2_m.SLDDRW
InitialQuoted/Drawings/ETA_CAD_Model/Solid/Drawings/Al.SLDDRW
InitialQuoted/Drawings/ETA_CAD_Model/Solid/Drawings/B.SLDDRW
InitialQuoted/Drawings/ETA_CAD_Model/Solid/Drawings/Ba.SLDDRW
InitialQuoted/Drawings/ETA_CAD_Model/Solid/Drawings/Bi_1.SLDDRW
InitialQuoted/Drawings/ETA_CAD_Model/Solid/Drawings/Bi_2.SLDDRW
InitialQuoted/Drawings/ETA_CAD_Model/Solid/Drawings/Bi_3.SLDDRW
InitialQuoted/Drawings/ETA_CAD_Model/Solid/Drawings/Bi_4.SLDDRW
InitialQuoted/Drawings/ETA_CAD_Model/Solid/Drawings/Cr.SLDDRW
InitialQuoted/Drawings/ETA_CAD_Model/Solid/Drawings/Pb.SLDDRW
InitialQuoted/Drawings/ETA_CAD_Model/Solid/Drawings/Pr.SLDDRW
InitialQuoted/Drawings/ETA_CAD_Model/Solid/Drawings/Si_1.SLDDRW
InitialQuoted/Drawings/ETA_CAD_Model/Solid/Drawings/Si_2.SLDDRW
InitialQuoted/Drawings/ETA_CAD_Model/Solid/Drawings/Si_3.SLDDRW
InitialQuoted/Drawings/ETA_CAD_Model/Solid/Drawings/Ta.SLDDRW
InitialQuoted/Drawings/ETA_CAD_Model/Solid/Pb.SLDDRW
