SlaybaughLab/NIF_TNF_ETA/AsConstructed/Purchasing/4Nov16_161104KK05 University of California, Berkeley Assembly.pdf

The World’s Manufacturer of Engineered & Advanced Materials
MERELEX CORPORATION • 10884 WEYBURN AVE. LOS ANGELES, CA 90024
TEL. 310-208-0551 • FAX 310-208-0351 • E-MAIL: orders@americanelements.com

Customer Service Representative
Keri Keinath
Telephone: 310-208-3003
Fax: 310-564-1892
Email: keri.keinath@americanelements.com

James Bevins
University of California, Berkeley 4173 Etcheverry Hall

8657558090

DATE: | November 4, 2016
QUOTE VALIDITY: | October 31, 2016
RE: | Aluminum Metal Plate
SHIPPING TERMS: | FOB Los Angeles, CA

161104KK05

Tungsten Metal Plate | Per customer drawing W LAYER | 1 piece | $2,914.12/pc

Bismuth Metal Plate

Bismuth Metal Plate

Per customer drawing BI_1
LAYER
*May be pits and edge breakage of surface

Per customer drawing BI_2
LAYER
*May be pits and edge breakage of surface

1 piece

1 piece

$8,313.82/pc

$8,099.55/pc*

QUOTATION:

### PHONE:

TO:

MATERIAL | DESCRIPTION | QTY | UNIT PRICE

PN: W-M-03M-PL

PN: BI-M-03M-PL

PN: BI-M-03M-PL

Purity: 99.9% (metals basis)

Purity: 99.9% (metals basis)

Purity: 99.9% (metals basis)

Shipping (Estimated)

United States

Berkeley, CA 94720

EMAIL: | jbevins1@berkeley.edu

TBD

PAYMENT TERMS: | CIA

*Final assembly fitting is not guaranteed. Parts are machined according to customer drawings.

This quotation is subject to American Elements' General Terms & Conditions. American Elements' general terms and conditions can be found on the back of this document, or if it is being transmitted electronically, a complete copy can always be reviewed and printed at www.americanelements.com/generalterms.pdf. © 2001-2014. American Elements. All rights reserved.
AECFORM 32:87 REV. APP. 9/15/04

The World’s Manufacturer of Engineered & Advanced Materials
MERELEX CORPORATION • 10884 WEYBURN AVE. LOS ANGELES, CA 90024
TEL. 310-208-0551 • FAX 310-208-0351 • E-MAIL: orders@americanelements.com

Customer Service Representative
Keri Keinath
Telephone: 310-208-3003
Fax: 310-564-1892
Email: keri.keinath@americanelements.com

James Bevins
University of California, Berkeley 4173 Etcheverry Hall

8657558090

DATE: | November 4, 2016
QUOTE VALIDITY: | October 31, 2016
RE: | Aluminum Metal Plate
SHIPPING TERMS: | FOB Los Angeles, CA

161104KK05

Bismuth Metal Plate | Per customer drawing BI_3A
LAYER
*May be pits and edge breakage of surface
1 piece | $2,995.55/pc

Bismuth Metal Plate

Silicon (Elemental) Plate

Per customer drawing BI_3B LAYER
*May be pits and edge breakage of surface

Per customer drawing SI_2
LAYER

1 piece

1 piece

$1,885.61/pc

$1,349.92/pc*

QUOTATION:

### PHONE:

TO:

MATERIAL | DESCRIPTION | QTY | UNIT PRICE

PN: BI-M-03M-PL

PN: BI-M-03M-PL

PN: SI-E-03M-PL

Purity: 99.9% (metals basis)

Purity: 99.9% (metals basis)

Purity: 99.9% (metals basis)

Shipping (Estimated)

United States

Berkeley, CA 94720

EMAIL: | jbevins1@berkeley.edu

TBD

PAYMENT TERMS: | CIA

*Final assembly fitting is not guaranteed. Parts are machined according to customer drawings.

The World’s Manufacturer of Engineered & Advanced Materials
MERELEX CORPORATION • 10884 WEYBURN AVE. LOS ANGELES, CA 90024
TEL. 310-208-0551 • FAX 310-208-0351 • E-MAIL: orders@americanelements.com

Customer Service Representative
Keri Keinath
Telephone: 310-208-3003
Fax: 310-564-1892
Email: keri.keinath@americanelements.com

James Bevins
University of California, Berkeley 4173 Etcheverry Hall

8657558090

DATE: | November 4, 2016
QUOTE VALIDITY: | October 31, 2016
RE: | Aluminum Metal Plate
SHIPPING TERMS: | FOB Los Angeles, CA

161104KK05

Bismuth Metal Plate | Per customer drawing BI_4A
LAYER
*May be pits and edge breakage of surface
1 piece | $1,821.33/pc

Bismuth Metal Plate

Silicon (Elemental) Plate

Per customer drawing BI_4B LAYER
*May be pits and edge breakage of surface

Per customer drawing SI_3
LAYER

1 piece

1 piece

$1,885.61/pc

$1,885.61/pc

QUOTATION:

### PHONE:

TO:

MATERIAL | DESCRIPTION | QTY | UNIT PRICE

PN: BI-M-03M-PL

PN: BI-M-03M-PL

PN: SI-E-03M-PL

Purity: 99.9% (metals basis)

Purity: 99.9% (metals basis)

Purity: 99.9% (metals basis)

Shipping (Estimated)

United States

Berkeley, CA 94720

EMAIL: | jbevins1@berkeley.edu

TBD

PAYMENT TERMS: | CIA

*Final assembly fitting is not guaranteed. Parts are machined according to customer drawings.

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

James Bevins
University of California, Berkeley 4173 Etcheverry Hall

8657558090

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

161104KK05

Praseodymium Metal Plate | Per customer drawing BA_A
LAYER
1 piece | $3,814.07/pc

Praseodymium Metal Plate

Boron Carbide Plate

Per customer drawing BA_B
LAYER

Per customer drawing B4C_A LAYER

1 piece

1 piece

$1,842.75/pc

$7,713.85/pc

QUOTATION:

### PHONE:

TO:

MATERIAL | DESCRIPTION | QTY | UNIT PRICE

PN: PR-M-03M-PL

PN: PR-M-03M-PL

PN: BO-C-025M-PL

Purity: 99.9% (metals basis)

Purity: 99.9% (metals basis)

Purity: 99.5% (metals basis)

Shipping (Estimated)

United States

Berkeley, CA 94720

EMAIL: | jbevins1@berkeley.edu

TBD

PAYMENT TERMS: | CIA

*Final assembly fitting is not guaranteed. Parts are machined according to customer drawings.

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

James Bevins
University of California, Berkeley 4173 Etcheverry Hall

8657558090

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

161104KK05

Boron Carbide Plate | Per customer drawing B4C_B
LAYER
1 piece | $5,356.84/pc
Lead Metal Plate | Per customer drawing PB
DRAWER FILLER
1 piece | $1,674.33/pc

QUOTATION:

### PHONE:

TO:

MATERIAL | DESCRIPTION | QTY | UNIT PRICE

PN: BO-C-025M-PL

PN: PB-M-03M-PL

Purity: 99.5% (metals basis)

Purity: 99.9% (metals basis)

Shipping (Estimated)

United States

Berkeley, CA 94720

EMAIL: | jbevins1@berkeley.edu

TBD

PAYMENT TERMS: | CIA

*Final assembly fitting is not guaranteed. Parts are machined according to customer drawings.
