SlaybaughLab/NIF_TNF_ETA/AsConstructed/MCNP_Model_Ideal/ETA_Masses.xlsx

Sheet: Ideal
Material/Component | Density [g/cc] | Volume [cm3] | MCNP Mass [g] | Calc Mass [g]
Al 6061-T6 Case 1 | 2.7 | 457.93 | 1236.41 | 1236.41
Al 6061-T6 Case 2 | 2.7 | 1124.75 | 3036.83 | 3036.83
Al 6061-T6 Case 3 | 2.7 | 738.90 | 1995.04 | 1995.04
Al 6061-T6 TOAD | 2.7 |  |  | 0.00
Al 6061-T6 NAS | 2.7 |  |  | 0.00
Al 6061-T6 Drawer | 2.7 |  |  | 0.00
Pb | 11.34 | 53.14 | 602.55 | 602.61
Si_2 | 2.33 | 62.51 | 145.65 | 145.65
Si_3 | 2.33 | 353.71 | 824.15 | 824.15
W | 19.25 | 307.27 | 5915.04 | 5915.04
Bi_1 | 9.78 | 1459.29 | 14271.90 | 14271.86
Bi_2 | 9.78 | 2522.12 | 24666.30 | 24666.33
Bi_3a | 9.78 | 351.20 | 3434.74 | 3434.74
Bi_3b | 9.78 | 164.80 | 1611.74 | 1611.74
Bi_4a | 9.78 | 252.01 | 2464.66 | 2464.66
Bi_4b | 9.78 | 160.81 | 1582.50 | 1572.72
Pr_a | 6.77 | 188.31 | 1274.86 | 1274.86
Pr_b | 6.77 | 120.17 | 813.55 | 813.55
B4C_a | 2.52 | 1489.89 | 3754.52 | 3754.52
B4C_b | 2.52 | 950.72 | 2395.81 | 2395.81
 |  | Total Mass | 67.63 | kg

Sheet: As_Constructed
Material/Component | Density [g/cc] | Volume [cm3] | Measured Mass [g]
Al 6061-T6 Case 1 | 2.65 | 457.93 | 1213
Al 6061-T6 Case 2 | 2.66 | 1124.75 | 2993
Al 6061-T6 Case 3 | 2.65 | 738.90 | 1956
Al 6061-T6 TOAD | #DIV/0!
Al 6061-T6 NAS | #DIV/0!
Al 6061-T6 Drawer | 2.65 | 50.94 | 135
Pb | 11.18 | 53.14 | 594
Si_2 | 2.26 | 62.51 | 141
Si_3 | 2.29 | 353.71 | 809
W | 18.87 | 307.27 | 5797
Bi_1 | 10.48 | 1459.29 | 15297
Bi_2 | 9.80 | 2522.12 | 24716.776
Bi_3a | 10.10 | 351.20 | 3546 |  | 255.1758633 | -63.882 | -39.5829998 | 151.7108635
Bi_3b | 10.24 | 164.80 | 1687 | 14.5 | 256.2361508 | -64.325625 | -19.92894087 | 171.9815849 | 9.809189749
Bi_4a | 9.60 | 252.01 | 2419
Bi_4b | 9.56 | 160.81 | 1537
Pr_a | 6.45 | 188.31 | 1214
Pr_b | 6.32 | 120.17 | 760
B4C_a | 2.49 | 1489.89 | 3709
B4C_b | 2.48 | 950.72 | 2358
 |  | Total Mass | 68.52
