SlaybaughLab/NIF_TNF_ETA/AsConstructed/MCNP_Model/ETA_Fitness_Workup.xlsx

Sheet: Fitness
 | Normed Differential
 | U-opt | Least Squares | Relative Least Squares | Weighted RLS
Ebins | MCNP | MCNP | MCNP | MCNP
TOTAL | 0.440249311 | 0.009872911103 | 69666.57023 | 0.8269294134 | Src | 1500000000000000
4.1399e-07 | 0.0001770291439 | 3.13393178e-08 | 59425.3497 | 1.766463115e-09 | Fission Rate | 1.64033e-05
1.1253e-06 | 2.581654419e-05 | 6.664939537e-10 | 0.8370621748 | 7.904315744e-11 | Volume | 0.0640928
3.059e-06 | 6.57847296e-05 | 4.327630649e-09 | 0.0614515689 | 2.484664634e-09 | Num Fissions | 1577000139
1.0677e-05 | 0.001713859255 | 2.937313545e-06 | 21.17915497 | 1.773098593e-09 | Fitness Bonus | 0.005770001394
2.9023e-05 | 0.006991866894 | 4.888620267e-05 | 348.8305233 | 9.745224457e-08 | Total Fitness | 0.821159412
0.0001013 | 0.04986181976 | 0.002486201069 | 7175.858548 | 2.690626665e-05
0.00027536 | 0.03652969808 | 0.001334418842 | 2018.155357 | 2.129340335e-05
0.00058295 | 0.03279754685 | 0.001075679079 | 567.6069265 | 1.25017616e-05
0.0012341 | 0.01862274751 | 0.0003468067248 | 82.00009202 | 5.682424233e-07
0.0033546 | 0.01290871532 | 0.0001666349312 | 9.8905243 | 1.387067936e-05
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
