SlaybaughLab/NIF_TNF_ETA/AsConstructed/MCNP_Model_Ideal/ETA_Fitness_Workup.xlsx

Sheet: Fitness
 | Normed Differential
 | U-opt | Least Squares | Relative Least Squares | Weighted RLS
Ebins | MCNP | MCNP | MCNP | MCNP
TOTAL | 0.4042423464 | 0.007745559282 | 5607.108488 | 0.8263998935 | Src | 1500000000000000
4.1399e-07 | 7.262044339e-07 | 5.273728798e-13 | 1 | 2.039391536e-12 | Fission Rate | 1.64033e-05
1.1253e-06 | 2.821754643e-05 | 7.962299263e-10 | 1 | 1.361538819e-10 | Volume | 0.0640928
3.059e-06 | 0.000265374144 | 7.042343632e-08 | 1 | 3.480964299e-09 | Num Fissions | 1577000139
1.0677e-05 | 0.0003475529115 | 1.207930263e-07 | 0.8709639551 | 1.893193118e-08 | Fitness Bonus | 0.005770001394
2.9023e-05 | 0.00645127341 | 4.161892861e-05 | 296.9744397 | 7.044930161e-08 | Total Fitness | 0.8206298921
0.0001013 | 0.03106777057 | 0.0009652063682 | 2785.85045 | 8.975626232e-06
0.00027536 | 0.0357989768 | 0.00128156674 | 1938.222618 | 1.949506452e-05
0.00058295 | 0.02992325219 | 0.0008954010216 | 472.4790429 | 9.10540941e-06
0.0012341 | 0.01864096442 | 0.0003474855544 | 82.16059666 | 4.836842985e-07
0.0033546 | 0.01311103372 | 0.0001718992051 | 10.20298237 | 1.400829332e-05
0.010333 | 0.01257236698 | 0.0001580644115 | 1.411965449 | 0.0002686628433
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
