SlaybaughLab/NIF_TNF_ETA/AsConstructed/CAD_Models/Assembly Drawings/ETA.JPG

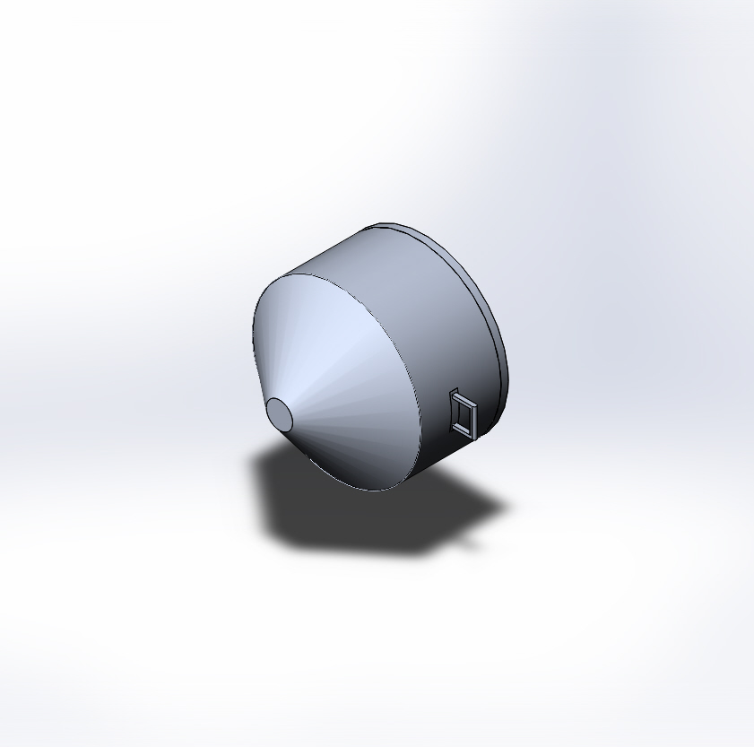
AsConstructed/CAD_Models/Assembly Drawings/ETA.JPG
