SlaybaughLab/NIF_TNF_ETA/AsConstructed/CAD_Models/Assembly Drawings/ETA.PNG

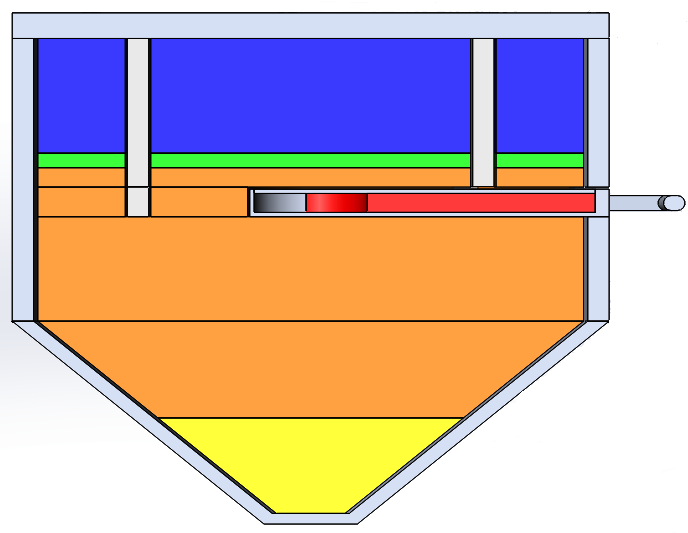
AsConstructed/CAD_Models/Assembly Drawings/ETA.PNG
