SlaybaughLab/NIF_TNF_ETA/AsConstructed/CAD_Models/Assembly Drawings/ETA_inside.JPG

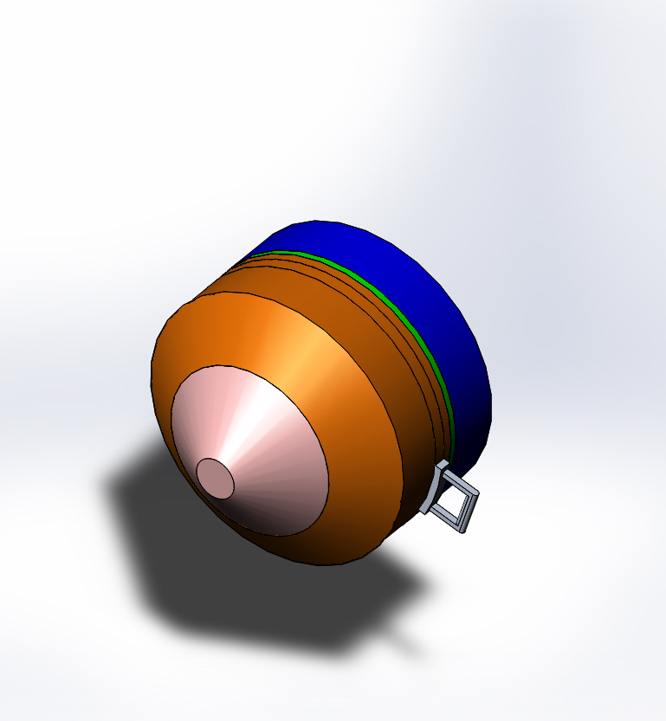
AsConstructed/CAD_Models/Assembly Drawings/ETA_inside.JPG
