SlaybaughLab/NIF_TNF_ETA/AsConstructed/CAD_Models/Assembly Drawings/ETA_inside_cut.JPG

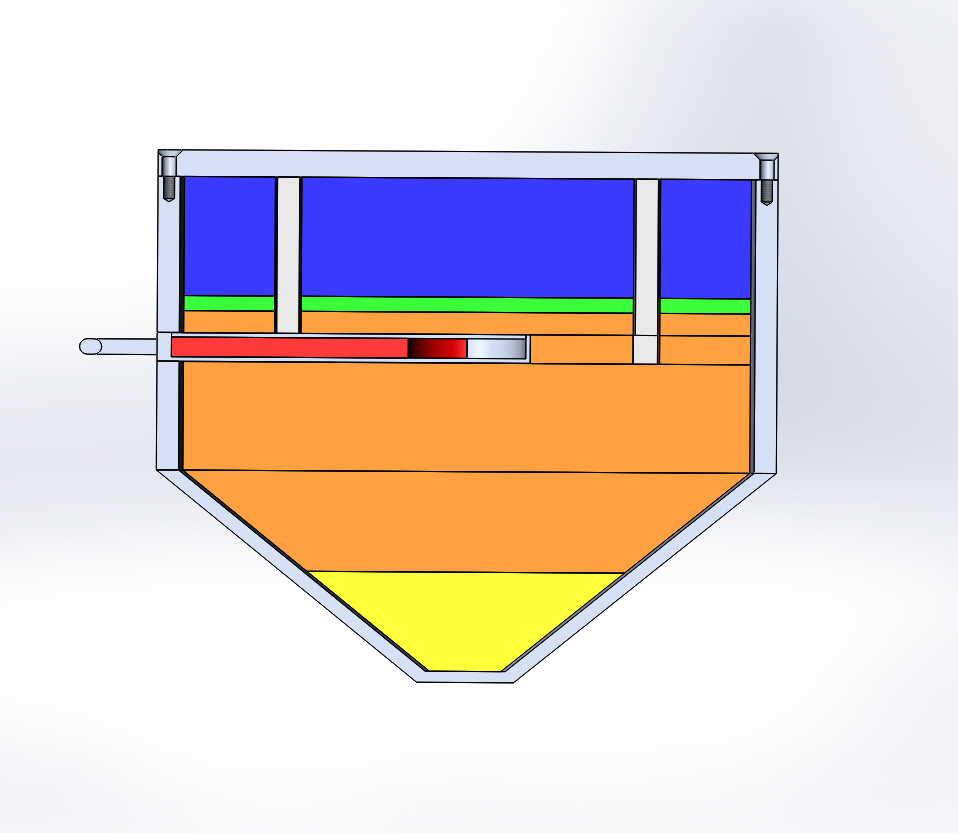
AsConstructed/CAD_Models/Assembly Drawings/ETA_inside_cut.JPG
