SlaybaughLab/NIF_TNF_ETA/AsConstructed/CAD_Models/Assembly Drawings/ETA_labeled.png

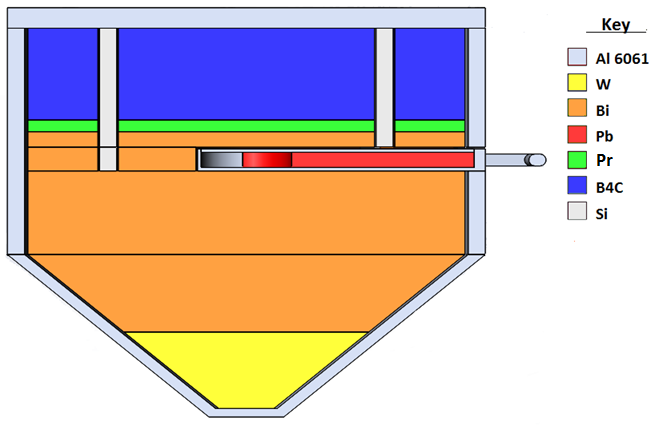
AsConstructed/CAD_Models/Assembly Drawings/ETA_labeled.png
