SlaybaughLab/NIF_TNF_ETA/AsConstructed/Pics/B4CB.jpg

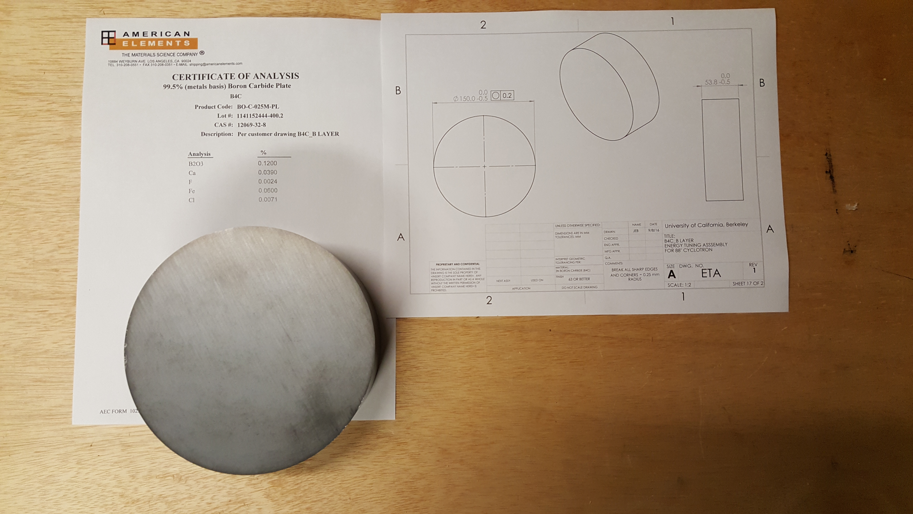
AsConstructed/Pics/B4CB.jpg
