SlaybaughLab/NIF_TNF_ETA/AsConstructed/Pics/Build1_5.jpg

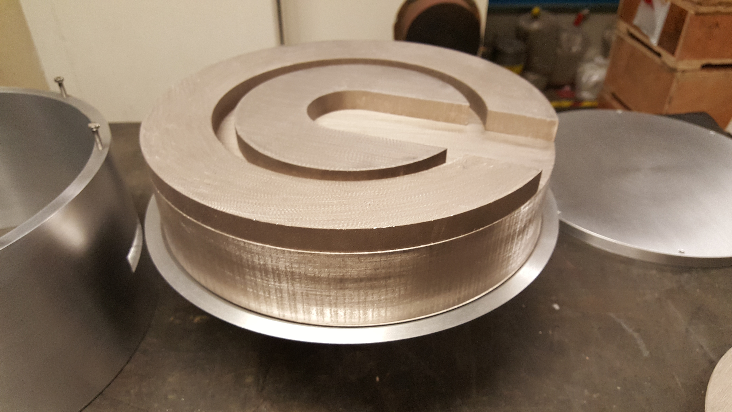
AsConstructed/Pics/Build1_5.jpg
