SlaybaughLab/NIF_TNF_ETA/AsConstructed/Pics/Build1_14.jpg

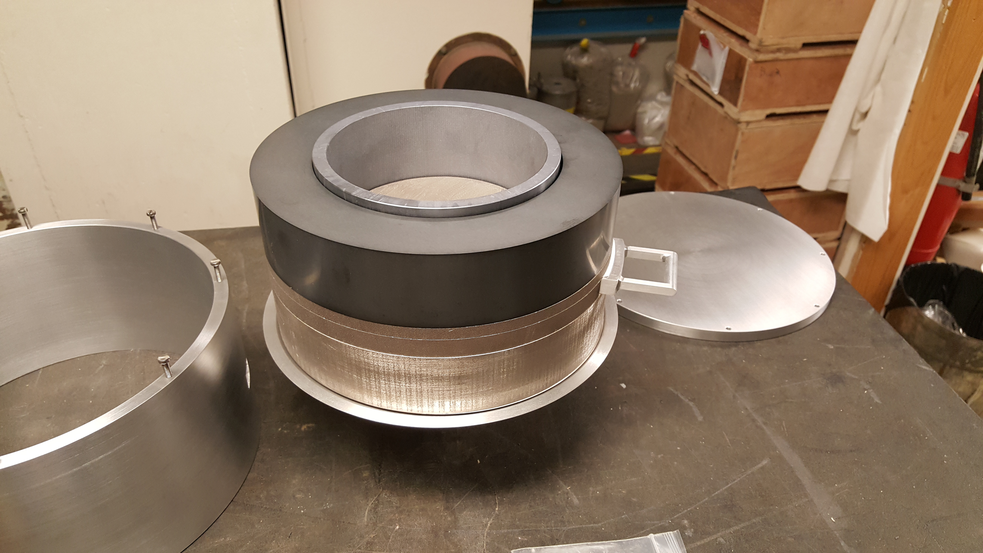
AsConstructed/Pics/Build1_14.jpg
