SlaybaughLab/NIF_TNF_ETA/AsConstructed/Pics/Build1_17.jpg

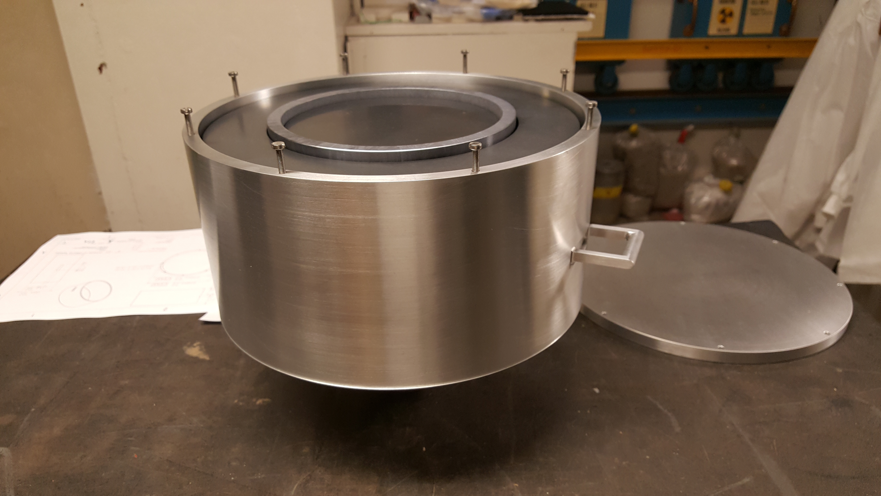
AsConstructed/Pics/Build1_17.jpg
