SlaybaughLab/NIF_TNF_ETA/AsConstructed/Pics/Build1_18.jpg

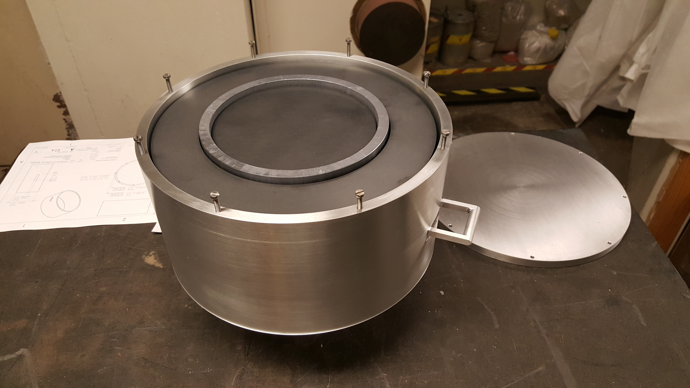
AsConstructed/Pics/Build1_18.jpg
