SlaybaughLab/NIF_TNF_ETA/AsConstructed/Pics/Build1_19.jpg

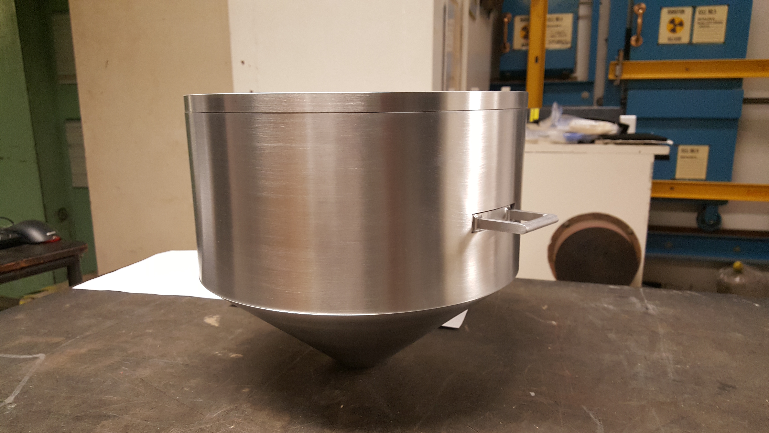
AsConstructed/Pics/Build1_19.jpg
