SlaybaughLab/NIF_TNF_ETA/AsConstructed/Pics/Build2_6a.jpg

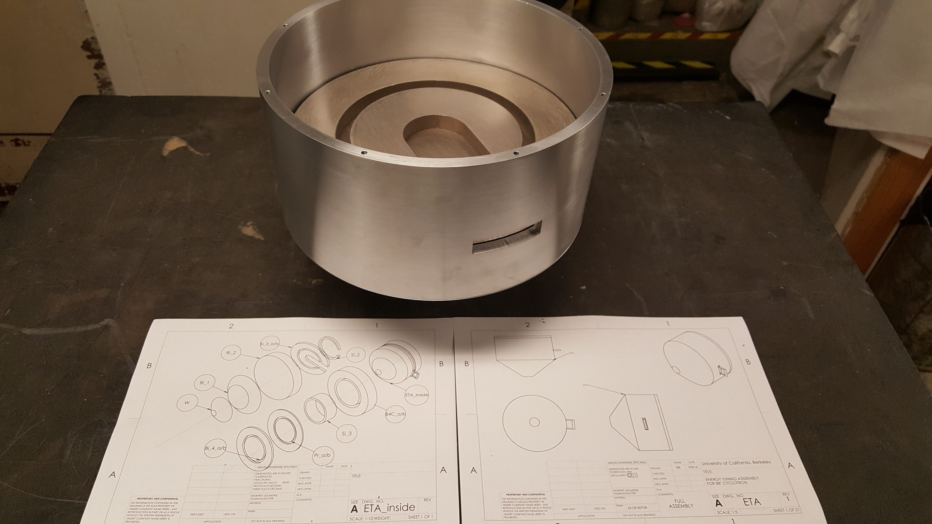
AsConstructed/Pics/Build2_6a.jpg
