SlaybaughLab/NIF_TNF_ETA/AsConstructed/Pics/Build2_9a.jpg

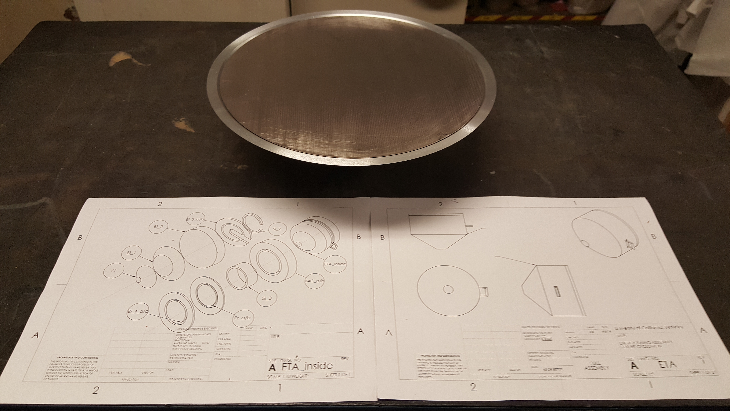
AsConstructed/Pics/Build2_9a.jpg
