SlaybaughLab/NIF_TNF_ETA/AsConstructed/Pics/Duplicates/2017-03-23 08.36.02.jpg

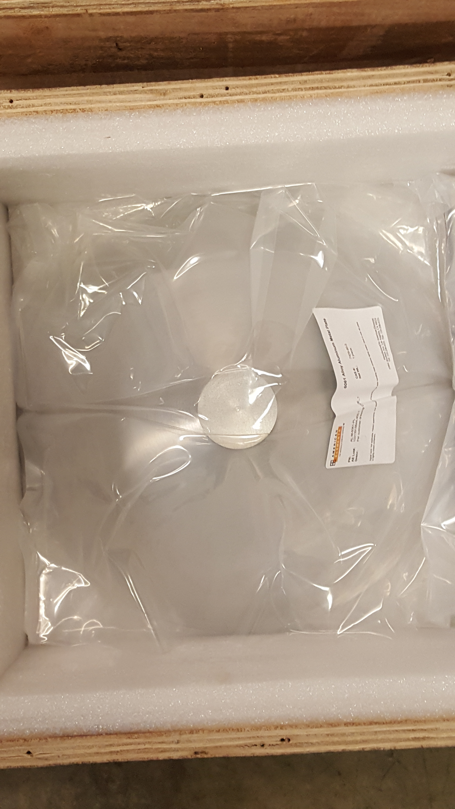
AsConstructed/Pics/Duplicates/2017-03-23 08.36.02.jpg
