SlaybaughLab/NIF_TNF_ETA/AsConstructed/Plots/88_vs_TN+PFNS.png

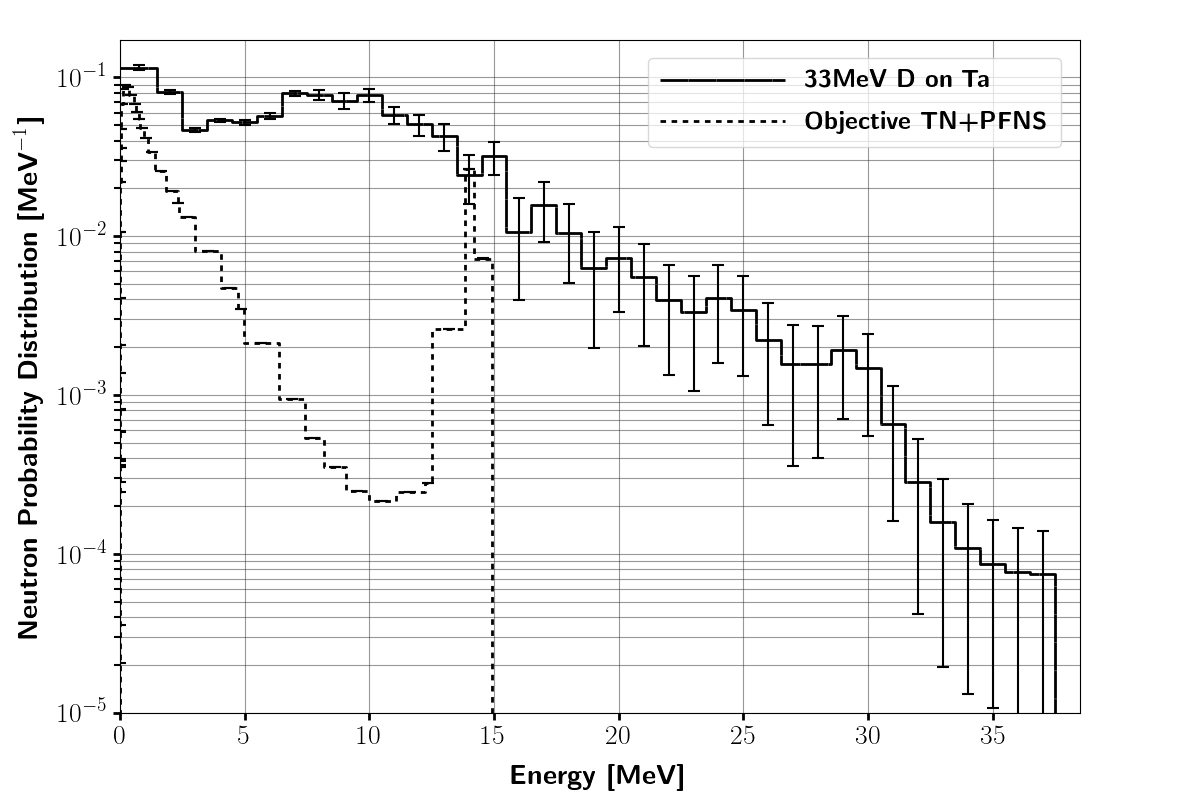
AsConstructed/Plots/88_vs_TN+PFNS.png
