SlaybaughLab/NIF_TNF_ETA/AsConstructed/Plots/ETA_Output.png

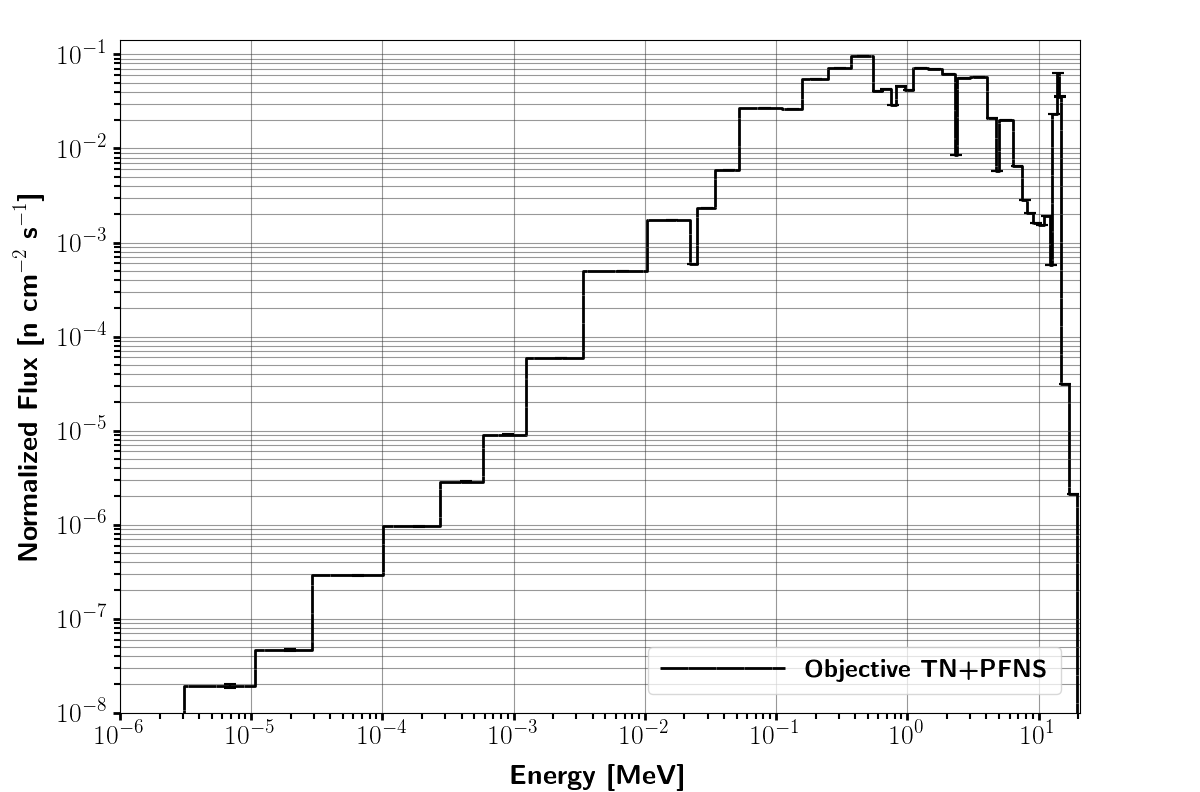
AsConstructed/Plots/ETA_Output.png
