SlaybaughLab/NIF_TNF_ETA/AsConstructed/Plots/ETA_Output_Diff.png

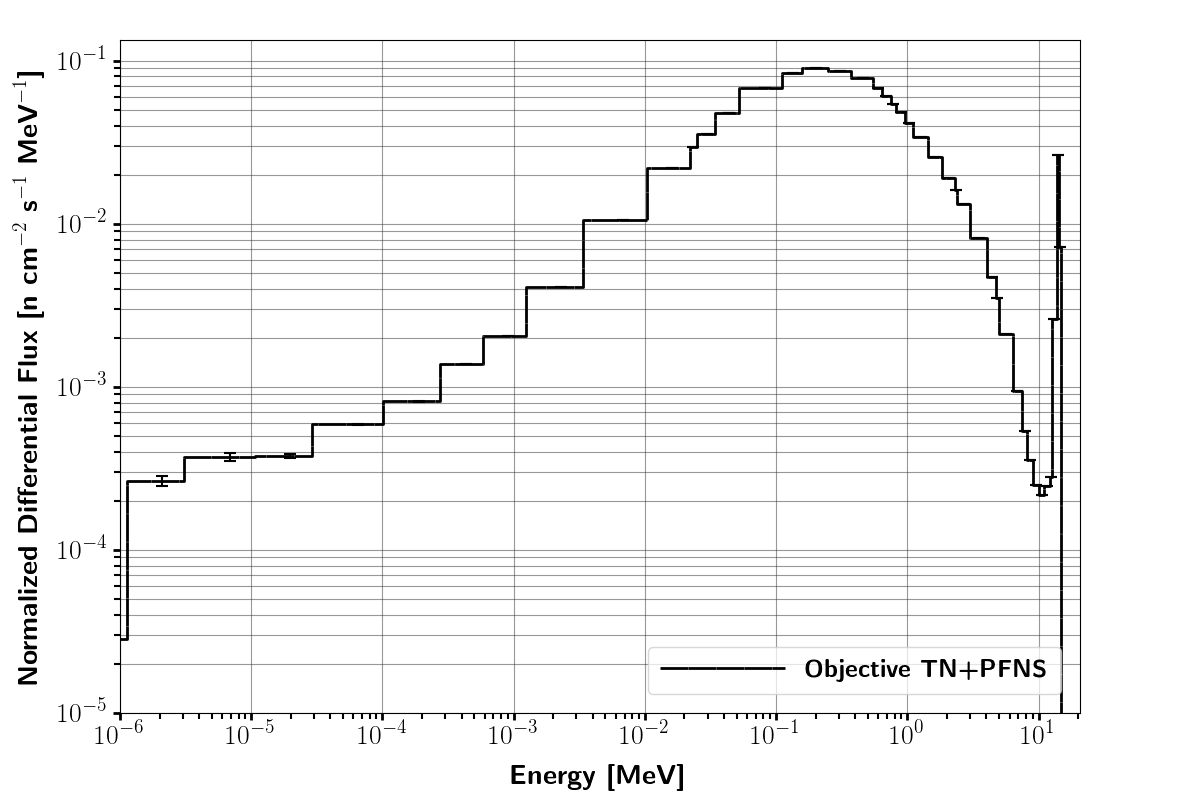
AsConstructed/Plots/ETA_Output_Diff.png
