SlaybaughLab/NIF_TNF_ETA/AsConstructed/Plots/ETA_Output_vs_Obj_Diff.png

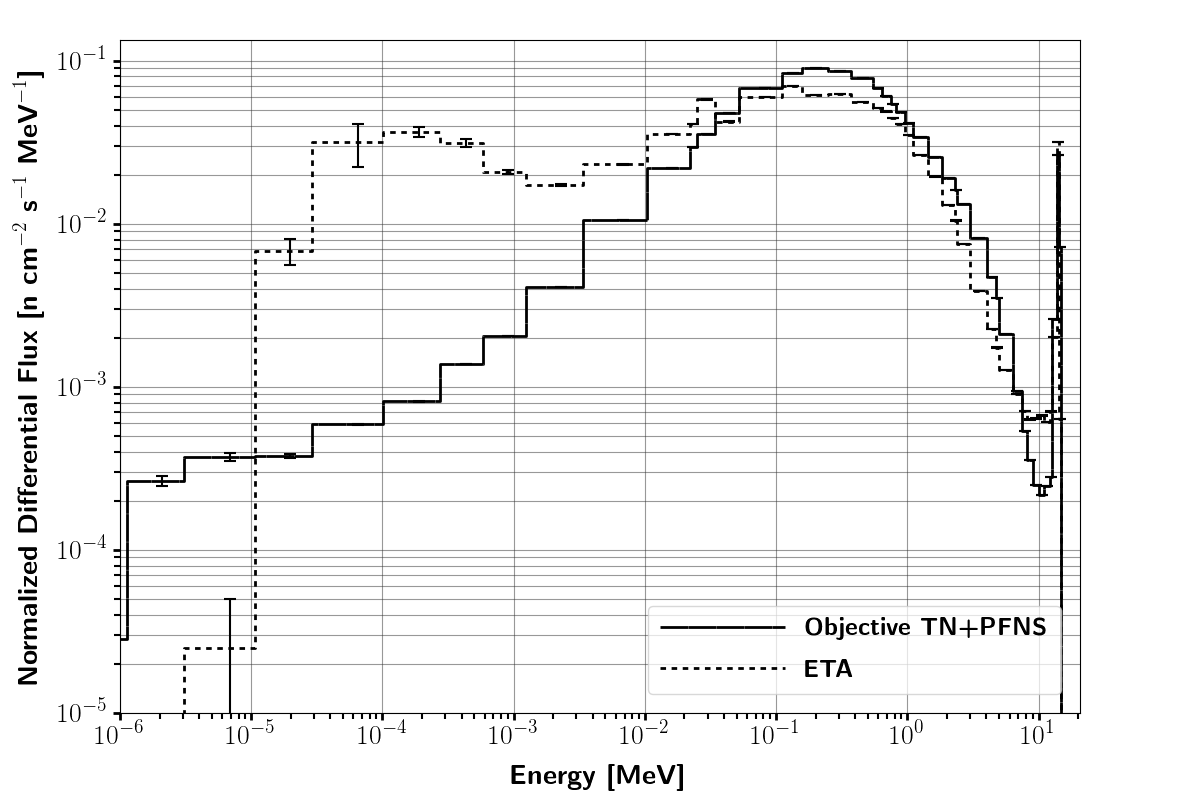
AsConstructed/Plots/ETA_Output_vs_Obj_Diff.png
