SlaybaughLab/NIF_TNF_ETA/AsConstructed/Plots/NIF_vs_TN+PFNS.png

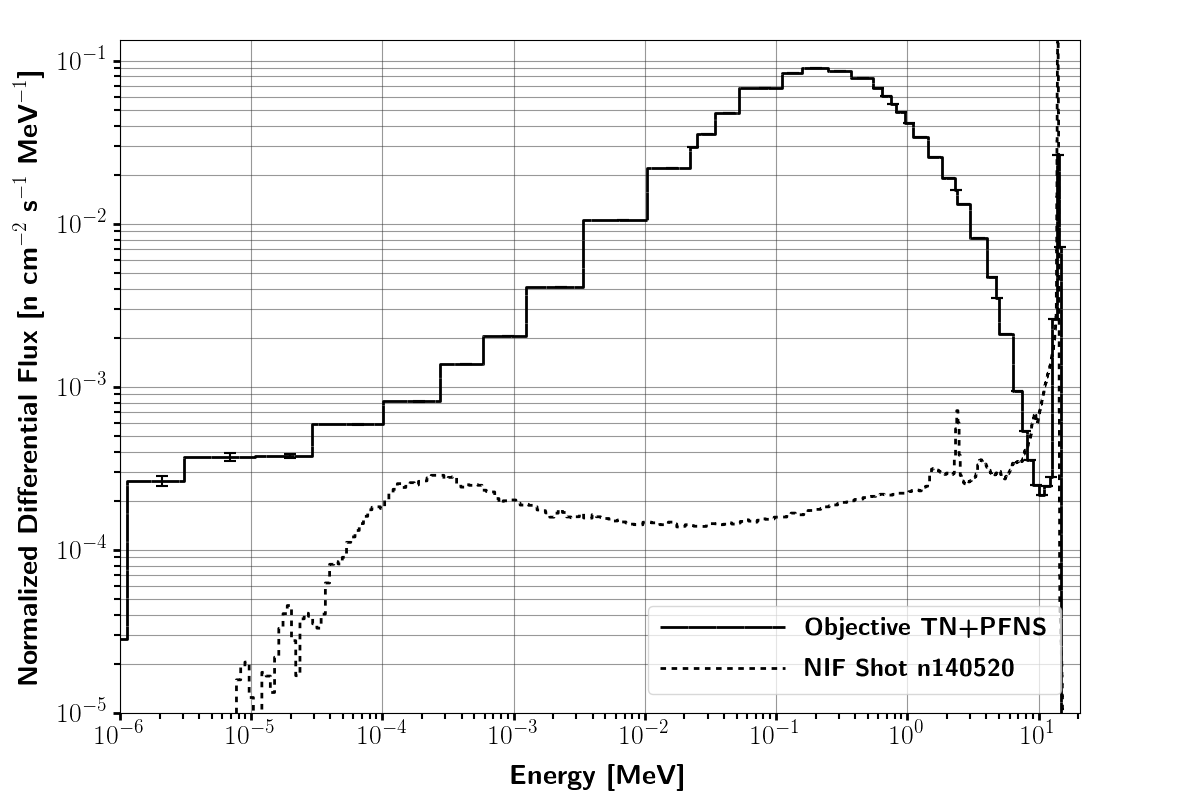
AsConstructed/Plots/NIF_vs_TN+PFNS.png
