SlaybaughLab/NIF_TNF_ETA/InitialQuoted/Drawings/ETA_CAD_Model/Assembly Drawings/ETA.JPG

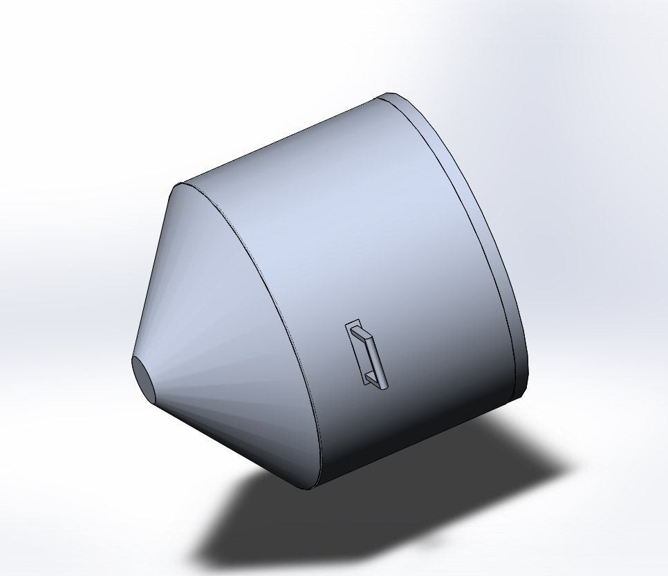
InitialQuoted/Drawings/ETA_CAD_Model/Assembly Drawings/ETA.JPG
