SlaybaughLab/NIF_TNF_ETA/InitialQuoted/Drawings/ETA_CAD_Model/Assembly Drawings/ETA_inside_cut.JPG

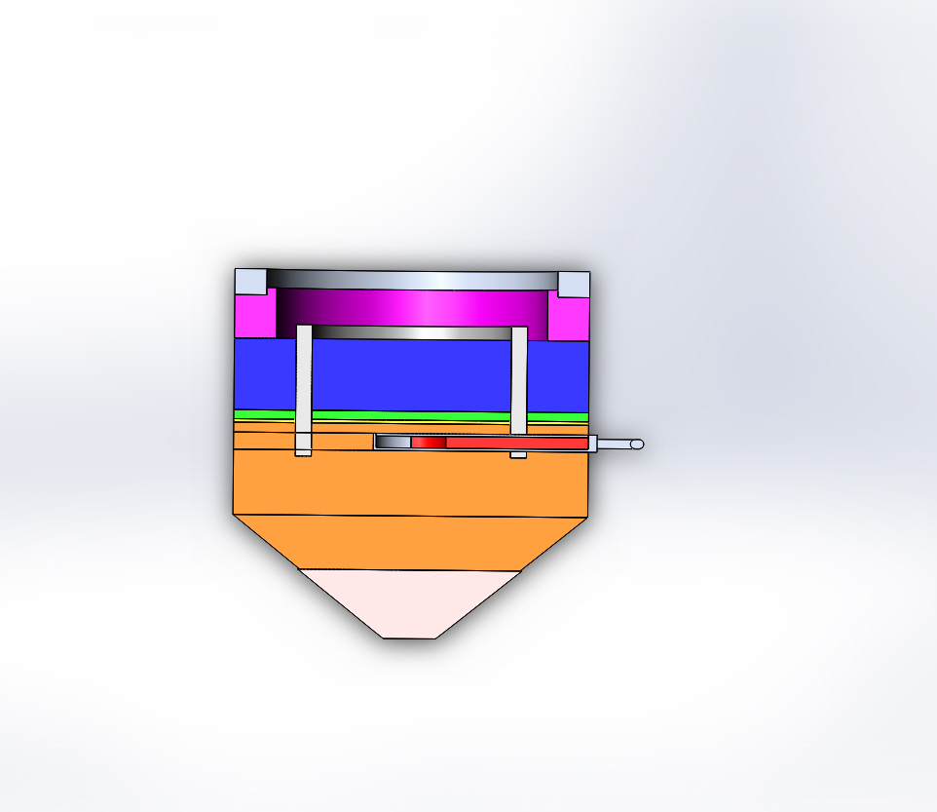
InitialQuoted/Drawings/ETA_CAD_Model/Assembly Drawings/ETA_inside_cut.JPG
