SlaybaughLab/NIF_TNF_ETA/CouesOutputs/Results/ETA_4575_Fitness_Workup.xlsx

Sheet: Fitness
 | Normed Differential
 | U-opt | Least Squares | Relative Least Squares | Weighted RLS
Ebins | MCNP | MCNP | MCNP | MCNP
TOTAL | 0.2250159976 | 0.002476290761 | 2014.709954 | 0.7952187947 | Src | 1500000000000000
4.1399e-07 | 3.596277768e-07 | 1.293321378e-13 | 1 | 2.039391536e-12 | Fission Rate | 1.59062e-05
1.1253e-06 | 1.418273427e-05 | 2.011499513e-10 | 1 | 1.361538819e-10 | Volume | 0.0640928
3.059e-06 | 0.0001365543619 | 1.864709375e-08 | 1 | 3.480964299e-09 | Num Fissions | 1529209343
1.0677e-05 | 0.0002177758591 | 4.742632482e-08 | 1 | 1.924481204e-08 | Fitness Bonus | 0.00529209343
2.9023e-05 | 0.0004764324111 | 2.269878424e-07 | 3.307724974 | 1.150229972e-08 | Total Fitness | 0.7899267013
0.0001013 | 0.008881655575 | 7.888380575e-05 | 688.2852259 | 2.451109553e-06
0.00027536 | 0.01684898823 | 0.0002838884044 | 1035.062697 | 1.028547774e-05
0.00058295 | 0.01351926577 | 0.0001827705471 | 220.9152793 | 1.727328089e-07
0.0012341 | 0.008244710105 | 6.797524472e-05 | 37.83216858 | 3.81340748e-07
0.0033546 | 0.00557316507 | 3.10601689e-05 | 5.646618233 | 2.345223744e-05
0.010333 | 0.004318290747 | 1.864763497e-05 | 0.5435674353 | 0.0003191686195
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
