SlaybaughLab/NIF_TNF_ETA/CouesOutputs/Results/25.png

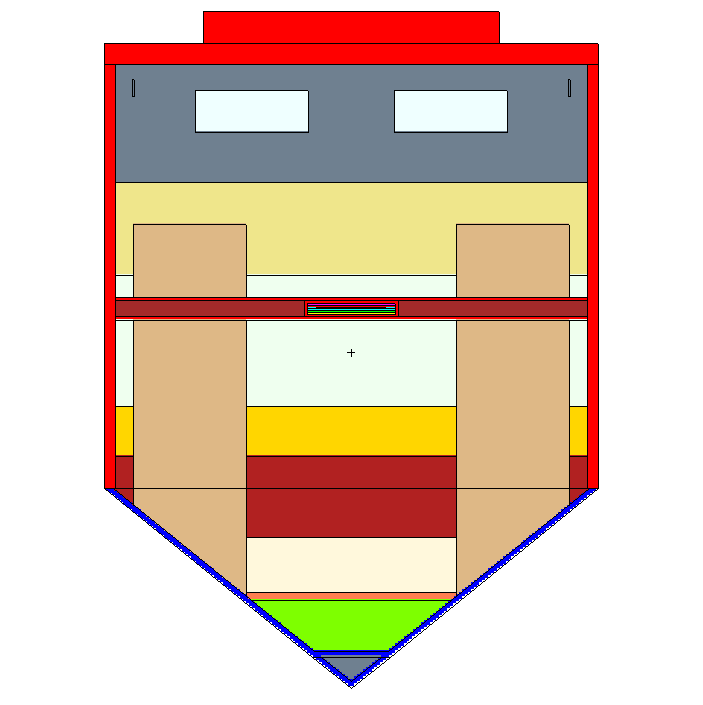
CouesOutputs/Results/25.png
