SlaybaughLab/NIF_TNF_ETA/CouesOutputs/Results/114.png

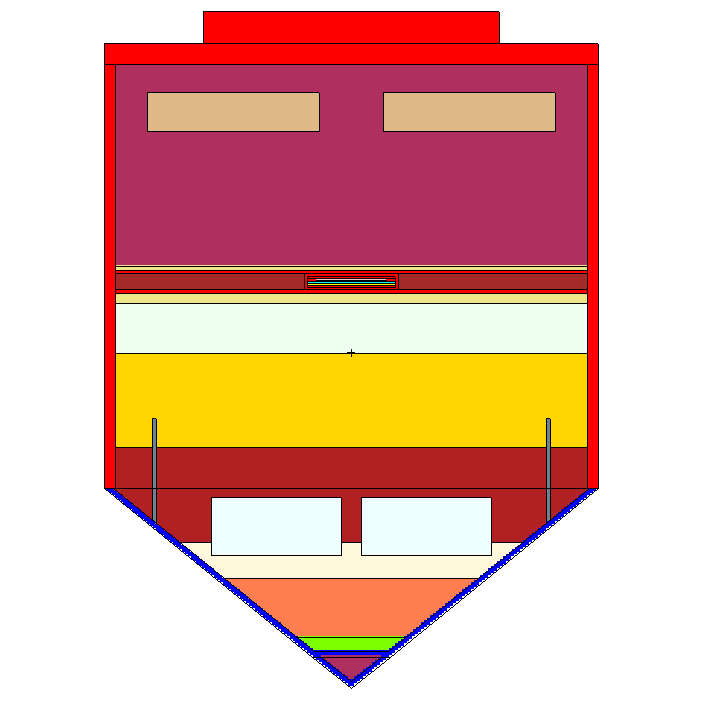
CouesOutputs/Results/114.png
