SlaybaughLab/NIF_TNF_ETA/CouesOutputs/Results/140.png

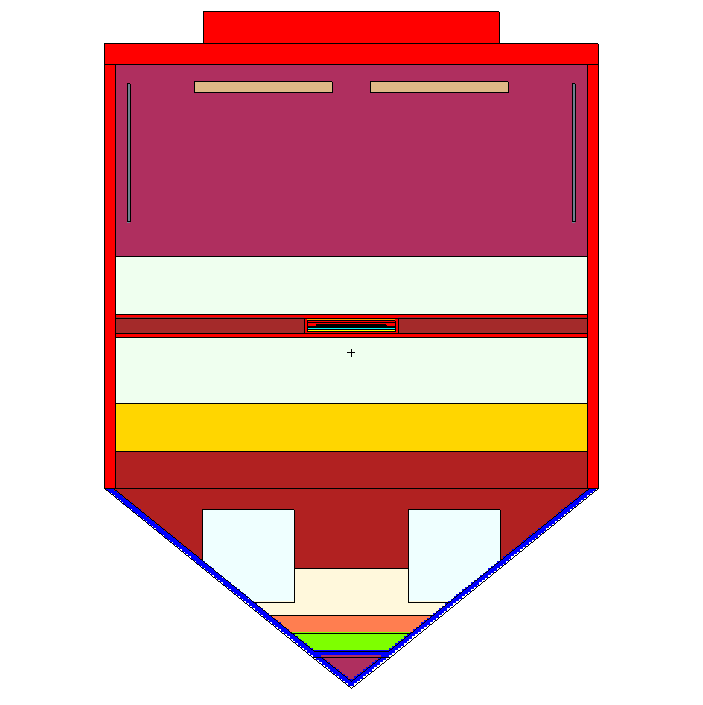
CouesOutputs/Results/140.png
