SlaybaughLab/NIF_TNF_ETA/CouesOutputs/Results/259.png

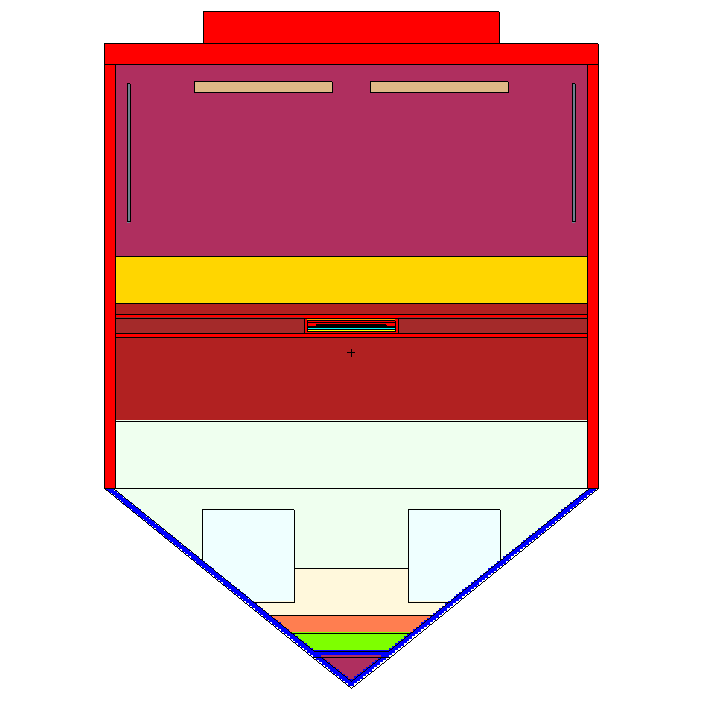
CouesOutputs/Results/259.png
