SlaybaughLab/NIF_TNF_ETA/CouesOutputs/Results/467.png

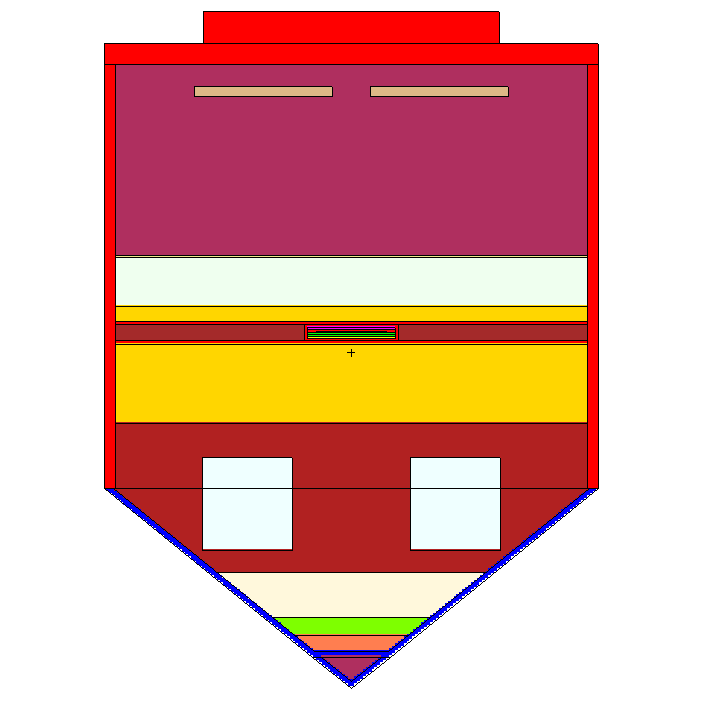
CouesOutputs/Results/467.png
