SlaybaughLab/NIF_TNF_ETA/CouesOutputs/Results/542.png

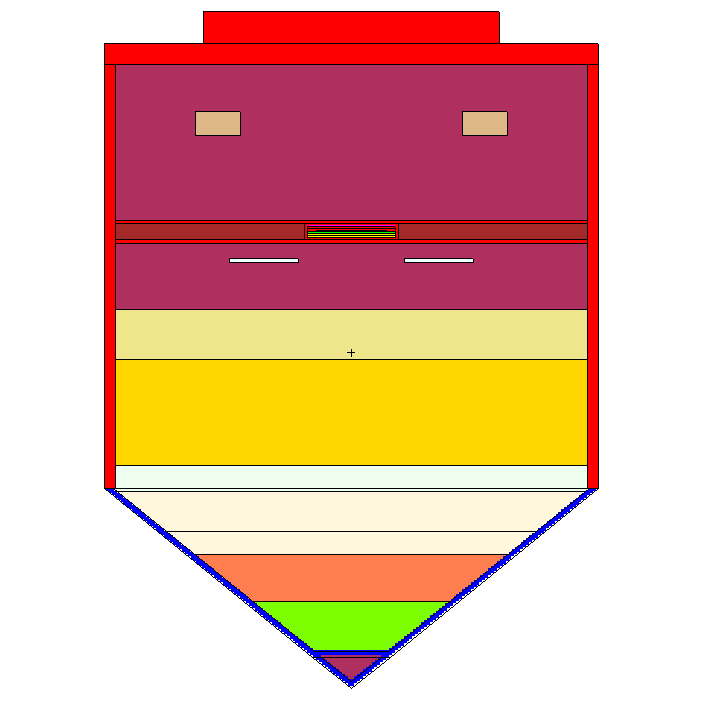
CouesOutputs/Results/542.png
