SlaybaughLab/NIF_TNF_ETA/CouesOutputs/Results/754.png

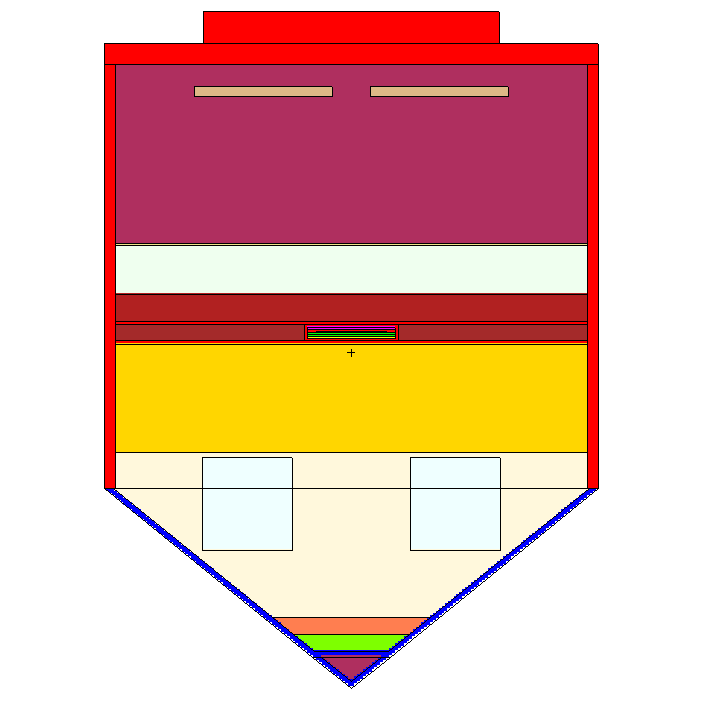
CouesOutputs/Results/754.png
