SlaybaughLab/NIF_TNF_ETA/CouesOutputs/Results/2492.png

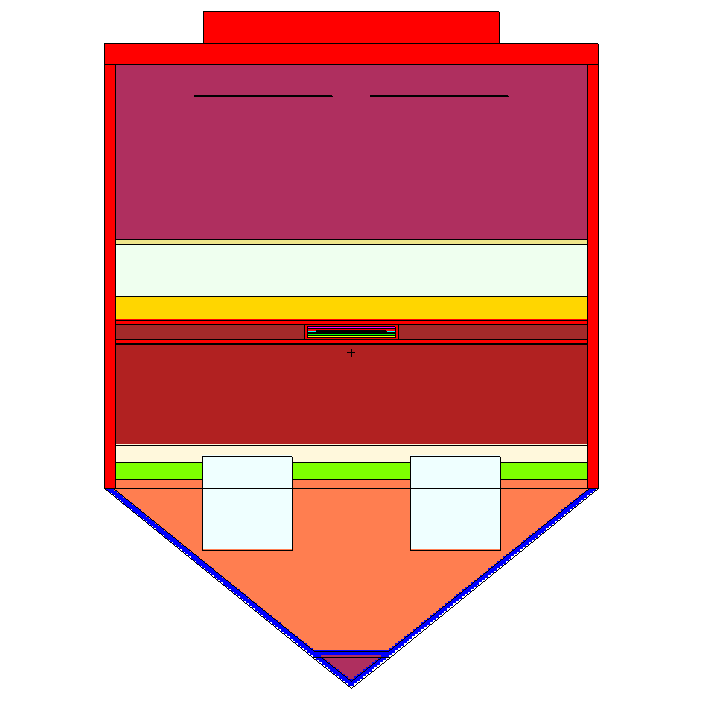
CouesOutputs/Results/2492.png
