SlaybaughLab/NIF_TNF_ETA/CouesOutputs/Results/2755.png

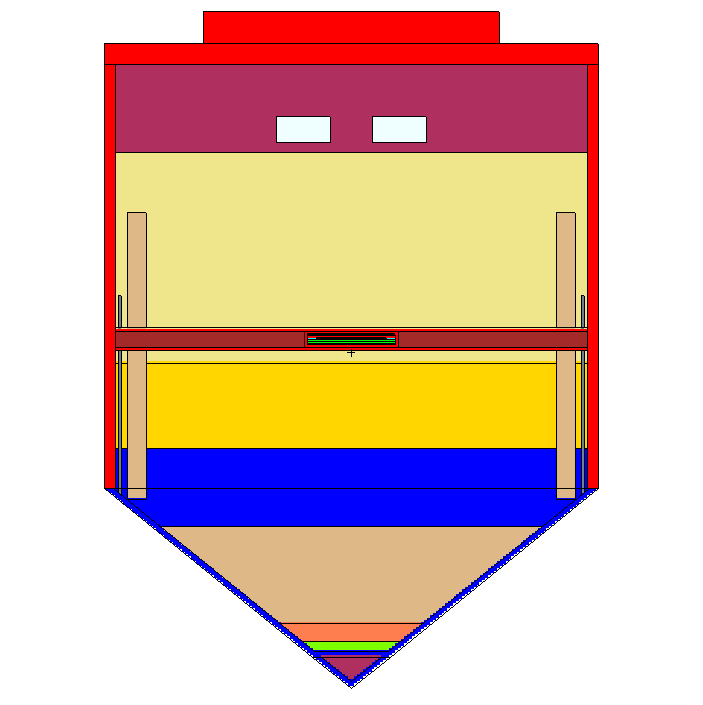
CouesOutputs/Results/2755.png
