SlaybaughLab/NIF_TNF_ETA/CouesOutputs/Results/2836.png

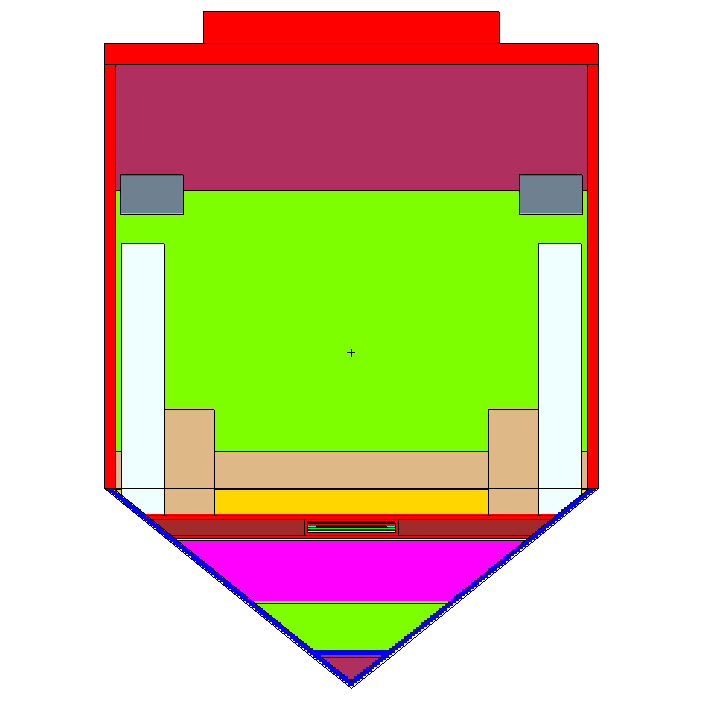
CouesOutputs/Results/2836.png
