SlaybaughLab/NIF_TNF_ETA/CouesOutputs/Results/3160.png

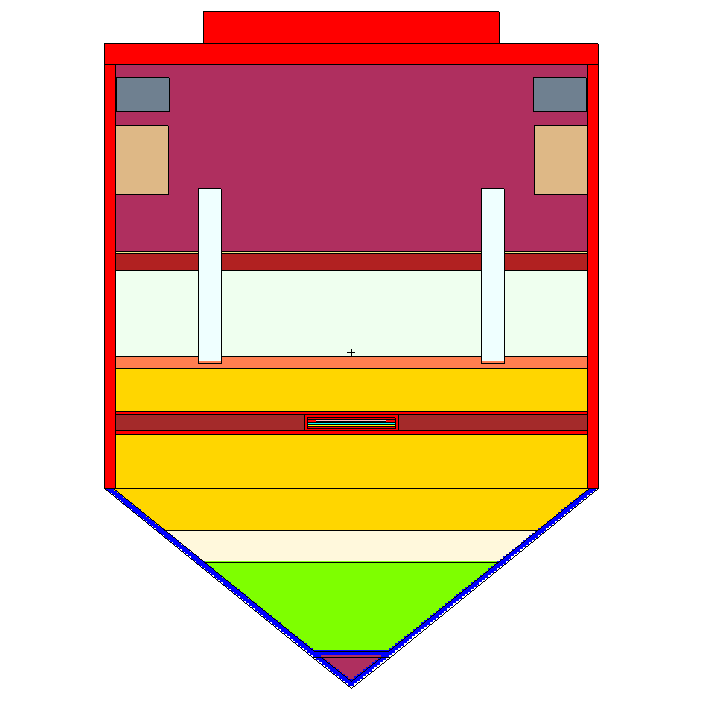
CouesOutputs/Results/3160.png
