SlaybaughLab/NIF_TNF_ETA/CouesOutputs/Results/3955.png

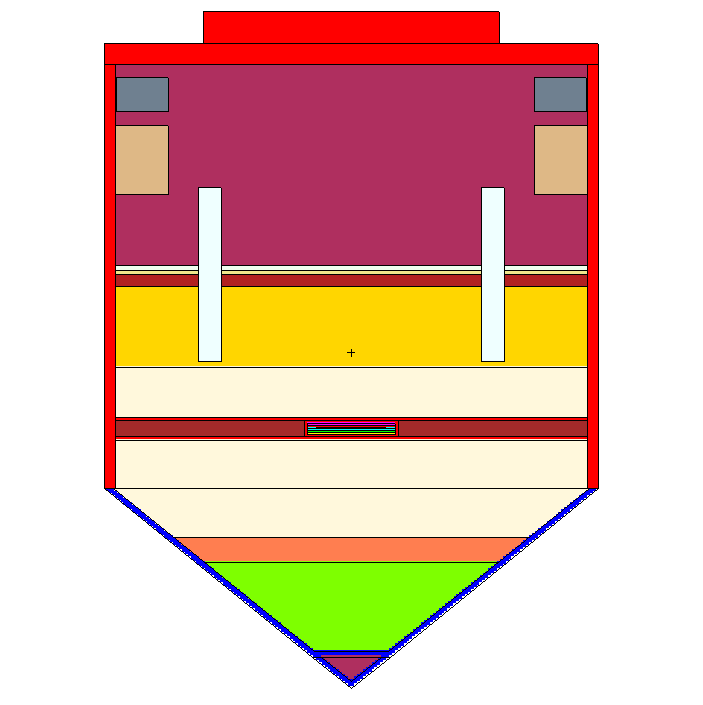
CouesOutputs/Results/3955.png
