SlaybaughLab/NIF_TNF_ETA/CouesOutputs/Results/4390_mod_labeled.png

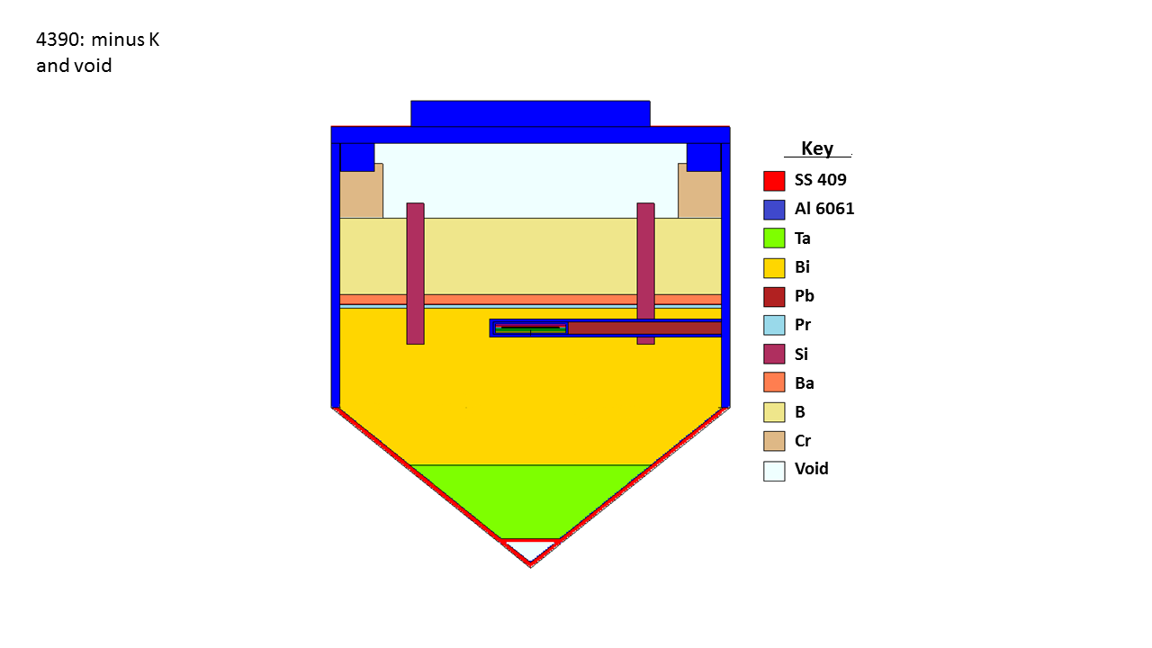
CouesOutputs/Results/4390_mod_labeled.png
