SlaybaughLab/NIF_TNF_ETA/CouesOutputs/Results/4575_labeled.png

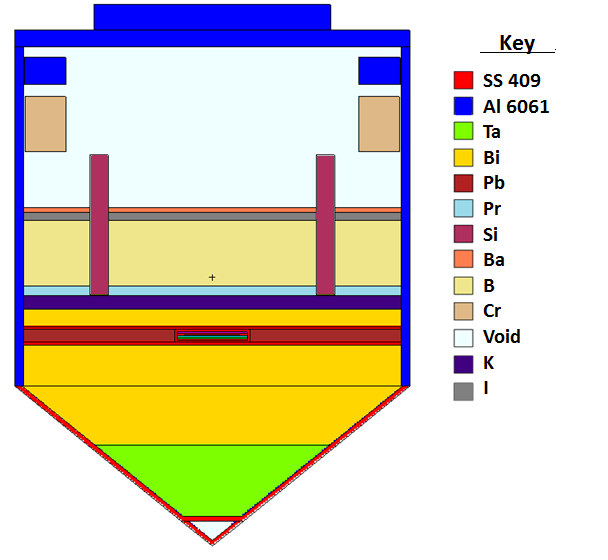
CouesOutputs/Results/4575_labeled.png
