SlaybaughLab/NIF_TNF_ETA/CouesOutputs/Results/converge_plot.png

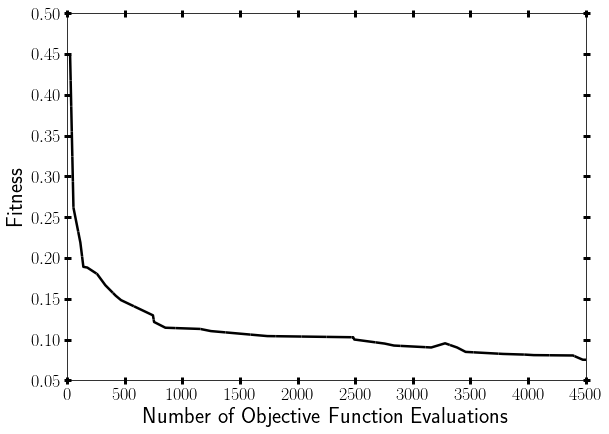
CouesOutputs/Results/converge_plot.png
