SlaybaughLab/NIF_TNF_ETA/CouesOutputs/Results/pop_plot.png

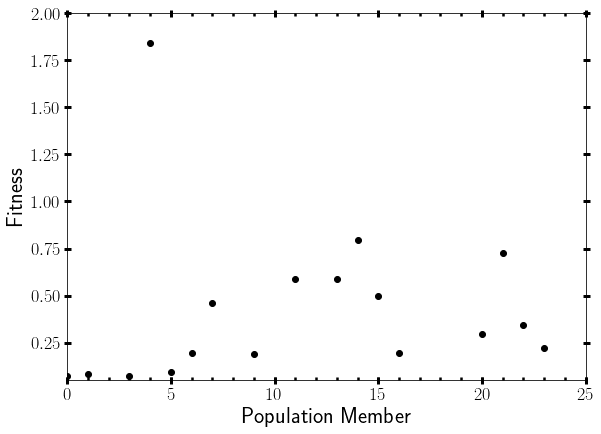
CouesOutputs/Results/pop_plot.png
