SlaybaughLab/NIF_TNF_ETA/CouesOutputs/Results/Snapshots.png

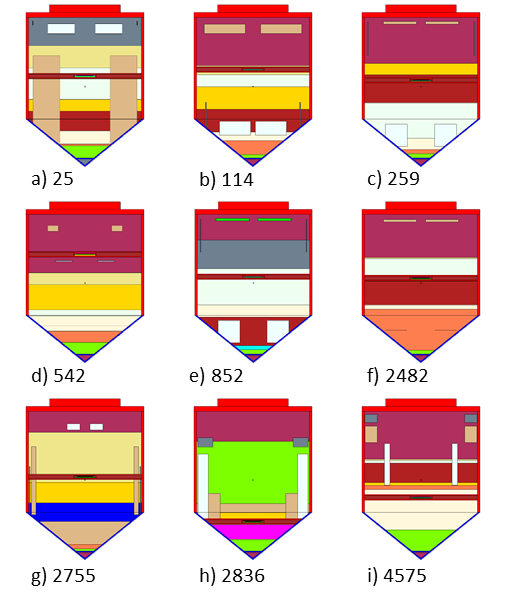
CouesOutputs/Results/Snapshots.png
