SlaybaughLab/NIF_TNF_ETA/AsConstructed/CAD_Models/Machined Parts/Drawings/B4C_a_m.PDF

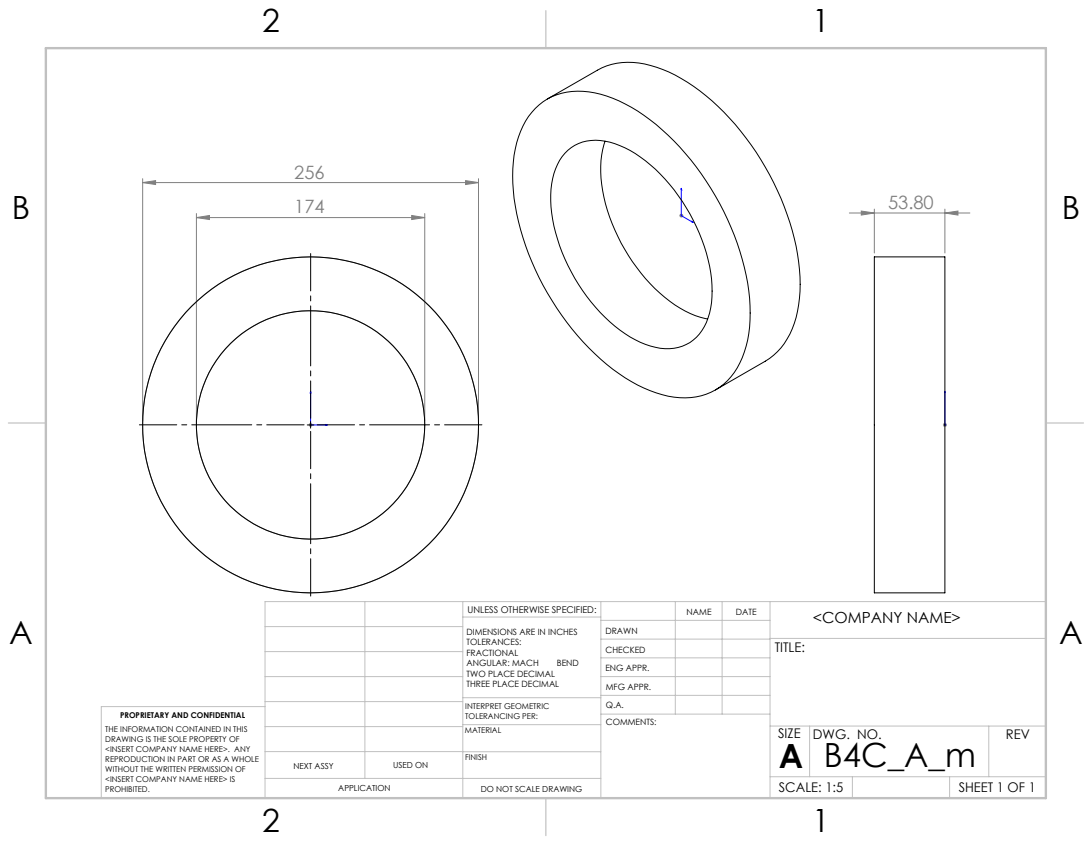
[picture p140: page 1]

UNLESS OTHERWISE SPECIFIED: | | NAME | DATE | <COMPANY NAME>
DIMENSIONS ARE IN INCHES TOLERANCES: FRACTIONAL ANGULAR: MACH BEND TWO PLACE DECIMAL THREE PLACE DECIMAL | DRAWN

CHECKED | | | TITLE:

ENG APPR.
MFG APPR.

INTERPRET GEOMETRIC TOLERANCING PER: | Q.A.

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

USED ON | MATERIAL | | SIZE A | DWG. NO. B4C_A_m | REV

NEXT ASSY | | FINISH

APPLICATION | DO NOT SCALE DRAWING | | SCALE: 1:5 | | SHEET 1 OF 1
