SlaybaughLab/NIF_TNF_ETA/(commit log)

2017-06-17 Initial commit of design files
    [Activation.xlsx, Al.SLDDRW, Al.SLDPRT, B.SLDDRW, B.SLDPRT, B4C.SLDDRW, B4C.SLDPRT, B4C_a_m.SLDDRW]
2017-06-26 Updated MCNP models of the ETA
    - Added as constructed densities and geometry
    - Created model for the idealized final, as constructed geometry
    [ETA_Fitness_Workup.xlsx, ETA_Masses.xlsx]
2017-07-04 Modified folder structure
    - Made the organization of the data easier to understand
    [ETA_4575_Fitness_Workup.xlsx, advantg_settings.csv, eta_constraints.csv, eta_materials_compendium.csv, gnowee_settings.csv, mcnp_settings.csv, obj_spectrum.csv, source.csv]
