SlaybaughLab/NIF_TNF_ETA/AsConstructed/Pics/Case3.jpg

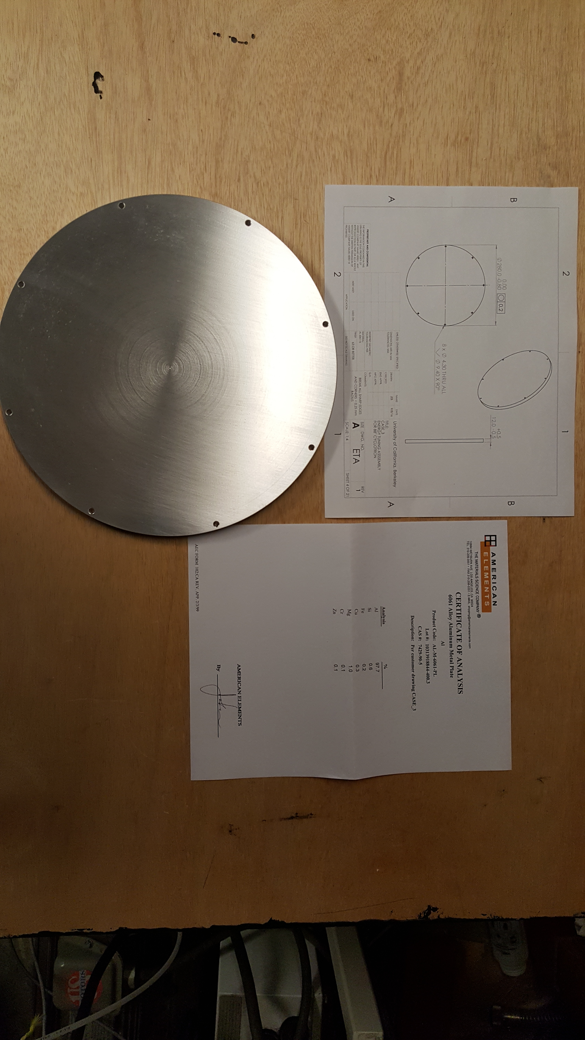
AsConstructed/Pics/Case3.jpg
