SlaybaughLab/NIF_TNF_ETA/AsConstructed/Pics/Duplicates/2017-03-23 08.36.50.jpg

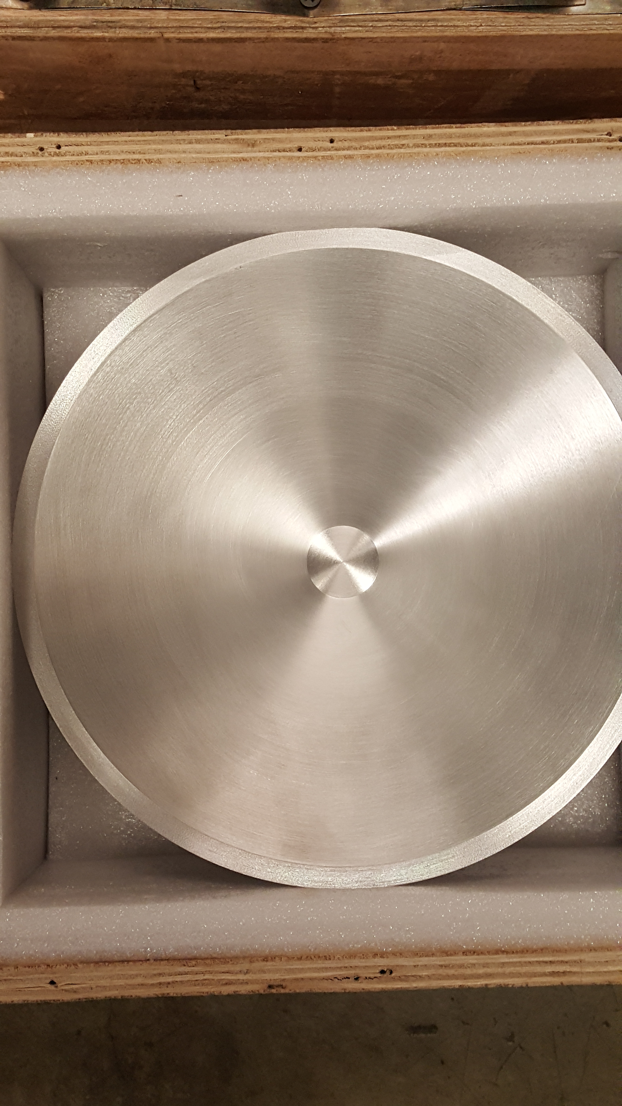
AsConstructed/Pics/Duplicates/2017-03-23 08.36.50.jpg
