SlaybaughLab/NIF_TNF_ETA/AsConstructed/Pics/Duplicates/2017-03-23 08.44.00.jpg

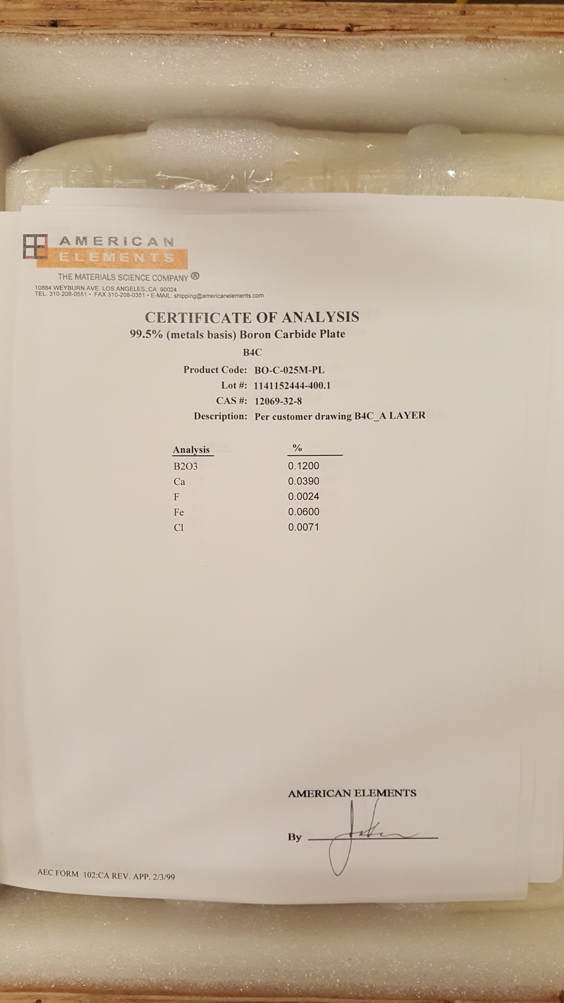
AsConstructed/Pics/Duplicates/2017-03-23 08.44.00.jpg
