SlaybaughLab/NIF_TNF_ETA/AsConstructed/Pics/Duplicates/2017-03-23 08.51.56.jpg

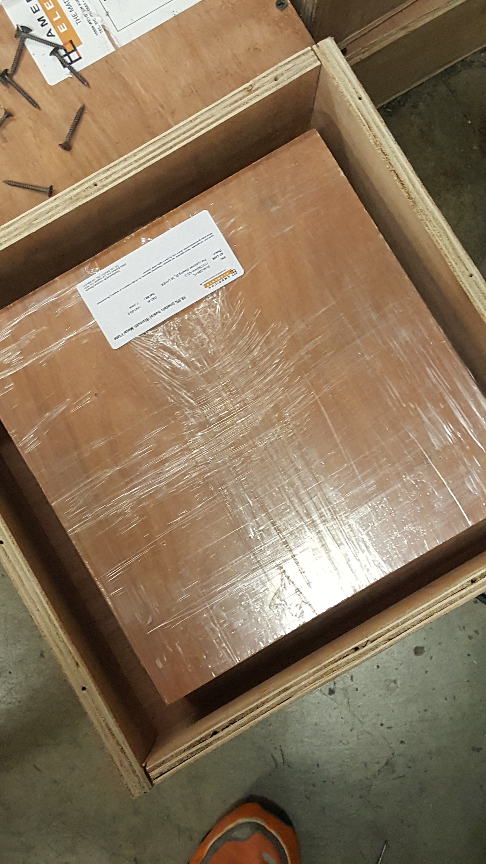
AsConstructed/Pics/Duplicates/2017-03-23 08.51.56.jpg
