SlaybaughLab/NIF_TNF_ETA/AsConstructed/Pics/Duplicates/2017-03-23 08.52.05.jpg

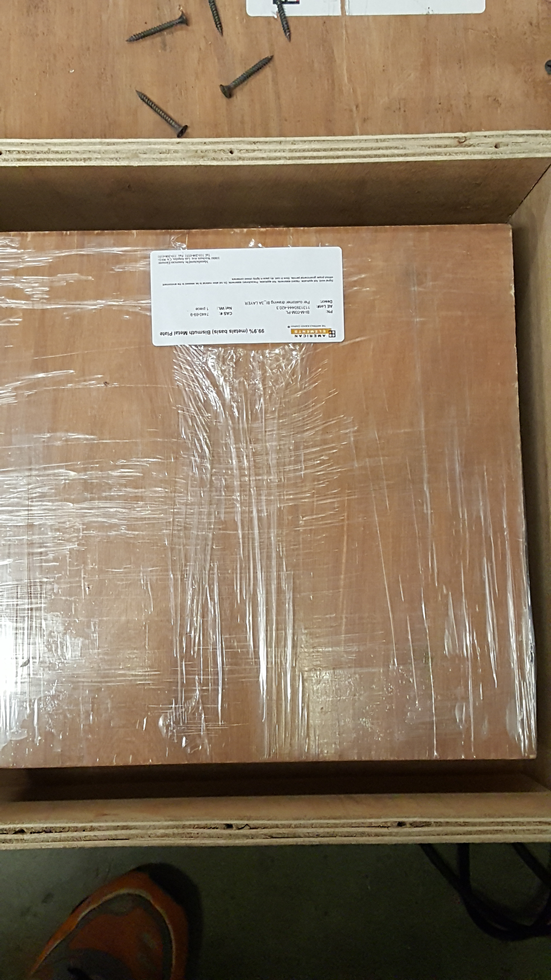
AsConstructed/Pics/Duplicates/2017-03-23 08.52.05.jpg
