SlaybaughLab/NIF_TNF_ETA/AsConstructed/Pics/Duplicates/2017-03-23 08.55.31.jpg

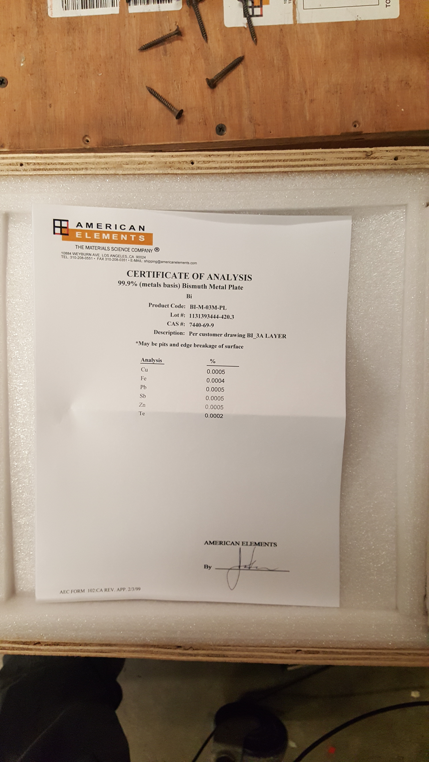
AsConstructed/Pics/Duplicates/2017-03-23 08.55.31.jpg
