SlaybaughLab/NIF_TNF_ETA/AsConstructed/Pics/Duplicates/2017-03-23 09.04.57.jpg

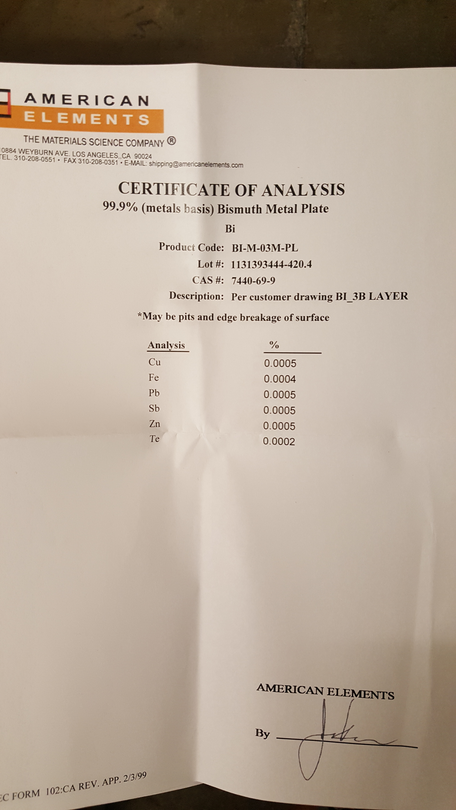
AsConstructed/Pics/Duplicates/2017-03-23 09.04.57.jpg
