SlaybaughLab/NIF_TNF_ETA/AsConstructed/Pics/Duplicates/2017-03-23 14.05.01.jpg

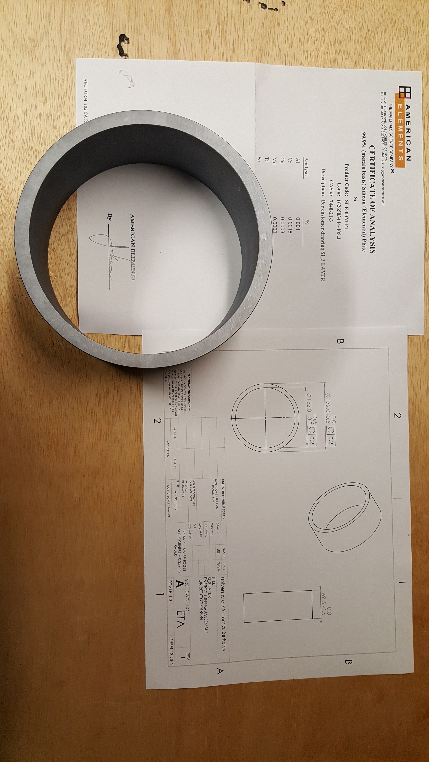
AsConstructed/Pics/Duplicates/2017-03-23 14.05.01.jpg
