SlaybaughLab/NIF_TNF_ETA/AsConstructed/Pics/Duplicates/W_2.jpg

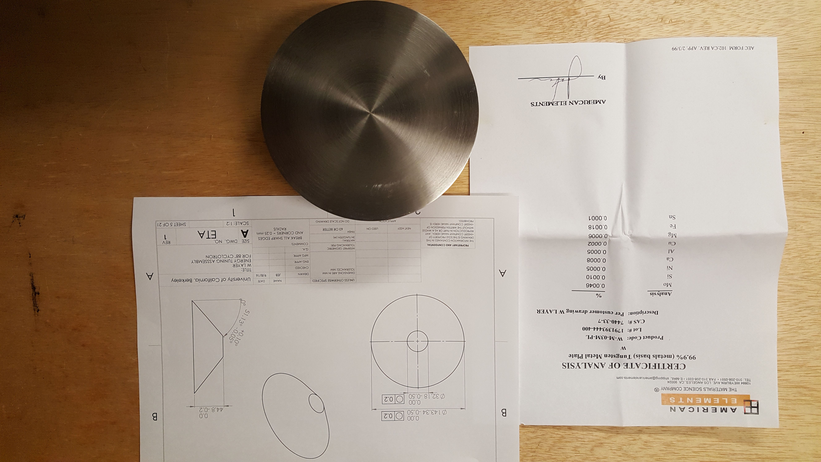
AsConstructed/Pics/Duplicates/W_2.jpg
