SlaybaughLab/NIF_TNF_ETA/AsConstructed/Pics/Pics/Si3.jpg

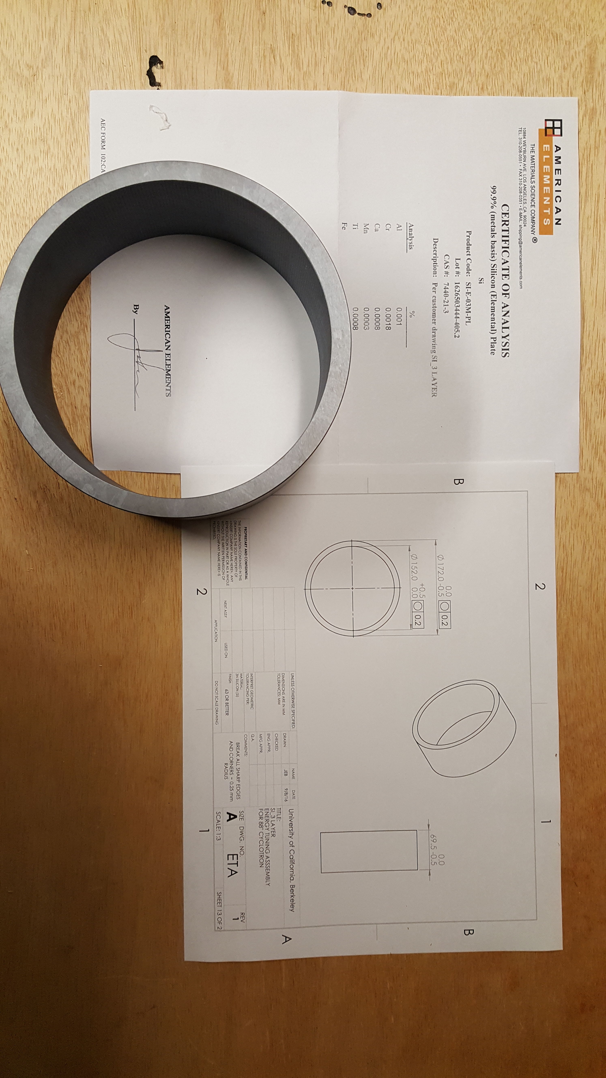
AsConstructed/Pics/Pics/Si3.jpg
