SlaybaughLab/NIF_TNF_ETA/AsConstructed/Pics/Case.jpg

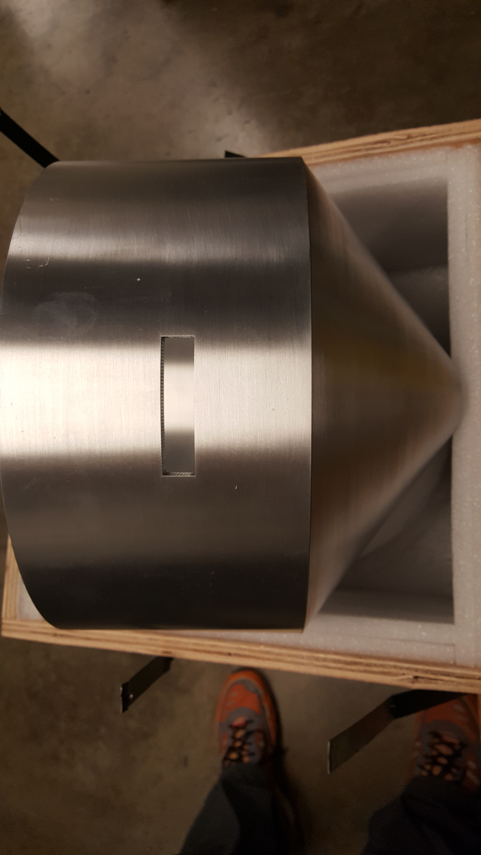
AsConstructed/Pics/Case.jpg
